hchouTW/hep-research/plugins/hep-research/profiles/reference/detector-atlas/README.md

# detector-atlas

A reference profile (kind `reference`): the sourced detector atlas of hep-research (work order item D13). It holds an
evidence ledger of detector facts for twelve experiments; the tool that validates, renders and queries it is
`skills/hep-detector/scripts/detector_atlas.py`. Start at [index.md](index.md).
