hchouTW/hep-research/plugins/hep-research/skills/research-communication/examples/README.md

# Worked Examples

Illustrative, not verified against any named experiment, codebase, or venue template. Each
file shows: request, diagram type, assumptions, source (Mermaid/DOT/TikZ/ASCII), validation
checks, caption. Mermaid sources were rendered with `mmdc`, DOT compiled with `dot`, and the SVG
example rasterized and inspected, and the TikZ sources (`hep/07` manual-placement Feynman, `hep/08`, `statistics/02`) compiled with Tectonic and inspected (`hep/07` also with LuaLaTeX and pdfLaTeX); the PlantUML sources (`computer-science/09-10`) were rendered with PlantUML and inspected. Render and inspect before publishing.

| Dir | Files |
|---|---|
| `general/` | research workflow, methodology pipeline (from a Methods excerpt), conceptual framework, experimental workflow, repository architecture (read a real repo first), Methods text -> workflow with the Known/Inferred/Assumed table, SVG-spec figure |
| `hep/` | collider pipeline, MC chain, detector schematic, likelihood architecture, decay tree, SR/CR workflow, Feynman-style, LHC pipeline in DOT + Mermaid + TikZ with a two-lane variant |
| `statistics/` | Bayesian workflow, hierarchical model (plates), causal DAG, MCMC, hypothesis test, bootstrap, HMM |
| `computer-science/` | microservices, Transformer, RAG, agentic AI, distributed pipeline, API sequence, database platform, ML training pipeline, PlantUML component diagram, PlantUML sequence diagram |

Repository architecture extraction is shown in `general/05` (a real repository, evidence table first).
