hchouTW/hep-research/plugins/hep-research/examples/ams-flux-ratio/output/ratio_per_period.png

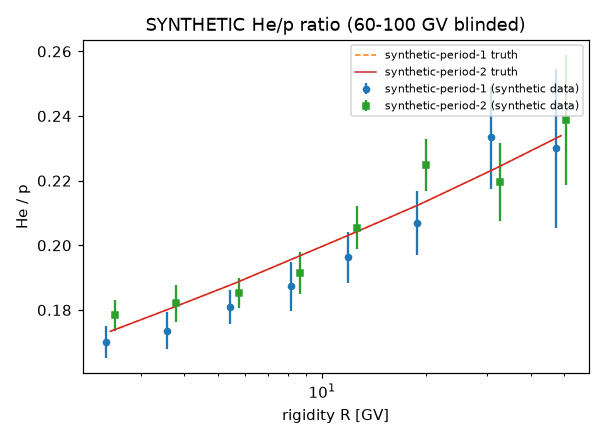
plugins/hep-research/examples/ams-flux-ratio/output/ratio_per_period.png
