hchouTW/hep-research/plugins/hep-research/examples/collider-angular/output/dsigma_dcos.png

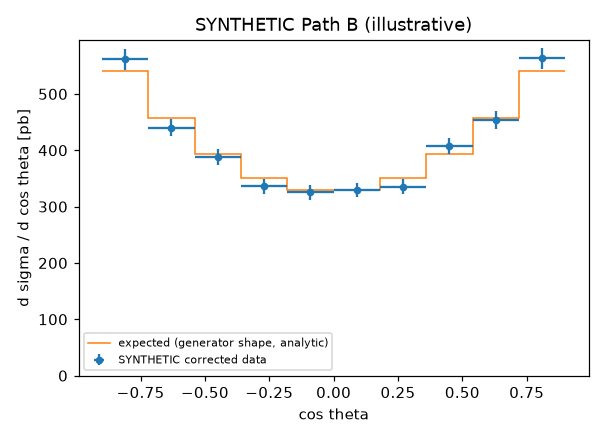
plugins/hep-research/examples/collider-angular/output/dsigma_dcos.png
