hchouTW/hep-research/plugins/hep-research/examples/detector-resolution/output/resolution_efficiency.png

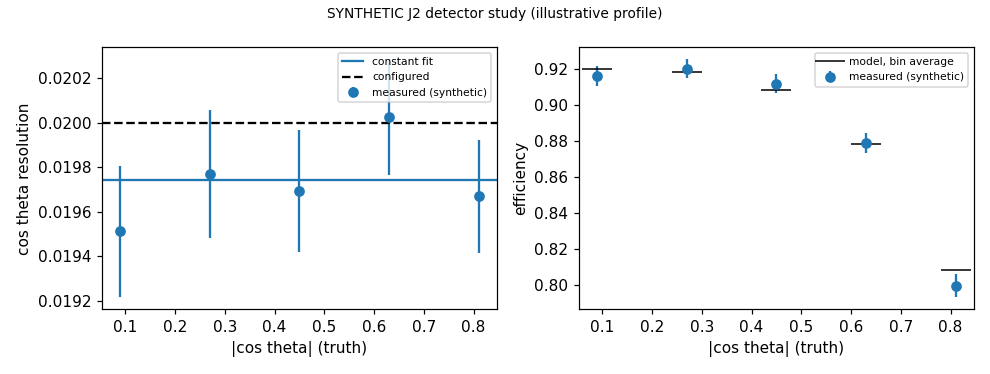
plugins/hep-research/examples/detector-resolution/output/resolution_efficiency.png
