hchouTW/hep-research/plugins/hep-research/examples/qed-prediction/output/dsigma_dcos_prediction.png

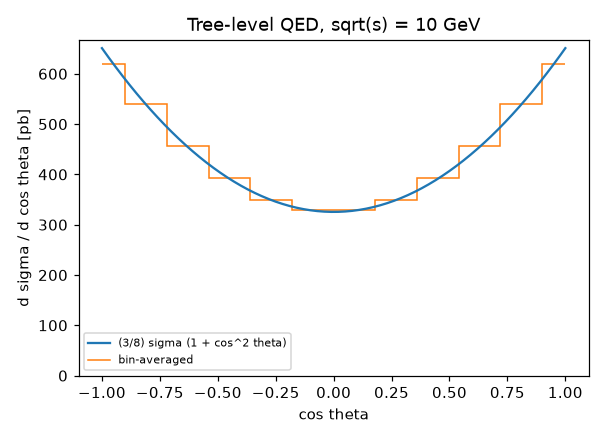
plugins/hep-research/examples/qed-prediction/output/dsigma_dcos_prediction.png
