hchouTW/hep-research/plugins/hep-research/examples/theory-comparison/output/folded_comparison.png

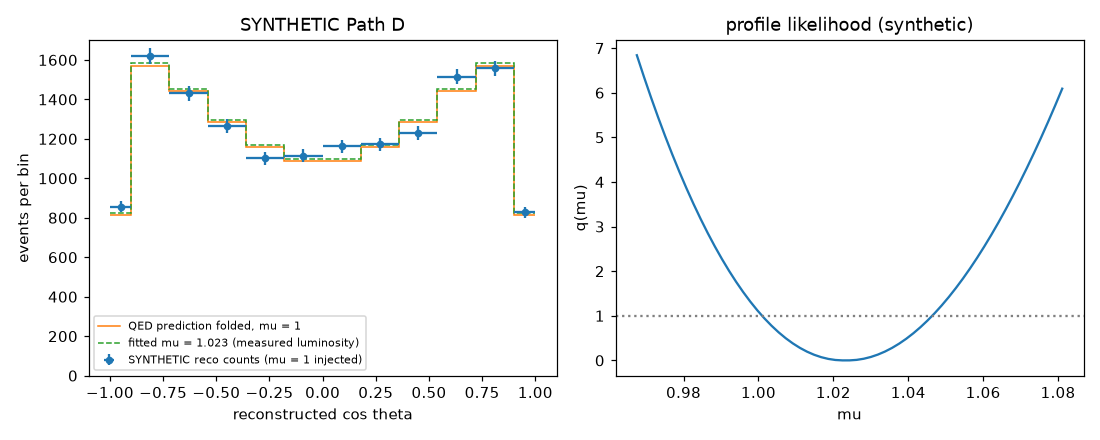
plugins/hep-research/examples/theory-comparison/output/folded_comparison.png
