hchouTW/hep-research/plugins/hep-research/skills/hep-measurement/assets/systematics.csv

name | source | effect | applied_via | affected_processes | correlation_key | payload | validation
example_energy_scale | detector energy calibration (synthetic placeholder) | migration | rerun selection with shifted object energies | signal;background | example_energy_scale | replace_with_official_payload | migration_and_closure
example_background_norm | control-region statistics (synthetic placeholder) | normalization | control-region constraint on the background yield | background | example_background_norm | replace_with_control_model | no_double_counting
