hchouTW/hep-research/plugins/hep-research/profiles/experiments/eic/datasets/README.md

# Datasets

None. The EIC has not taken data, so there is no published EIC dataset to record. A future dataset record follows the `dataset-record` artifact type with `eic:` evidence ids and transcribes no values the ledger has not read.
