hchouTW/hep-research/plugins/hep-research/skills/hep-detector/references/calibration-and-alignment.md

# Calibration and Alignment

Covers the constants that connect a simulated or idealized detector to the real one:
energy and timing calibration, alignment of sensor positions, their time dependence,
and how a change in any of them propagates through everything downstream. This is the
feedback loop that closes the chain from
[detector simulation](detector-simulation.md) back to
[event reconstruction](event-reconstruction.md).

## Calibration is a chain, and its order is part of the definition

A reconstructed energy or position is the product of a sequence of corrections -
pedestal subtraction, gain, channel-to-channel intercalibration, an absolute scale, and
finally residual corrections for known dependences. The sequence is not commutative in
practice, because later steps are derived assuming earlier ones were applied. Applying
a correction twice, or out of order, or mixing constants derived under different
upstream assumptions, are all common and all produce a scale error that is difficult to
diagnose from the final numbers alone.

Record the full chain, in order, with the payload version of each step. "Which
calibration was applied" is not a single answer.

## Test-beam versus in-situ calibration

**Test-beam** calibration measures the response of detector modules to particles of
known type and energy before installation. It gives an absolute, well-controlled
reference, but it applies to a small sample of modules, under conditions - no magnetic
field, no surrounding material, no pileup, pre-irradiation - that differ from the final
environment. Test-beam constants are a starting point, not a final answer.

**In-situ** calibration derives constants from the data itself, using physics that is
known independently: a resonance of known mass, momentum-energy consistency (`E/p`),
back-to-back balance in transverse momentum, or the uniformity of an isotropic flux.
It captures the real environment and its time evolution (LED, laser and
single-photoelectron monitoring also track gain drift without physics events, but not the
absolute scale), and it is what sets the achievable constant term of a calorimeter (see
[calorimetry](calorimetry-ecal-hcal.md)).

The limitation of in-situ calibration is circularity: the reference physics is measured
with the same detector being calibrated. A resonance mass calibration constrains the
energy scale at the resonance's energy and must be extrapolated elsewhere, and the
extrapolation - not the calibration point - is usually the dominant uncertainty. State
where the calibration is anchored and how far it is extrapolated.

## Alignment and weak modes

Alignment determines the actual positions and orientations of sensors, typically by
minimizing track residuals over a large sample. The residual-minimization approach has
a structural blind spot that deserves explicit attention.

**Weak modes** are coherent detector deformations that leave track residuals almost
unchanged while systematically biasing the fitted track parameters. Because the
alignment procedure minimizes exactly the quantity that weak modes do not affect, they
are invisible to it by construction, and internal fit quality gives no warning.

The dangerous ones bias curvature. A deformation that adds a curvature offset shifts
positive and negative particles in *opposite* directions - a charge-antisymmetric
rigidity bias - which directly fakes any charge-ratio or antiparticle-fraction
measurement, and which no amount of chi-square improvement will reveal. Because the offset is
additive in curvature, the relative bias `delta R/R ≈ -q R delta` grows linearly with rigidity,
mimicking or masking a spectral feature; charge-symmetric modes (a radial expansion, a field-scale
error) give a relative scale error constant in rigidity.

<!-- example: experiment-specific illustration -->
Three weak modes named in the CMS tracker alignment (JINST 9 (2014) P06009,
arXiv:1403.2286, sec. 4.4 and the summary) `[General method]`:

| Mode | Deformation | What the paper reports |
|---|---|---|
| twist | `Delta phi = tau z` | biases the track curvature `q/p_T`; controlled mainly by Z-boson decays (resonance mass with a common vertex) |
| sagitta (off-centring of layers and rings) | `(Delta x, Delta y) = sigma r (sin phi_sigma, cos phi_sigma)` | among the distortions most difficult to control; only partly recovered |
| skew | `Delta z = omega sin(phi + phi_omega)` | among the distortions most difficult to control |

Cosmic-ray tracks (which break the cylindrical symmetry), straight tracks taken with the
field off, vertex knowledge and resonance masses are the inputs the paper uses against
weak modes; the cosmic tracks have limited power against a twist.
<!-- /example -->

Weak modes must be constrained with information beyond the track residuals the
alignment fit minimizes (some of it, such as cosmic tracks or a resonance mass, can
enter the alignment fit itself, as in the example above):

- **A resonance of known mass**, whose reconstructed mass must not depend on the
  charge, the direction, or the momentum of its decay products.
- **`E/p` symmetry** between electrons and positrons - their calorimeter response is
  nearly charge-blind, so a charge-dependent electron `E/p` is a tracker alignment
  signature, not a calorimeter one. Hadron response depends on the charge (charge
  exchange of negative pions, antiproton annihilation, different proton and kaon
  content), so a charge-dependent hadron `E/p` is not by itself an alignment signature.
- **Cosmic-ray or halo tracks** traversing the detector, which are fitted as two
  independent halves and compared; a coherent deformation appears as a mismatch.
- **Comparison of independent subdetectors** measuring the same track.
- **Field-reversal or detector-inversion running**, where available, which changes the
  sign of the physics effect but not of the instrumental one, in detector coordinates; in charge-signed curvature the instrumental bias is the term that flips.

Every measurement sensitive to charge sign or to the high-rigidity spectrum should
state which of these constrains its charge-antisymmetric bias, and quote the resulting
limit as a systematic. See [tracking and vertexing](tracking-and-vertexing.md).

### Calibration standards and their pitfalls

- **`E/p` with electrons**: bremsstrahlung lowers the track momentum and the track momentum scale enters directly;
  use it with a bremsstrahlung-aware track fit, in bins where both are controlled.
- **A resonance mass**: fit the line shape (natural width convolved with the resolution, with a final-state-radiation
  tail), not the peak position; a peak position moves with the resolution and the radiation.
- **Low-momentum scale**: a low-mass resonance anchors the scale at low transverse momentum and the Z at higher;
  the extrapolation between the anchors in pT is part of the uncertainty.
  <!-- example: source citation -->
  In CMS muon performance (JINST 7 (2012) P10002, arXiv:1206.4071, section 6; read 2026-10-22) the J/psi and Z
  dimuon masses calibrate the scale below about 100 GeV/c and cosmic-ray muons above it, and the bias found with
  the Z is larger than with the J/psi (pT dependent).
  <!-- /example -->
- **MIP calibration**: use the most probable value of the Landau-like deposit, not the mean, which is pulled by the
  tail (PDG RPP 2024, Passage of particles through matter, secs. 34.2.3 and 34.2.9). The most probable loss is not
  proportional to path length (per unit length it grows as `a ln x + b`, PDG Eq. 34.12), so a pure `1/cos theta`
  correction leaves an angle-dependent bias (in 300 um silicon about 1% at 30 deg and 5% at 60 deg): compare MPVs
  at fixed path length (angle bins) or correct with the Landau-Vavilov-Bichsel thickness dependence.
- **Intercalibration**: pi0 and eta diphoton masses, or phi symmetry of the deposited energy, equalize channels; the
  absolute scale still needs a reference.
- **Hadronic calorimeters**: `E/p` of isolated single hadrons, with its own selection bias from the isolation cut.

## Adding a tracking layer to a running detector

A layer added to a spectrometer that is already taking data changes the tracking, the alignment and the acceptance at
once, so data before and after it are separate detector eras (see "Monitoring stability over time" below for the
boundary between them):

- **Outer lever arm and weak modes.** A layer far from the others lengthens the lever arm, so the curvature
  resolution improves (the intrinsic term scales as 1/(B L^2)), but the curvature of tracks that use it depends on
  the position of one plane far outside the rest: a shift of that plane is a curvature offset, the weak mode that
  fakes a charge-antisymmetric rigidity bias. Its alignment needs a constraint that residuals alone do not give
  (beam-test or survey positions, the momentum scale from a known mass or from cosmic-ray tracks of both charges
  with the same rigidity spectrum, the energy-momentum match of electrons in a calorimeter).
- **Stereo planes.** If the layer measures one coordinate, or both with a stereo angle, state which track parameters
  it improves; a layer without a measurement in the bending plane adds material and acceptance, not resolution.
- **Alignment with existing tracks.** Align the new layer with tracks reconstructed by the existing layers alone (an
  extrapolation that is independent of it), then refit with it; check the residual widths against the extrapolation
  error, and the residual means against the charge sign separately.
- **Time dependence.** A new structure settles mechanically and thermally after installation; monitor its alignment
  per period (stability_monitor.py) and expect a calibration era of its own at the start.
- **The rigidity scale with and without the new layer.** On the same events of the new era, refit without the new
  layer and compare the two rigidity scales per charge sign; on independent samples (before and after), compare the
  flux or ratio in the overlap with a split-consistency test (hep-statistics). A difference is a residual of the
  scale or of the curvature offset: hand the per-era residuals to `propagate_scale_distortion.py` to turn them into
  yield shifts and a correlated covariance block.
- **Acceptance and exposure change with the era.** The geometric acceptance, the selection efficiency and the
  response matrix are era-dependent: build them per era and combine eras with their exposure, never by averaging
  the detector configurations.

<!-- example: a planned outer silicon layer on a space-based spectrometer -->
The AMS-02 Layer-0 upgrade (public sources only) adds a new silicon microstrip tracker layer on top of the existing
detector. The beam-test paper arXiv:2603.25085 (abstract read 2026-10-17; full text not read) reports flight-model
ladders of 8 to 12 silicon microstrip sensors in series, tested in a 350 GeV mixed hadron beam at the CERN SPS, with
an intrinsic spatial resolution at normal incidence from 9.5 um to 11.4 um, and states that the layer increases the
cosmic-ray acceptance by a factor of 3; the profile claim ams02:C101 records the gain as "300%" as quoted by the AMS
website and a CERN news item (promotional wording, a factor of 4 if read literally, so not to be equated with the
factor of 3; not an analysis acceptance). For an analysis this means a new
detector era with its own acceptance, alignment and rigidity scale; the era boundary must come from the
experiment's own sources (the installation and commissioning dates), not from a change point found in the data.
<!-- /example -->

## Time dependence and conditions data

Detectors change: gains drift with temperature, sensors accumulate radiation damage,
gas composition and pressure vary, channels die, and alignment moves with thermal
cycles and magnet ramps. Calibration constants are therefore time-dependent payloads
indexed by run or by a finer interval-of-validity, and this creates its own set of
requirements:

- **Simulation must follow the conditions run by run or period by period**: assign
  simulated events to runs or periods in proportion to the luminosity or exposure
  actually collected, each with that period's conditions (or simulate each period
  separately and combine them with exposure weights). Do not average the conditions
  themselves: in general `sum_t w_t R(theta_t) != R(sum_t w_t theta_t)`, especially for
  thresholds, dead channels and non-linear gain, and an averaged dead-channel mask
  describes no real detector state. A simulation using a single snapshot of the
  dead-channel map or the gain set is likewise wrong for the dataset as a whole.
- **Analyses combining periods must confirm the constants were applied consistently**
  in each, and must check stability by repeating the measurement per period. A
  result that varies across periods beyond its statistical uncertainty has an
  unaccounted conditions problem, and finding it after unblinding is much worse than
  finding it before.
- **Reprocessing changes results.** A sample reconstructed with a newer payload is a
  different sample; mixing processings within one measurement requires explicit
  justification and a comparison.
- **Interval-of-validity boundaries are a real failure mode.** Data near a boundary
  can pick up the wrong payload if the intervals are misaligned with the run
  structure, producing a small population of badly-calibrated events that shows up as
  a non-Gaussian tail rather than a shift.

## Monitoring stability over time

A per-period value with its uncertainty (a gain, a scale, a resolution, an efficiency) is tested for stability with
`<plugin root>/skills/hep-detector/scripts/stability_monitor.py` (statistics in `core/stats/change_point.py`):

- **Trends first.** Weighted constant and linear fits with chi2 and p-value. A poor constant fit without any step
  means a drift, or uncertainties that are too small; fix the uncertainties before trusting any threshold.
- **Change points with a declared false-alarm rate.** A step is tested with z = |m2 - m1| / sqrt(1/W1 + 1/W2) at the
  best split (binary segmentation for several steps), and a two-sided CUSUM catches slow onsets. Both thresholds
  are calibrated by seeded toys with the series' own uncertainties so that the chance of a false change anywhere in
  the series is the declared rate; quote the rate, the toy count and the seed with the result. A threshold "at
  3 sigma" on the largest of many splits is not a 3 sigma test.
- **Tolerance is separate from significance.** Periods out of a declared tolerance around a reference are listed
  apart from change points: a significant 0.1% step may be harmless, a 2% excursion of one period may matter.
- **Era boundaries are proposals.** Each change point is proposed as a boundary of kind `calibration`, with the step
  and the times around it. The tool never writes it into a measurement spec: the analyst checks it against the
  run log (a magnet ramp, a reprocessing, a hardware change) and enters an accepted boundary with its source. A
  hardware change such as an added layer is an era of its own even when no step is visible.

## Propagating a calibration change

Because a calibration constant sits at the base of the chain, changing it changes
efficiencies, resolutions, scale factors, background estimates derived from control
regions, and the trained response of any classifier that used the affected variables.
A calibration update is therefore not a local change:

- Re-derive, do not reuse, any scale factor or data-driven background estimate that
  was measured with the old constants.
- Re-validate classifiers whose input distributions have moved, following
  [multivariate-analysis-bdt-nn.md](../../hep-ml/references/multivariate-analysis-bdt-nn.md).
- Compare the affected distributions before and after with an explicit method - event
  counts per cut, histogram integrals, maximum absolute and relative bin difference -
  as required for any change that risks altering physics output.
- Keep the calibration uncertainty correlated across regions and samples where it
  shares a source; treating the same energy-scale uncertainty as independent between a
  signal and a control region is a standard way to understate a systematic. See
  [systematics.md](../../hep-measurement/references/systematics.md).

## Propagating a calibration residual

A calibration change is re-derived; a calibration *residual* (the uncertainty left after the best calibration, or a
weak-mode bound) is propagated as a systematic. Declare its form, then compute what it does to every bin:

| Form | Model | Effect on a power law `dN/dx ~ x^-gamma` |
|---|---|---|
| Scale | `x_m = (1+s) x` (energy or momentum scale) | every bin `(1+s)^(gamma-1) - 1 ~ (gamma-1) s`, the same in all bins |
| Inverse offset | `1/x_m = 1/x + q delta` (curvature offset, e.g. a weak mode) | density factor `(1 - q x_m delta)^(gamma-2)`, first order `(2-gamma) q x_m delta`: grows with x_m, opposite for the two charge signs |
| Resolution | core and tail widths scaled by `1 +/- r` | factor `E[(1+eps)^(gamma-1)]`, about `1 + (gamma-1)(gamma-2) sigma^2/2` for a Gaussian |

- **Opposite-sign ratios.** One curvature offset moves both operands, in opposite directions: the signed shifts
  subtract and their magnitudes add. A ratio does not cancel this residual; it doubles it. Same-sign operands with
  different spectral indices cancel only partly.
- **Validity.** In the inverse-offset row, x_m is the measured value (the bin value), x the true one. The tool warns
  when `|q x_m delta|` exceeds 0.3, a conventional threshold, not a derived bound: the error of the first-order form
  depends on gamma (at 0.3 about 1.4% of the factor at gamma 2.7, 3.8% at gamma 1.5, none at gamma 2 or 3), so use
  the exact factor where `|q x_m delta|` is not small. At `q x_m delta >= 1` the mapping is no longer one-to-one and
  events change charge sign (see [charge-confusion.md](charge-confusion.md)).
- **No default size.** `s` or `delta` comes from the calibration itself (a reference line, E/p, a known-mass peak,
  the external constraint on a weak mode), never from a typical value.
- **Deliverables.** Per-variation yields and per-bin shifts, `{nominal, up, down}` for
  `check_systematic_variations.py` (with the variance of the *difference*, because the variations reuse the same
  events), a fully correlated covariance block, and the ratio shift. A validation record that states the
  correlation between operands is written only on request.

Tool: `propagate_scale_distortion.py` (`response`: analytic yields for power-law components; `events`: the same
distortions applied to an event table; modes `scale`, `inverse-offset`, `resolution`, `plugin`). A seeded test
sample comes from `toy_spectrometer.py`.

## Iterative loops as contract steps

A loop feeding constants derived from reconstruction back into it is recorded so that the passing round cannot be
picked after seeing the results (iterative unfolding is regularization, hep-statistics).

- **Rounds are steps.** Each round is one or more steps of the task contract (a round may be partitioned: per-chunk
  refits with the previous constants and a global solve), labelled with the loop (family) and round; its identity
  includes the inputs it consumed, and its output is a new conditions payload with a producer edge.
- **Fixed before starting.** The first contract fixes the final round and, by check digest, the **convergence check**
  and the **unconstrained-mode check**; rounds are exactly 1…final round and chained (every step of a later round
  consumes the previous round, directly or through steps of its own round). Only the final round's single checked
  step — the final step — is checked, and both checks are required on it, never not-applicable. The final round is the
  cap; there is no “maximum number of rounds”.
- **Changing the number of rounds needs a human.** Not converged at the final round → held (the convergence check
  fails); to run more, attach the convergence record and ask for a contract that adds rounds, which demotes the old
  final step and moves the two checks to the new one; the old non-convergence stays in the history. Converged early →
  run on to the final round, or ask a human to approve shortening. Loosening the convergence criteria also needs a
  human, and “not converged” under the original criteria is never rewritten as converged.
- **Members other than the final step** are exempt from checks (`iteration_internal`, then `superseded_by_iteration`);
  steps outside the loop consume only the final step. After constants change, artifacts that consumed the old ones
  are invalidated unless the contract deliberately pins the old constants.
- **Convergence is numerical stability, not validation.** Every loop — and every single-pass alignment or
  intercalibration solve, which has the same modes — lists its unconstrained global modes and the external
  information that constrains them (cosmics, overlaps, vertex or mass constraints, an external scale), and validates
  with observables sensitive to them (a resonance mass versus η, φ and charge; E/p). φ-symmetry fixes only constants
  within an η ring (ring-to-ring and global scales need external input; real φ dependence absorbed is a systematic).
  Splitting same-kind tracks is an optional closure that cannot see weak modes. A quantity used in the derivation (a known mass) no
  longer validates it independently.
- Downstream artifacts record which round's constants they used.

**Check:** Final round, convergence and mode checks fixed first; modes and their constraints listed.

## Common misconceptions and failure modes

- **Tuning on the measured observable**, then reading agreement as validation (circularity).
- **Calibration order treated as irrelevant.** The order of the chain is part of the definition of each constant.
- **Test-beam constants applied unchanged in situ**, or a calibration applied to data but not simulation.
- **A good alignment `chi^2` taken as proof of correct alignment.** Weak modes leave it nearly unchanged.
- **Constants assumed static.** Intervals of validity, temperature, high voltage, and dose all move them.

## Deliverables

- The calibration chain in the order applied, with the payload version of each step.
- Which constants come from test beam and which from in-situ measurement, with the
  in-situ anchor point and the range over which it is extrapolated.
- The alignment procedure, the weak modes considered, and the external constraint
  bounding a charge-antisymmetric rigidity bias, with its quoted limit.
- Time dependence of the constants, and confirmation that simulation assigns events
  to runs or periods with their own conditions in proportion to the exposure (or
  combines per-period simulation with exposure weights), rather than using a snapshot
  or averaged conditions.
- A per-period stability check for any measurement combining data-taking periods.
- For any calibration update: what was re-derived, what was re-validated, and a
  before/after comparison of the affected distributions.
- Correlation treatment of calibration uncertainties across regions and samples.

### Naming: calibrations, conditions tags and efficiency maps (N11)
- **Extractor:** `extract_names.py --surface N11` (hep-detector; inputs: response artifacts and their matrix references, conditions fields and era versions, configuration keys and Python assignments of global and conditions tags)
- **Entity kinds and level floors:** generated from `contracts/naming/surfaces.json`, not restated by hand:

<!-- naming-kinds:N11: generated from contracts/naming/surfaces.json by contracts/naming_registry.py sections; do not edit -->

| Kind | Level floor | Format | Rename policy |
|---|---|---|---|
| `project_output` | C2 | — | matrix |
| `conditions_tag` | C2 | — | matrix |

<!-- /naming-kinds:N11 -->

- **The name must say:** the detector quantity, the method and the period a calibration or map covers (`muon_id_eff_tnp_2018`); a conditions tag is quoted exactly as the conditions database gives it
- **Rename policy:** matrix; conditions tags are C4 (`source: external`): never renamed, only mapped
- **Rules:** see the registry for surface N11 (`naming.common.*`, `naming.n11.*`, `naming.cross.*`)
- **Good / bad:** `ecal_energy_scale_2017`, `muon_id_eff_tnp_2018` / `calib_new`, `eff_map2`

Procedure, levels and report: [semantic naming charter](../../hep-computing/references/semantic-naming.md).
