hchouTW/hep-research/plugins/hep-research/docs/dev/simulator-calibration/simcal-tasks/phase-1.md

# Simulator calibration phase 1: Evaluation and design stage

## Background

Phase 1 of the simulator parameter calibration workflow (Part B, `simulator-calibration-v7.37.4-clean-en.md`, §17, line 3579). This is a **draft** written with the task package of 2026-11-10: phase 0 refreshes it from Part B and `simcal-decision-index.md`, lints it and registers it before any run a threshold judges (`simcal-task.md`, Sections E4 and E9). The §17 text and the §8.7 rows below are copied verbatim from Part B; the lists marked **Inferred** are the drafter's reading of which scripts and test sections the content touches.

This card uses the headings `lint_task.py` requires, and carries the eight sections of `simcal-task.md` Section E5, in E5's order, as level-4 headings under them.

## Objective

#### Goal

Deliver the content of phase 1 of §17 so that its gate holds: The negative tests of A0, P0, P2, P5 pass; reweighting and rerun agree

## Scope

### In Scope
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
