hchouTW/hep-research/plugins/hep-research/examples/ml-classifier-to-inference/output/scores_and_calibration.png

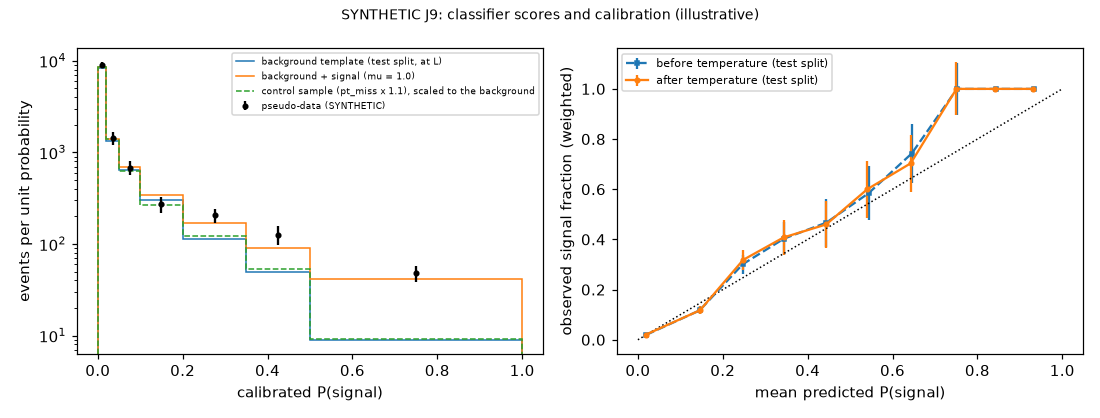
plugins/hep-research/examples/ml-classifier-to-inference/output/scores_and_calibration.png
