hchouTW/hep-research/plugins/hep-research/skills/hep-computing/assets/risk-register.md

# Risk Register

| Risk | Impact | Likelihood | Mitigation | Validation | Owner/Status |
| --- | --- | --- | --- | --- | --- |
| `<risk>` | `<user/operator/dev impact>` | `<low/medium/high>` | `<design/test/rollout action>` | `<command or manual check>` | `<owner/status>` |

## Notes

- Keep risks concrete and tied to the current increment.
- Remove risks that are no longer relevant after validation.
- Convert unresolved risks into follow-up work only when they are outside current scope.
