hchouTW/hep-research/(commit log)

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2026-10-07 Pin ams02-research to 615b48e in the Codex marketplace (#1)
    Codex url sources honour "sha": an unknown sha fails with "unable to
    read tree", and 615b48e installs the same files as the Claude Code
    entry, which is already pinned to this commit.
2026-10-07 sci-fix: Feldman-Cousins upper ends follow the published construction (T01)
    fc_interval returned the plain belt at a single background, whose upper end
    is not monotone in b: 1.08 at n0 = 0, b = 2, 90% CL, where Feldman and
    Cousins (1998) Table IV gives 1.26. The unit test pinned the plain value, so
    it hid the difference. The paper (Sec. IV.B) forces the upper end to be
    non-increasing in b by lengthening intervals; that construction is now the
    default: the supremum of the plain upper end over b' in [b, b + 6], from a
    coarse scan, a finer rescan of cells that could beat the maximum, a bisection
    to each jump and a finer grid just before it (a new top segment starts
    narrower than the signal grid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
2026-10-07 sci-fix: covariance matrices are no longer repaired silently (T03)
    statistical_toys._cholesky added an absolute jitter of 1e-10, growing to 1.0,
    until the factorization succeeded, and never said so: the constant-ratio
    fit of ratio-measured gave chi2 = 9.0e13 and no error for a correlation of 2,
    ratio-measured sampled from such a matrix, and response-measured added 1e-14
    to every variance before checking it. The comment that ratio_measured raises
    on a non-PSD input was not true.
    A new private core/stats/_linalg.py owns one strict Cholesky, used by
    statistical_toys (ratio-cov kernels, ratio-measured sampling, the constant
    fit), unfolding_diagnostics (response-measured) and likelihood_limits
    (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
2026-10-07 sci-fix: Poisson limits are no longer clipped at a mean of 500 (T04)
    upper-limit and interval bisected on [0, 500] without checking that the
    range bracketed the root, so a root beyond it came back as the range end:
    central_interval(490) gave an upper end of 500.0 (Garwood: 513.15) and
    upper_limit(495, 0) gave 500 (533.19). The search range now follows the
    count, every bisection checks its bracket, and an unbracketed root raises
    SolveFailed: the CLI reports status "failed" with exit 1, never a number.
    The three MAX_MEAN constants (500, 500, 1e5) are one, 1e5, owned by a new
    private core/stats/_poisson.py. Its distribution, tail and quantile are summed
    in log space outward from the term neare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
2026-10-07 sci-fix: malformed contracts and ledger input give findings, not tracebacks (T05)
    Reproduced crashes: the gate sorted structured cuts with null (open) bounds
    by comparing None with numbers, and read "phase_space": null and
    "normalization": null as objects (both schema-valid for cuts; the nulls reach
    the gate through combination and model sets); validate_artifact hashed a list
    or object artifact_type; the ledger raised on a non-object record, a string
    year or data_taking_period, list-valued ids and a dated source without an id.
    A seeded mutation fuzz found 44 crash signatures in 3,000 iterations.
    - gate: cuts sort with a total order that admits null bounds; explicit nulls
    read as absent bl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
2026-10-07 test: published-table regression tests (T07)
    New tests/core/test_published_tables.py gathers every published reference,
    each transcribed by script into tests/core/fixtures/ with its source:
    - Feldman and Cousins (1998) Tables IV and VI, n0 = 0..10, b = 0..5, within
    0.01 (moved here from test_stats_poisson; slow tier).
    - PDG 2024 Statistics review, Table 40.3: one-sided Poisson limits with no
    background at 90% and 95% CL, checked against upper_limit and against
    the Garwood central-interval ends at 80% and 90% CL, to the printed
    precision (fast tier).
    - PDG 2024 Table 40.4 (unified intervals, no background): checked against
    fc_interval (slow tier) and against the FC fixture's b = 0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
2026-10-07 test: schema mutation fuzzing and a schema-keyword meta-test (T09)
    - tests/contracts/mutations.py: seeded mutations (null, type swap, list wrap,
    deletion; random replacements) shared by the robustness tests.
    - test_robustness.MutationFuzzTests: in the fast tier, every node of every
    valid artifact fixture (over 1,000 single mutations, 2.5 s), every node of
    a full gate plan and of a ledger source and claim; in the slow tier,
    10,000 random multi-mutations through validate_artifact, the gate check()
    and check_ledger over the shipped ledgers (17 s). Nothing raises. It
    replaces the 300-mutation test added for T05.
    - contracts/schema.py names the keywords it implements
    (SUPPORTED_KEYW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
2026-10-07 test: cover public functions and scripts no test reached (T11)
    - Blinding: scan_file (text, .npy, binary) and load_project_blinding.
    - Covariance: clip_demo leaves its input unchanged and reports the clipped
    eigenvalue of an indefinite matrix; weights are used.
    - Partition: campaign.chunk_status for planned, running, repeated-failure,
    reset and done chunks.
    - Evidence: load_ledger and render_tables.
    - Contracts: new tests/contracts/test_contract_helpers.py for
    check_conventions, check_finite, check_binned (one and two axes, a traced
    unit conversion), check_observable, load_schema, side_from_artifact,
    find_cycles, check_profile_dir, declared_namespaces and namespace_of.
    - Kinematics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
2026-10-07 test: every script is a well-behaved command-line tool (T12)
    tests/skills/test_cli_robustness.py runs each of the 64 scripts under
    skills/*/scripts/ and adapters/*/assets/ with python3 -I from a temporary
    working directory:
    - --help exits 0 with output and no traceback;
    - pointed at a missing input file, the script exits non-zero with at most a
    few lines (or a JSON error report) and no traceback.
    A table gives each script's missing-file arguments, or the reason it reads
    no file; an inventory test fails for a script that is not in the table.
    The test passes both with the optional stack (ROOT, torch, uproot, pyhf)
    and in a venv with none of it.
    Fixed:
    - tracebacks on a missing input in eft_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
2026-10-07 sci-fix: campaign submissions are recorded first and locked (T15)
    core/partition/campaign.py:
    - submit() wrote the submission and its attempts to state.json only after
    executor.submit() returned: a kill in between left jobs at the scheduler
    that the campaign did not record, and the next submit sent the same
    chunks again. Submission IDs came from len(submissions) with no lock.
    - Now every call that changes a campaign (submit, resubmit, reset, cancel,
    collect, poll, watch, and the new confirm/abandon) holds an exclusive
    fcntl lock on <campaign>/.lock; nested calls in the same thread reuse it,
    and another thread or process gets CampaignError("campaign.locked") at
    once. submit() sa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
2026-10-07 refactor: one owner for each numerical helper in core/stats (T16)
    core/stats/_linalg.py now owns jacobi_eigh (both former eigensolvers, with
    each caller's stopping rule and sign convention kept as a parameter so
    results are bit-identical), solve (Gauss-Jordan, from unfolding), chol_solve,
    matmul, transpose, bisect, golden_min and scan_then_golden, next to the
    Cholesky from T03. A new core/stats/_validate.py owns the number, seed and
    toy-count checks (each raises the caller's error class); _poisson.py gains
    the chunked sampler of statistical_toys. The modules keep their private
    names as aliases or one-line wrappers; core/OWNERS.json lists _validate.
    likelihood_limits and template_fit no longe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
2026-10-07 ci: run the test suite on every push (T13)
    .github/workflows/tests.yml:
    - checks: unit tests (fast tier), profile suites and the static checks
    (run_all_checks.py --no-cli --jobs 4) on Python 3.11, 3.12 and 3.13 with
    requirements-ci.lock; the check-run JSON is kept as an artifact.
    - lint: ruff and mypy on core/ and contracts/.
    - optional jobs, continue-on-error for now so they do not block a merge
    but show their result: the unit tests with pyhf, with uproot + awkward +
    PyYAML, with PyTorch and torchvision (CPU wheels), and in the
    rootproject/root:6.38.00-ubuntu25.10 container with PyROOT.
    - latest: weekly (Mondays 05:17 UTC) and on demand, the latest releases
    without the lock plus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
2026-10-07 docs: fix documentation drift (T27)
    - capability-matrix header: v0.2.0 -> v0.3.0.
    - VALIDATION.md AC26-AC28 cited DECISIONS.md as present; it was removed
    with the pre-release records in 0.3.0, and the row now says so.
    - docs/maintenance.md listed the traceability check removed in 0.3.0 and
    used its test module as the example; both replaced.
    - docs/architecture.md section 7 and docs/architecture-review.md risk 9:
    remeasured with measure_entrypoints.py (0.3.0, CLI 2.1.292): SKILL.md
    5,602-8,185 B, descriptions 765-990 characters, registry 1,240 B, about
    2,205 always-on tokens; the M1 numbers are kept and dated.
    - Routing counts: the 48- and 62-case results are dated as the case sets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
2026-10-07 feat: saturated-model goodness of fit for shape-limit models (T22)
    likelihood_limits.py shape-gof: Poisson bins and constraint terms
    against the saturated model, mu fitted or fixed, toy-calibrated from the
    fitted model. Null distribution against chi2, uniform toy p-values at
    low counts, and an independent deviance check.
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2026-10-07 eval: full live routing run, 143/150 on claude-sonnet-5-5; baseline (T19)
    150 cases, $11.67. Misses: 2 quick questions and 1 proposal request
    without a skill, 2 handoff second turns without a skill, 2
    underspecified cases. Harness: input files in subfolders, a failing
    case is recorded instead of aborting, --reuse-raw resumes a run.
2026-10-08 chore: pin ams02-research 1.0.1 in both marketplaces
    ams02-research 1.0.0 (615b48e) requires hep-research ^0.3 and fails to load
    next to hep-research 0.4.0. Pin 1.0.1 (1c3f590), which requires ^0.4.0, in the
    Claude Code and Codex marketplace manifests.
2026-10-08 fix: explain a missing SymPy in derive.py and the qed-prediction example (SYMPY S03)
    Both theory-profile derive.py scripts and examples/qed-prediction/run.py now
    print a JSON failed status naming the missing package, with a hint, and exit 2
    instead of a ModuleNotFoundError traceback. --help works without the packages.
    Importing derive as a module still raises, so callers see the error.
2026-10-08 feat: find_python.py finds an interpreter with the packages a task needs (SYMPY S01, S02)
    Stdlib-only. Candidates in a fixed order: --python, HEP_RESEARCH_PYTHON, the
    calling interpreter, python3 on PATH; nothing is scanned. Each is probed in a
    subprocess from an empty directory, must be Python >= 3.11 and import every
    --require package (default sympy). JSON status with the chosen path, Python and
    package versions, and every candidate's reason. Exit 0 found, 1 failed, 2 usage.
2026-10-08 fix: blinding tools give agents a fixed status only and fail closed on bad inputs (AGENTIC-R5 T0.6, U11, N09-N16)
    - N09: audit scan prints pass/fail/incomplete only; per-hit details go to
    --report (refused inside the outputs). The tolerance comes from the sealed file
    (seal --rtol, at most 1e-6); scan has no --rtol. An empty or malformed sealed
    file is an error. check_figure findings no longer carry sealed values.
    - N10: seal prints no count.
    - N11: seal adds the difference of sums, square roots, fractions of the total,
    reference/data and (N-B)/sqrt(B); NOT_SEALED documents the rest.
    - N12: dropped or flipped signs, Unicode minus and percentages are detected;
    OUT_OF_SCOPE_RENDERINGS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
2026-10-08 fix: release-tree checks: identity verified before file-read tracing, manifests are not citations
    With release-manifests/0.5.0.json present, plugin_release() verifies the tree and
    so reads every plugin file. The qed-prediction and published-comparison examples
    trace their file reads (zero experiment resources), so they now compute the
    identity once before the audit hook starts; their outputs are regenerated (the
    file-read lists lose the identity reads). reference_inventory no longer counts
    the release manifests, which list every file, as citations.
    The recorded manifest is regenerated: release-manifests/0.5.0.json digest
    6b793584a1b300da6618665ff07cc4b1216d0249827c20eff30e81f3379a1db1 (1033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
2026-10-08 feat: companion profiles go through their own preflight; validator CLI fixes
    - context stanza: a companion's profile (including a local path known to be the
    companion's) is used only via its <plugin>:profile skill after its preflight;
    nothing scans for companions; a failed preflight leaves other work going.
    Byte-neutral (SKILL.md budget).
    - docs: drop the advice to declare a host dependency on hep-research; package
    compatibility and profile validation are separate; migration note.
    - registry.py/project.py: a dangling --local/--registry is exit 2 with JSON,
    not a traceback with exit 1; one folder given twice is one profile.
    - tests: CLI cases a companion checker relies on, stanza te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
2026-10-08 fix: stanza keeps ordinary local profiles generic; READMEs state the current AMS pin
    Review fixes: the companion route applies to a bound profile in neither place or at
    a local path known to be a companion's (an unregistered user local profile is not a
    companion's); the skill that names it is loaded; the model says it is unavailable.
    READMEs say the catalogs still pin ams02-research 1.0.1 (^0.4.0), so uninstalling
    it is the only release for now.
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2026-10-08 fix: second review follow-ups for T4.4/T3.4
    Legacy looked_at is read as unexposed only in a closed vocabulary (one kind of
    control, sideband, simulation, calibration or validation data per entry); any other
    wording is unknown. Unknown and abandoned attempts count as running until a poll
    ends them or clear_orphan_risk (CLI clear-orphans) records that every job under the
    submission tag has ended; submit time plus walltime no longer bounds them.
2026-10-08 fix: closed command grammar for bundles; strict release-checker inputs
    The command is an absolute interpreter, an absolute bundled worker script, then
    flags, single placeholders, numbers, plain ASCII words or absolute bundled worker
    paths (not links), each re-resolved by verify. The worker root may not contain the
    campaign. The release checker refuses malformed approver lists, ledger and
    revocation entries instead of skipping them.
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2026-10-08 feat: tool contracts and operator semantics for bounded recipes (T4.7, T4.6)
    T4.7 (F14, F16): contracts/schemas/tool_contract.json and contracts/tool_contract.py;
    per operation the options, inputs/outputs with kinds and units, failure exits,
    capabilities, purposes, operators and side effects, compared with the tool's
    --help in both directions; --scope coverage. First contract: cosmic_ray_flux.
    cosmic_ray_flux.py now refuses levels outside (0, 1) and under/overflow (exit 2).
    T4.6 (F04, P05): operator_semantics.json, recipe.json, the differential-flux
    table and the flux-from-counts recipe bound by digest; contracts/recipe_semantics.py
    checks kind chaining, ordering, repeated corrections acros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
2026-10-09 Lessons from the B/C synthetic twin: profile-vocabulary hint and guidance
    - contracts/schema.py: an unknown vocabulary term with a profile prefix now
    says to validate with --profiles-from <project config>; the plugin's own AMS
    example artifacts failed without a hint. New test: the hint, no hint for
    unprefixed terms, and every shipped AMS example artifact validates with the
    profile bound (skipped when the optional AMS profile is absent).
    - hep-statistics inference-recipes: measured Wilks under/over-coverage at low
    counts and the toy-calibrated Neyman fix; yield-scaled backgrounds belong in
    the likelihood.
    - hep-analysis systematics: testing a variation's shift (Barlow subset
    app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
2026-10-09 research-communication: look up identifiers a ledger row lacks
    An arXiv number, DOI or INSPIRE record missing from a ledger row is looked up
    at a reachable primary source (INSPIRE-HEP, arXiv, doi.org) and reported as
    looked up (source, date), not as a ledger claim; never from memory. SKILL.md
    invariant (6593 bytes, budget 8192) and an AMS source-policy rule. Checked
    live in a sandboxed configuration with this branch's plugin. Quick checks:
    entrypoint budgets, instruction text, routing, ownership, reference
    inventory, AMS profile tests.
2026-10-09 chore: release 0.6.2
    Version 0.6.2 (plugin.json for Claude and Codex, pyproject.toml, README,
    CHANGELOG) with PR #22 (research-communication looks up identifiers a ledger
    row lacks). Examples regenerated with the E2 venv (version strings only;
    unfolding-coverage left as committed). README size statement 6.9 -> 7.7 MB
    (the release manifests grew the package; packaging_scan reported the drift).
    Code release manifest release-manifests/0.6.2.json: 1057 files, digest
    5324adc86e335f345004816381d6f3cee4b94203d484841a9e426ac46f56b5c0.
    run_all_checks: 20/20, 1824 unit tests.
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2026-10-10 hep-computing: CERN EOS storage note (work order T06)
    New reference skills/hep-computing/references/storage-cern-eos.md: what EOS is,
    addressing an instance, copying with checksums, the mount versus root://,
    versions, recycle bin, quota, ACLs, tokens, and remote reading from ROOT and
    uproot. Each row cites the EOS project site or the EOS 5 documentation (read
    2026-10-10) or an observation on lxplus with synthetic files.
    Linked from SKILL.md (Resources trimmed to stay within 8,192 B), the HTCondor
    site note's EOS row and a new remote-files section in
    python-hep-coding-patterns.md. Reference inventory regenerated; CHANGELOG and
    VALIDATION updated. Gate: 20 pass / 0 fail / 0 skip.
    Co-Authored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
2026-10-10 hep-computing: observe the EOS rows of the CERN HTCondor site note (T06 E2f)
    One espresso job (HTCondor 24.12.16, getenv = false) read a synthetic file from EOS with xrdcp and returned two files
    through output_destination with MY.XRDCP_CREATE_DIR. Observed: Kerberos and AFS credentials and the EOS mount are
    present in the job, checksums match, and output/error are sent to the destination too (only the user log stays on
    AFS). Site note rows, CHANGELOG (Unreleased) and VALIDATION updated; documentation only.
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2026-10-10 hep-computing: NSTCCore Slurm site note and the batch adapter's first real Slurm campaign
    - New reference skills/hep-computing/references/batch-site-nstccore-slurm.md: what Slurm 24.05.1 did on the
    NSTCCore (TWGrid) cluster on 2026-10-10, each fact with its site-guide or SchedMD 24.05.1 page or the
    observation (partition tiers, memory requests that add billed CPUs, over-memory jobs that swap instead of
    failing, --export=NONE rebuilding the login environment, DerivedExitCode, sampled MaxRSS, Fair Tree priority),
    and how to configure the adapter there; linked from batch-scheduling.md; reference inventory regenerated.
    - batch-scheduling.md: the Slurm tool-facts rows confirmed by the fir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
2026-10-10 hep-computing: checking what a Slurm cluster can give you; NSTCCore B6000, access and QoS rows
    - batch-scheduling.md: a read-only procedure to show the user the cluster before choosing a partition (capacity per
    node set, pending reasons, GPUs usable only with free cores, access and QoS limits, the limits of --test-only,
    fair-share standing, one tiny confirming job), recording commands rather than numbers; sizing note on sampled
    MaxRSS for short pilots.
    - batch-site-nstccore-slurm.md: QoS row corrected (the job's own QoS stays normal; the partition QoS imposes its
    limits); RTX PRO 6000 Blackwell node checked with a CUDA kernel; partition access and QoS limits. Snapshot values
    (queue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
2026-10-11 physics-ml: first GPU runs; opt-in GPU tests; gloo DDP test hides GPUs
    - tests/skills/physics_ml/test_gpu_real.py (new, HEP_TORCH_GPU_TEST=1 and CUDA): CPU vs CUDA training with and without
    AMP within 5 % on validation loss, inference on a CUDA checkpoint, transformer forward/backward with fp16 autocast,
    NCCL DDP on two GPUs. Skips without the variable, CUDA or torch. Passed on RTX PRO 6000 Blackwell (1 GPU) and V100
    (2 GPUs) through Slurm on NSTCCore, torch 2.14.1.
    - test_assets_smoke.py: the gloo DDP test hides the GPUs from its child processes; with one visible GPU it failed
    (rank 1: "invalid device ordinal"), with two it silently ran NCCL.
    - deep-learning-guide.md: "GPU Builds, C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
2026-10-11 batch-schedulers: max_core_hours counts allocated CPUs (Slurm AllocCPUS)
    - Slurm poll reads AllocCPUS; each attempt records alloc_cpus (0 while pending -> None).
    - limits: core-hours use allocated CPUs when known, requested otherwise (HTCondor, older state);
    new submissions are projected at the largest allocated/requested factor seen in the campaign
    (alloc_cpu_factor in the usage). Fixes the 2x under-count on hyper-threaded GPU nodes from
    GPU-CAMPAIGN-RUN once a pilot has been polled; the first submission is still projected at
    requested CPUs, and GPU-hours are still not tracked (known limitation).
    - Tests: allocated CPUs in finished and unfinished attempts, the requested-CPU fallback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
2026-10-12 hep-statistics: SR/CR model card and core-pyhf backend equivalence (audit T15, T16)
    T15: contracts/schemas/statistical_model.json, nested as likelihood.model_card (no new artifact
    type): channels with roles, samples with poi/free/constrained modifiers, constraints with the
    auxiliary measurement each encodes, the toy ensemble. Rules (contracts.validate.check_model_card):
    an auxiliary measurement used twice, a prior in a frequentist model, an undefined channel or
    parameter, and a contamination claim without a CR signal are errors; not-modeled contamination
    is unresolved. adapters/pyhf-combine/assets/model_card.py builds the pyhf workspace (a shared
    luminosity is one parameter) and runs Asimov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
2026-10-12 sci-fix: Bayesian diagnostics match Vehtari et al./ArviZ; signed weights refused by effective-count BB (audit T20, T24)
    bayes_diagnostics.py: chains with ties crashed the quantile MCSE (a constant indicator gave NaN);
    constant chains reported R-hat = 1.0, which reads as healthy; they are now undefined with a flag
    and not-converged (ArviZ 0.23.4 reports ESS = draws there: deliberately stricter). ESS now uses
    Geyer's initial positive sequence with the improved last term and pair-averaged monotone sequence,
    and the quantile MCSE the Beta-rank interval, as in Vehtari et al. 2021 and Stan: on six cases
    (iid, AR(1), ties, Cauchy, stuck modes, shifted chain) R-hat, bulk/tail ESS and quantile MCSE
    e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
2026-10-12 hep-statistics: experimental P2 constructions with oracles (audit T26, T28, T29, T30)
    All four are labelled EXPERIMENTAL; each test states its oracle and its negative baseline.
    T26 eft_scan.py: quadratic signal models on a complete grid. nu = 10 - 6c + c^2 at n = 10 gives
    two allowed intervals equal to the closed-form roots within a grid step, never the hull; a toy
    Neyman belt differs from Wilks between the minima and does not undercover (discrete overcover);
    2D: joint components counted, 2-dof joint region vs 1-dof profiled intervals reported apart;
    grid-limited sets are flagged.
    T28 global_significance.py: toys repeat the whole procedure (1D or 2D scan, background
    normalization fixed/fre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
2026-10-12 hep-statistics: CI backend gate, validation workflow, wording fixes, evidence ledgers
    - tests.yml: required job stats-backends runs the statistics tests with pyhf 0.7.6 and ArviZ
    0.23.4; tools/run_required_backends.py fails on any skip for a required backend (checked
    locally: 119 run, 0 failures, with both installed; fails naming ArviZ without it).
    - statistics-validation.yml (weekly, on demand, release tags): full-budget campaigns, the
    published-likelihood reproduction (not-run fails) and a Combine 11.1.0 release gate. Written
    and YAML-checked; not yet run on GitHub.
    - Wording (audit): CLs as a modified frequentist exclusion prescription; profile-vs-marginalized
    difference is not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
2026-10-12 hep-statistics: fixes from an independent review of the audit branch
    - contracts: typed 2.2 fields (coverage, likelihood provenance, model card, fit_diagnostics,
    p-value bounds) moved to ext_statistical_result_v2_2.json, applied only to 2.2+ artifacts or
    with --strict: a 2.1 artifact with, e.g., coverage.n_toys "1000" or likelihood.backend as an
    object kept failing schema validation before (T08 regression; the base schema is the 2.1 text).
    - publication gate: recorded toy coverage below the nominal by more than 0.01 fails; toy coverage
    without its value or nominal level, and analytic/exact coverage without a justification, are
    unresolved; a toy-calibrated global p needs global_n_to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
2026-10-12 VALIDATION: STATS-AUDIT section; T27 outcome in the changelog and capability ledger
    T01-T30 results with their evidence, including what did not pass: Combine not run (T16),
    the toy-based T17 construction does not reproduce the paper's observed and -1 sigma limits,
    T27 coverage not established at 300 toys, CI workflows not yet run on GitHub. Aggregate:
    18 checks pass, 2,007 unit tests with 0 failures (55 skipped); relocation check passes.
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2026-10-12 contracts: typed legacy communication claims and the capability-gated traceability format
    Legacy claims now have typed text, result_ref and status (scalar or array; numeric text, null ref and object status are
    schema errors). A new capability communication:traceability-v1 selects ext_communication_traceability.json: claims with
    evidence edges (artifact or source target, locator, role, usage), document occurrences, read events, declared ledgers
    and support assessments. contracts/communication.py holds the pure rules: claim-scoped sticky-status propagation over
    used-in-claim edges whatever their role, observed only with an observed or source edge, no observed+synthetic on one
    claim, context-on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
2026-10-12 contracts: project-level resolution of communication records
    contracts/communication_project.py resolves a record inside an explicit project root: schema (capability-selected),
    inputs through contracts/dependencies.py (which gains an additive vocab parameter for bound-profile terms), declared
    and bound-profile evidence ledgers with hash checks, source ids (unknown id and unavailable ledger are distinct
    findings), document digests; nothing outside the root is opened and no network is used. resolve_outcome and
    normalize_dependency_report give the plan's exit precedence (input-error 2 > fail 1 > incomplete 3 > pass 0) without
    reading Report.ok as completeness; output_aliases_input refuses a rep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
2026-10-12 research-communication: scope manuscript checks to the selected main document
    check_manuscript.py gains --main MAIN.tex (literal include discovery against --build-root, bounded by --project-root,
    declared bibliography only, a built .bbl only with --bbl), reports what it cannot follow as incomplete coverage
    (exit 3), ignores verbatim bodies, prints a JSON report with --format json, and fails an empty directory with exit 2.
    Directory mode keeps its merge semantics and is labeled a repository-wide source scan.
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2026-10-12 research-communication: link results to claims and audit reporting completeness
    New skill-local communication_lib (report, documents, audit, claims, reporting) and two CLIs. check_communication.py
    validates a record, resolves inputs/ledgers/sources/documents, and with --checks manuscript compares every declared
    occurrence with the current document text at its locator (Markdown and literal LaTeX), reporting coverage counts and
    never claiming whole-manuscript coverage. audit_claims.py checks recorded assessments, source read coverage, advisory
    wording, display values against exact source values under declared rounding, and reporting completeness against
    assets/reporting-policies.json; it emits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
2026-10-12 research-communication: track revision impact and stale assessments
    communication_lib/revisions.py and track_revision_impact.py compare a baseline and a revised record through pinned
    identities, classify each change (analysis-rerun, source-change, reference-move, reassessment, content-edit,
    status-change, added, removed), propagate it to every recorded occurrence, reopen assessments and verified revision
    items that depend on it, keep the baseline immutable, never re-resolve an old reference against today's file, and
    bound coverage to the recorded occurrences with a request for a targeted read.
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2026-10-12 evals: live run of the research-communication cases on claude-sonnet-5-5
    run_live_eval.py (headless claude -p with the routing harness's isolation and parsing); run live-20261013-sonnet at
    0.6.14: 6 pass, 4 fail (routing), 1 critical-fail (hedged completion assertion), no fabrication; scorer calibrated to
    1.1 on the run's outputs (grounded fixture content, file:line references, years, negation, phrase alternatives) with
    regression tests; semantic judgments recorded as the executor's, not an independent review. README, VALIDATION and
    CHANGELOG updated.
2026-10-12 WP1: response validation by intended use, counts closure, contracts 2.4.0 response semantics, artifact adapter
    - validate_response: counts closure divides by generated_per_truth_bin (was M*truth, 100x off in the review case);
    without it the closure is not_assessable. metadata.intended_use (forward_folding / unfolding / parametric_fit):
    underdetermined, rank_deficient and empty.truth_bin stay errors for unfolding and when undeclared (plus a warning to
    declare the use), warnings otherwise. Closure is skipped only by shape, entry, normalization or orientation errors.
    conditional_on_selected with acceptance inside and negative closure truth are errors. Shared probability_matrix/fold.
    - c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
2026-10-12 WP4: correct detector-response reference physics and unify metric definitions
    Items 1-16 of the 2026-10-12 review: tracking resolution minimum vs crossover (R_min = sqrt(c m/(z a))), 1/(B L^2)
    scaling with the Gluckstern terms, weak-mode q/p bias, muon charge confusion from the non-Gaussian curvature tail and
    TeV radiative losses, charge confusion below the MDR, per-run/period MC instead of time-averaged conditions,
    truth-matching efficiency (finite statistics, matching definition, generated-particle numerator, non-closure
    diagnosis), energy-scale flux shift (gamma - 1) * delta, sublinear-superposition muon excess, balloon direct
    measurements, elongation rate as a slope, positrons vs antipro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
2026-10-12 WP5: detector-response SKILL.md gates insufficient inputs, asks for intended use, routes by task type
    SKILL.md (7266 B): intended use in the response declaration, a stop rule when the inputs cannot determine the answer
    (mean and width do not determine a migration matrix), the Jacobian only for continuous densities, folded `prediction`
    as a typical artifact, handoff rows for a hep-theory prediction to fold and for tag-and-probe pass/fail fits and pileup
    systematics to hep-statistics. The task-routing table (what to confirm first per task type) lives in the principles
    summary. Reference inventory regenerated (detector-response cited nowhere: 0).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
2026-10-12 detector-response: front-end electronics and signal processing
    Add references/front-end-electronics-and-signal-processing.md, which models readout
    electronics as part of the detector response: signal induction (Shockley-Ramo,
    ballistic deficit), shaping, noise (series, parallel, 1/f, leakage scaling, correlated
    noise, common mode), thresholds (S-curves, Rice noise-hit rate), optimal filtering and
    sampling, ADC/TDC quantization and nonlinearity, time pickoff (jitter, walk, CFD modes),
    pileup (Campbell, bipolar baseline transients), dead time and live fraction, SiPM and
    PMT readout, LAr TPC signal processing, radiation effects, and electronics calibration
    and simulation, with an explicit out-o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
2026-10-12 physics-ml: HEP content patch, weighted metrics and losses, profile wiring
    Applies the external physics-ml review patch (Chapter 8) against 0.6.16:
    ml-analysis.md rewritten as the physics entry point; new references on
    particle and jet architectures, fast-simulation validation, space and
    astroparticle ML, and SBI training; XGBoost negative-weight statement
    corrected; generative-models.md points to fast-sim validation.
    New assets hep_metrics.py (NumPy, signed-weight ROC/AUC, efficiency with
    MC uncertainty, rejection at fixed eps_S, Asimov Z with sigma_b, dCor,
    sculpting JSD) and hep_losses.py (signed-weight BCE, DisCo, NaN-safe
    masking) with 33 analytic tests. hep_losses tests and the Deep S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
2026-10-13 contracts 2.5.0: ml-artifact content semantics, write_ml_artifact.py
    - ext_ml_artifact.json (additive): splits.overlap_check {tool, result pass|fail|not-run, report}, splits.manifest,
    splits.test_groups_disjoint; weights as a string or {source, negative_weight_treatment, class_balancing, used_in};
    domain_shift; environment {torch_version, framework, device, precision, seeds}; output_semantics. grouping_key
    minLength 1 (an empty key was already ml.no_grouping).
    - contracts/validate.py _ml_semantics, native from 2.5.0 (ML_SEMANTICS_FROM), older artifacts with --strict:
    errors ml.no_grouping (blank key), ml.model_hash_missing, ml.labels_missing, ml.features_missing,
    ml.training_domain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
2026-10-13 physics-ml: grouped split builder, calibrated surrogate domain check, review fixes
    - make_grouped_splits.py (new): train/val/test or k-fold assignments from a
    grouping key (random-groups, temporal), null-group policy, manifest in the
    check_split_integrity.py format plus a strict-JSON summary.
    - check_split_integrity.py: null/empty groups are reported and count as
    missing metadata (no silent pass); IDs and groups are compared stripped and
    case-folded by default (--case-sensitive opts out); normalization conflicts
    reported.
    - check_surrogate_domain.py rewritten: whitening (constant features and
    near-zero-variance directions handled and reported), Mahalanobis + k-NN
    (cKDTree) with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
2026-10-13 examples: J9 worked example, classifier to signal-strength fit (SYNTHETIC)
    examples/ml-classifier-to-inference/run.py: seeded synthetic samples in runs
    nested in periods with ~10% negative background weights, grouped split by
    run (make_grouped_splits.py, check_split_integrity.py --strict) and a caught
    row-level leak, NumPy weighted logistic regression (default; --trainer torch
    runs assets/train_classifier.py), hep_metrics, calibration.py (prior
    correction + temperature, val -> test), weighted-KS domain-shift check with
    a noise floor and check_surrogate_domain.py flags on pseudo-data,
    write_ml_artifact.py, then a Barlow-Beeston-lite template fit of mu
    (core.stats.likelihood_limits shape model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
2026-10-13 sci-fix: lock the local partition state folder (CMP-01)
    run(), reset() and merge() take an exclusive non-blocking flock on <state>/.lock
    through engine.dir_lock, which campaign_lock now reuses (shared per-thread
    registry, so engine.merge inside a campaign call nests). A second holder gets
    partition.locked; the CLI prints it as JSON, exit 2.
2026-10-13 STH-T1.0: adversarial gate tests and committed-artifact verdict snapshot
    - tests/contracts/test_gate_adversarial.py: one case per STH-T1.1-T1.7 bullet (17 statistical-result mutations,
    5 Bayesian, comparison gate relabel/edge overwrite/unit factors, duplicate combination id, unequal envelope rows,
    scaled covariance PSD, contour domain, result_artifact refusals). Red on c1d375c: 36 failing (sub)tests,
    only the unmutated-bases control passes.
    - tests/contracts/test_gate_verdict_snapshot.py + gate_verdicts.json: default ok, strict ok and publication-gate
    status of the 90 committed artifacts (examples/, contracts/fixtures/artifacts/) on c1d375c; any change must be
    listed in ALLOWED_CHA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
2026-10-13 sci-fix: validate the partition manifest in every subcommand (CMP-03)
    status, merge and reset call validate_manifest before reading state; reset
    refuses a state of another manifest and unknown chunks before writing, so a bad
    manifest no longer leaves a rewritten state.json behind a traceback.
2026-10-13 sci-fix(hep-theory): event_weights validates inputs and reports selected-event statistics (THY-WP1.3)
    Refuses non-finite weights, sigma_pb not finite and > 0, a negative or
    non-finite luminosity, and selected indices that are non-integer, negative
    (-1 was accepted by wrap-around), out of range (IndexError traceback) or
    repeated (fraction 1.5). For a selection it reports selected_sum_w,
    selected_sum_w2, selected_effective_sample_size and
    selected_relative_stat_uncertainty; a selected sum <= 0 is refused (stated
    in the output field selected_non_positive_sum). Every refusal is JSON
    status failed, exit 1.
    before: test_event_weights 4 run, 16 failures, 1 error
    after: 4 run, OK (6-event hand valu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
2026-10-13 sci-fix(hep-theory): dis_kinematics refuses points outside the lepton-mass bounds, allows a target at rest (THY-WP1.4)
    With m_l > 0 (equal in and out) the exact bounds y_max = 1 - m_l/E and
    Q^2_min(y) at theta = 0 (E = k.P/M, nucleon rest frame) are derived in
    references/dis-kinematics.md (analytic-derivation), enforced (exit 1, Q9)
    and reported in every ok output. E_hadron == M (fixed target) is accepted;
    E_hadron < M is still refused. Massless leptons keep y_max = 1, Q^2_min = 0.
    The test compares the closed forms with an angle scan of -(k-k')^2 in
    60-digit decimal arithmetic (double precision loses ~10 digits for a 5.9 TeV
    rest-frame muon), and checks from_four_vectors against it at 1e-3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
2026-10-13 sci-fix: unreadable numpy caches are unscanned, not errors (CMP-05)
    Object .npy, pickled or non-zip .npz and corrupt zip .npz files are listed as
    unscanned (status incomplete, exit 3) instead of aborting the scan with exit 2
    or a BadZipFile traceback with exit 1.
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2026-10-13 sci-fix: blinding masks fail closed on lengths, types and flow bins (CMP-ANA-P2-7)
    Core part of hep-analysis audit item P2-7: mask_ratio refuses mismatched
    lengths instead of truncating with zip; mask_binned/mask_ratio/seal refuse
    non-numbers; mask_binned masks an errors array with the same mask; flow=True
    handles underflow and overflow bins. Also opens .npy/.npz with an own handle
    so a corrupt archive does not leak numpy's file (CMP-05 loader).
2026-10-13 STH-T1.3: comparison gate requires an edge map and a declared Jacobian; finite positive unit factors
    - contracts/comparison/gate.py variable-change: 'edges' must be the image of every current edge (same length,
    strictly monotonic) and is recorded as edge_map (with the variable before/after); from == to is refused (use
    rebin); a Jacobian must be a finite non-zero number or {expression|relation|value, ref}, a bare word ('yes',
    'identity') leaves the comparison unresolved. unit-conversion: factor finite and > 0, recorded as recorded_factor.
    Module docstring table updated.
    - tests/contracts/test_comparison.py: declared change comparable and recorded; missing/short/non-monotonic edges,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
2026-10-13 hep-analysis: P2-0 common CLI contract for the twelve scripts
    Every script takes --status (core artifact_statuses; tables also accept the
    table-only value published, Q8) and reports it; make_yield_table requires it like
    systematics_table_tex. Exit codes follow the repository convention: 0 ok, 1 finding
    or failed computation, 2 usage or invalid input (NaN, inf, malformed file), 3
    incomplete. Errors are one line on stderr, no traceback. check_systematic_variations
    now defaults to JSON and exits 3 when PyROOT is missing. Done after P0-2 so the
    flux tool follows it (status option and output added to its tool contract).
    The end-to-end example passes --status synthetic to make_yield_table.
    Co-Aut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
2026-10-13 STH-T1.6: contour probes outside the likelihood domain are q = +inf, not failed fits
    - core/stats/likelihood_limits.py: _TwoPoiModel.cond/q take probe=True for contour rays and Hessian steps; a
    conditional fit with no valid likelihood (some bin mean <= 0; retried from nominal nuisances first) returns +inf,
    is counted in fit_diagnostics.events.out_of_domain_probes and is not recorded as an observed-data fit failure.
    Real failures stay counted. _root_increasing_in_domain bisects an infinite upper end back into the domain before
    the Illinois steps (before, inf produced NaN steps); a ray that meets the domain edge first is listed in
    rays_not_closed with its reason. A non-finite Hessian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
2026-10-13 hep-analysis: P0-4 one spec format: the JSON measurement-spec
    Delete assets/analysis-contract.yaml (collider-only, carried a statistics block) and
    systematics-config.example.yaml. Add measurement_spec.template.json (validates with
    --strict) and its field guide measurement_spec.template.md with collider, cosmic-ray
    and neutrino normalization kinds. systematics.csv takes the spec's systematics
    ledger columns (name, source, effect, applied_via, ...); systematics_table_tex.py
    renders them and refuses an effect outside the vocabulary. Inference settings now
    point to hep-statistics. The no-authorization test moved to the JSON template.
    Reference inventory regenerated.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
2026-10-13 feat(contracts): contracts 2.6.0 and the theory examples regenerated under it (THY-WP2.5)
    CONTRACTS_VERSION = "2.6.0" (contracts/__init__.py with a 2.6.0 comment,
    vocab/core.json contracts_version, the two version-pin tests: the statistics
    and analysis branches make the identical edit, Q5); validate.py --strict
    paragraph lists the theory rule family. Fixtures stamped CONTRACTS_VERSION
    regenerated by make_fixtures.py.
    Examples: qed-prediction and theory-comparison truncation objects gain
    method "not-estimated" (new truncation_methods term: named but not
    quantified, the prediction is conditional on the order; none of last-term,
    envelope-proxy or series-model describes what these examples do),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
2026-10-13 docs(hep-theory): reference on amplitudes, phase space, widths and resonance treatment (THY-WP3.1)
    New references/amplitudes-and-widths.md: Feynman-rule sign conventions
    (Romao-Silva eta signs), averaging and symmetry factors, the PDG 2026
    Kinematics decay-rate, phase-space, two- and three-body and 2->n formulas
    with equation numbers, the narrow-width approximation and its five
    conditions and failure modes (Berdine-Kauer-Rainwater), Breit-Wigner forms
    and pole parameters (PDG 2026 Resonances), the complex-mass scheme (Denner et
    al. hep-ph/0505042), checks, limits and deliverables. Every formula line
    cites a source opened on 2026-10-13 with its location, or says unverified.
    Documentation onl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
2026-10-13 hep-analysis: P1-1 measurement-spec semantic rules (contracts 2.6.0)
    CONTRACTS_VERSION 2.6.0 with MEASUREMENT_SEMANTICS_FROM and _measurement_semantics in
    contracts/validate.py: the SKILL.md invariants (estimand, observable, denominators,
    backgrounds, correction chain, unknown-is-never-zero, systematics, unresolved inputs,
    blinding mask, ratio, period order, field typos). Native from 2.6.0; older artifacts
    keep their outcome unless --strict. Q3: distinct efficiency factors are allowed; a
    repeated category or a bare efficiency next to a factor is an error. Two deviations
    from the task table, so that unknowns are never silent: a missing marker not named
    in unresolved_inputs is an error (listed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
2026-10-13 STH-T1.8: contracts 2.6.0 bookkeeping: version, migrator, fixtures, docs
    - CONTRACTS_VERSION 2.6.0 (contracts/__init__.py with the 2.6.0 comment, vocab/core.json, version-pin tests);
    validate.py --help lists the 2.6.0 rule family and the synthetic/asimov gate refusal.
    - migrate_statistical_result.py: a 2.2-2.5 artifact is moved to 2.6.0 (version only) and refused when it breaks a
    2.6.0 error rule; it never repairs numbers or invents seeds; 2.6.0+ is unchanged.
    - Fixtures (make_fixtures.py, regenerated): valid statres_v26 and statres_v26_bayesian; 8 invalid (one per new
    error code) and 9 unresolved (one per new unresolved code); fixtures that embed CONTRACTS_VERSION moved to 2.6.0.
    Ve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
2026-10-13 docs(hep-theory): force-field modulation formula with its source and limits; hand the code to hep-analysis (THY-WP4.2)
    references/cosmic-ray-propagation.md gains a "Force-field solar modulation"
    section: Gleeson and Axford, ApJ 154 (1968) 1011, Eqs. (13), (15)-(16)
    (opened from the ADS scan 2026-10-13), the per-nucleon form with
    Phi_n = (|Z|/A) phi (Ghelfi et al. 1511.08650 Eq. 1), the low-energy breakdown
    (GA p. 1016), and the missing rigidity, drift and charge-sign dependence
    (Cholis, Hooper, Linden 1511.01507). It points to
    skills/hep-analysis/scripts/solar_modulation_force_field.py, which this order
    does not touch: the extension (tabulated LIS, rigidity input via
    core/kinematics, phi uni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
2026-10-13 STH-T2.4: ten reference corrections, each with a cited, ledgered source
    - likelihood-fitting.md: SumW2Error(True) only for known constant weights; sWeights/estimated weights need the
    asymptotically correct covariance (Langenbruch 2022; RooFit AsymptoticError).
    - inference-recipes.md: the prior-width effect on Bayes factors is Bartlett's (Bartlett 1957; Cousins 2017), two
    places; s/sqrt(b) is the s << b limit (Cowan et al. eq. 97).
    - nuisance-modeling.md: code4p sign convention d+ = up - nom, d- = nom - down; pyhf 0.7.6 zero-nominal convention
    (relerr 0, gamma fixed); pyhf staterror Gaussian vs HistFactory StatError Poisson (5% threshold) defaults.
    - core-stats-guide.md: EDM 1e-5 is str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
2026-10-13 STH-T2.5: cross-skill pointers to the hep-analysis inference scripts; two counting references disambiguated
    - core-stats-guide.md Skill scripts: cr_spectrum_powerlaw_fit.py (diagonal per-point errors only) and
    particle_ratio_with_uncertainty.py (delta method, one optional correlation) as shipped in 0.6.17, pointing to
    covariance_fit.py, ratio-cov/ratio-measured and exact low-count constructions for the correlated case;
    counting_reference.py (flat-prior Bayesian, known b, hep-analysis) vs poisson_diagnostics.py / likelihood_limits.py
    (frequentist). Wording defers to the scripts' --help since the hep-analysis plan (P2-4, P2-9) may extend them;
    no hep-analysis code touched. Reference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
2026-10-13 hep-analysis: P1-4 correct physics statements with primary sources
    - Solar cycle 24 (Q6, SILSO opened 2026-10-13: cyclesmm table and news004): minimum
    Dec 2008; first peak northern hemisphere (hemispheric maximum Nov 2011); plateau
    early 2012 to mid 2013; higher second peak (southern hemisphere) with the 13-month
    smoothed maximum Apr 2014; solar maximum about 2011-2014. Guide and
    space-based-direct-detection.md now agree; the research-communication row already
    matched and is unchanged.
    - Cutoff selection: f x maximum cutoff over the acceptance cone, f from a profile, the
    same rule for the exposure (formula added); no 'typically 1.2'.
    - sigma(Xmax): about 60 g/cm2 (p) and 20 g/cm2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
2026-10-13 hep-analysis: P2-1 tilted-dipole mode for the orbit-averaged cutoff
    orbit_averaged_geomagnetic_cutoff.py: new tilted centred-dipole mode (--pole-lat,
    --pole-lon from the user's IGRF epoch, no default embedded) that follows the ground
    track of a circular orbit with Earth rotation for --days, and reports the geomagnetic
    latitude range, min/max/mean cutoff, time fraction below --thresholds and an
    exposure-versus-cutoff table. The untilted mode stays, labelled 'planning
    estimate'. Docstring fixed: equal-u samples are time-weighted, no Jacobian or
    trapezoid rule. Own run for 51.6 deg, 1.065 Re, pole (80.7 N, 72.7 W), 30 days:
    geomagnetic latitude +-60.9 deg, minimum 0.735 GV (vertical Stormer at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
2026-10-13 hep-analysis: P2-4 continuous broken power law with a free break
    cr_spectrum_powerlaw_fit.py: --model single|broken|smooth-broken. The broken models
    are continuous by construction (sharp, or smooth with --smoothness s), linear in
    (log A, g1, g2) at a fixed break, so the break is fixed (--break-energy) or free
    (--free-break: grid profile plus golden-section refinement) and each break is a
    generalized least-squares solve in log flux (core/stats _linalg.solve). Output:
    chi2, chi2/ndf and p-value (core chi2_sf) for weighted fits; full flux covariance
    (--covariance); asymmetric errors; bin edges with log-centre or iterated
    Lafferty-Wyatt energies; normalization at --pivot with its uncertainty fro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
2026-10-13 hep-analysis: P2-5 statistical test in check_systematic_variations
    With per-bin uncertainties (JSON nominal/up/down_sumw2, ROOT bin errors, or
    --stat-unc) a variation is classified by a normalization pull and a chi2 test of the
    unit-normalized shapes at --alpha (default 0.01); the old relative tolerance is kept
    only as the fallback without uncertainties (reported as tolerance_effect, and the
    output says no test was made). A +-1e-5 wiggle with 1% errors is now 'none' (was
    'mixed'); a 5% shape tilt is 'shape'. --include-flow is honoured for JSON
    (underflow/overflow objects). The output states that the direction of a variation
    cannot be inferred from integrals. NaN and malformed JSON exit 2 (P2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
2026-10-13 STH-T3.1: CLI input fuzz for the statistics tools; refusals instead of tracebacks
    - New tests/skills/hep_statistics/test_cli_input_fuzz.py (separate from test_cli_robustness.py): every subcommand
    of core/stats and skills/hep-statistics/scripts gets a JSON list, an empty object and NaN inside its --input, and
    CL 1.5/0/NaN, negative counts, b = NaN, zero bins, zero denominators, negative toys on its options; each must exit
    2 (validators 1 or 2) with JSON on stdout and no traceback. --help must work with NumPy and SciPy hidden for every
    script. Plus the four crashes the audit confirmed.
    - Fixes: unfolding_diagnostics._read and covariance_fit refuse a non-object JSON; pcl_efficiency_rati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
2026-10-13 hep-analysis: P2-10 table escaping, totals and labels
    make_yield_table.py escapes pipes and line breaks in region and sample names, keeps
    the status line (P2-0) and NaN refusal, and gains --totals (sum with uncertainties
    in quadrature, the independence assumption printed under the table).
    systematics_table_tex.py puts every cell and the caption on one line and reduces
    --label to a safe key ([A-Za-z0-9:._-], others become '-'), so
    'tab:x}\input{/etc/passwd' can no longer inject LaTeX.
2026-10-13 hep-analysis: P3-1 correction-chain reference
    New references/correction-chain.md: generic estimands per domain (flux, fiducial cross
    section, neutrino beam, target exposure) with their normalization kinds; the
    factorized efficiency with conditional denominators and the validator category
    names (Q3); factorization bias and how to test it; the data/simulation efficiency
    ratio and its systematics; a synthetic worked example checked by
    tests/skills/hep_analysis/test_method_references.py (including a
    cosmic_ray_flux.py run). Routed from the guide and the field guide; inventory
    regenerated.
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2026-10-13 hep-analysis: P3-4 time-dependent measurements
    correction-chain.md gains 'Time-dependent measurements': per-period exposure and live
    time (runs, days, Bartels rotations), exposure-weighted period averages, efficiency
    drift monitored with a stable control species or sample, period-correlated versus
    period-specific systematics as evidence for hep-statistics; synthetic worked example
    (the plain mean of period fluxes is 15% high) checked in test_method_references.
    Routed from the guide.
2026-10-13 hep-analysis: P3-5 steeply falling spectra and spillover
    measurements-and-unfolding.md gains 'Steeply falling spectra and spillover': the
    power-law smearing factor exp((gamma-1)^2 s^2 / 2), the forward-fold versus unfold
    decision (computation handed to hep-statistics: astroparticle statistics and
    unfolding references; the response to detector-response), bin widths of one to two
    resolution sigma with purity and stability above one half, resolution-tail
    systematics; synthetic worked example checked by numerical smearing in
    test_method_references. Routed from the guide.
2026-10-13 hep-analysis: P3-6 antiparticle backgrounds
    backgrounds.md gains 'Antiparticles and charge-sign confusion': confusion as a 2x2
    migration matrix measured per bin from tracker tails and inverted, species-specific
    effects that do not cancel in ratios (recorded as independent cancellations), and
    misidentified-proton templates from an inverted-identification data sample; synthetic
    worked example (a 10% ratio bias removed by the inversion) checked in
    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
2026-10-13 hep-analysis: P3-7 nuclei and isotopes
    correction-chain.md gains 'Nuclei and isotopes': survival probability exp(-x/lambda)
    and the top-of-instrument correction, fragmentation feed-down from heavier species,
    charge-ladder leakage with joint templates, isotope separation limited by the mass
    resolution; synthetic worked example with invented interaction lengths, checked in
    test_method_references. Experiment-specific values stay in the profile. Routed from
    the guide.
2026-10-13 hep-analysis: P3-8 trigger efficiency from data
    analysis-design.md gains 'Trigger efficiency from data': orthogonal reference triggers,
    bootstrap chains, prescaled unbiased samples (prescale cancels in the ratio, not in
    rates; the unbiased sample's own selection on both sides), trigger-bias checks with
    exact binomial intervals; synthetic worked example checked with core
    clopper_pearson. The generic trigger text in the AMS efficiency module is replaced
    by a link; its AMS-specific remark stays. Routed from the guide.
2026-10-13 STH-T3.11: shape-limit at n = 0, b = 0; toy CLs runtime estimate and budget
    - likelihood_limits.py _ShapeModel._glob_from: a global search that stalls against the domain edge at mu ~ 0 (mu < 0
    gives a negative mean when b = 0) is judged on the mu = 0 boundary by KKT instead of being recorded as a failed
    fit. One bin n = 0, b = 0, s = 1: status ok (was failed: line_search_stalled, invalid_domain_nearby, also in 8667
    of 16000 toys); toy CLs limit within its MC range of -ln(0.05) = 2.996 (1000-2000 toys give 3.1-3.15, range
    [2.94, 3.39]; the order's +-0.01 needs far more toys).
    - shape-limit --cls-toys times three profile evaluations, records toy_cls_runtime_estimate_s and refuses (exit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
2026-10-13 hep-analysis: P3-10 neutrino and fixed-target specifics
    correction-chain.md gains 'Neutrino and fixed-target specifics': POT on the same
    spills as the events, near/far extrapolation with the correlated and uncorrelated
    parts recorded for hep-statistics, the flux x cross-section correlation, target
    absorption via L_eff = lambda (1 - exp(-L/lambda)), empty-target subtraction scaled
    by POT; synthetic worked example checked in test_method_references. Routed from the
    guide.
2026-10-13 hep-analysis: P3-11 look-elsewhere at the design stage
    analysis-design.md gains 'Look-elsewhere at the design stage': scan grid and every
    scanned dimension fixed in the plan before unblinding, the global p-value method
    decided in advance and computed by hep-statistics (linked, not restated); synthetic
    worked example checked in test_method_references. Routed from the guide.
2026-10-13 hep-analysis: P3-12 worked end-to-end review in the shipped examples
    New scripts/review_measurement_spec.py drafts the verdict-first review of a
    measurement-spec from the validator findings (strict): ranked defects with blocking
    codes first, unresolved inputs, the three-value verdict, --markdown in the template's
    order; exit 0 acceptable-with-open-inputs, 1 blocked or needs-work, 2 bad input. It
    reproduces the worked review's ranking. examples/collider-angular and
    examples/ams-flux-ratio now run it on their spec (estimand -> ledgers -> spec ->
    validation -> review) and write review.md; results.json gains the review and a
    review_verdict criterion (outputs regenerated with the E2 venv; only th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
2026-10-13 STH-T3.2: unbinned_fit numerics: natural-scale Hessian steps, exponential relative to lo, boundary policy
    - adapters/unbinned-fit/assets/unbinned_fit.py: Hessian steps 1e-3 x the parameter's natural scale (sqrt N, sigma,
    1/width) instead of max(1e-4 |v|, 1e-5 width) (which swamped the slope on wide ranges); the exponential is
    exp(slope (x - lo)) normalized with expm1 and generated with log1p (no overflow far from 0); one bracket policy
    for the profile root (step err, doubling after three steps, at most 12), a non-monotonic profile is a counted
    failure (FitError) instead of a ValueError; unknown profile_parameter exits 2 (rejected); n_sig on its lower
    bound is a boundary estimate wh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
2026-10-13 hep-analysis: P4-5 routing cases for the hep-analysis boundaries
    Fourteen cases (one en and one zh-Hant per boundary) in tests/routing/make_cases.py,
    cases.json regenerated: efficiency in the correction chain vs measuring it
    (detector-response); blinding policy design vs advisory blinding checks of outputs
    (hep-computing); background closure vs template-fit goodness of fit
    (hep-statistics); systematics evaluation plan vs covariance assembly
    (hep-statistics); cutflow design vs RDataFrame cutflow code (hep-computing); result
    level vs unfolding with regularization (hep-statistics); a review of a supplied
    analysis note (hep-analysis). Static check: 179 cases, 0 failed. Live routing
    evidence pend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
2026-10-13 STH-T3.5: pcl_efficiency_ratio: exact classical limit and fast power threshold
    - classical_upper is the exact Gamma(n + 1) quantile at cl minus b (no brentq bracket [b, 1e4], which failed for
    large n or b); the power-threshold count comes from the Poisson quantile (no loop from 0).
    - n, b = 1e4 and 1e5: limits with P(N <= n | s + b) = 0.05 to 1e-6, each under 1 s; small-count values unchanged
    (n = 0: -ln 0.05 - b). Tests in test_pcl_efficiency_ratio.py.
2026-10-13 STH-T3.7: look_elsewhere toy chunks sized from a memory budget
    - skills/hep-statistics/scripts/look_elsewhere.py: q0_scan processes toys in chunks of chunk_size(K, B, budget)
    (6 float64 [chunk, K, B] working arrays within MEMORY_BUDGET_MB = 256 by default; --memory-mb overrides) instead
    of a fixed 2000 (about 640 MB per working array at 200 points x 200 bins).
    - 200 points x 200 bins x 2500 toys: tracemalloc peak under 500 MB; results identical for a 16 MB budget.
    Test in test_look_elsewhere.py.
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2026-10-13 STH-T3.13: covariance_fit: broken power laws, plug-in models, toy-calibrated break position
    - skills/hep-statistics/scripts/covariance_fit.py: models broken-power-law (sharp) and smoothly-broken-power-law
    (model_options.smoothness), theta = [ln A, gamma1, gamma2, ln x_b], ln F = ln A - gamma1 (u - h) - gamma2 h,
    u = ln(x / x_b), h = max(u, 0) or s ln((1 + e^(u/s)) / 2) (one parametrization, proposed to hep-analysis for
    cr_spectrum_powerlaw_fit.py, Q8); a documented plug-in model {path, function(theta, x), n_params}.
    - New subcommand break-scan: profile chi2 over a grid of ln x_b (Gauss-Newton in the other three parameters, which
    ln F is linear in), an interval for the break calibrate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
2026-10-13 STH-T4.7: statistics evidence ledger and reference inventory brought up to date
    - docs/evidence/statistics/capabilities.json: eight capabilities added (gate hardening 2.6.0, covariance scale
    invariance, broken-power-law fits, ratio-cov-analytic, dagostini-unfold, shape-limit at ordinary sizes,
    shape-significance, CLI input fuzz), each with status, gate and tests; sources S15-S41 and claims C12-C17 were
    added with T2.4 and T4.1-T4.5.
    - docs/reference-inventory regenerated (182 references); run_all_checks --part checks passes.
    - Committed before STH-T4.6 so the routing rule change stays the last commit (reorderable at integration).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
2026-10-13 test: restore the pyhf skip on SrCrModelCard
    STH-T3.12 inserted FidelitySTH312 between the existing skipUnless(pyhf) decorator
    and SrCrModelCard, so SrCrModelCard ran without pyhf and errored (3 errors in
    every CI job without pyhf). Verified with pyhf hidden: 6 skipped, OK; with pyhf: OK.
2026-10-13 test: relative tolerance for the broken-power-law covariance comparison
    The linearized covariance has a central finite-difference column in log E_b
    (h = 1e-6), so the per-point-error and covariance paths agree to about eps/h
    relative: 1.0e-8 on Python 3.12/3.13, 9.0e-8 on 3.11 (float sum() changed in
    3.12). places=9 failed on CI Python 3.11; delta = 1e-6 relative passes on all three.
2026-10-13 hep-analysis: same-event systematic variations are not tested as independent
    check_systematic_variations.py combined per-sample variances (ROOT bin errors,
    JSON *_sumw2) as nominal + varied, which assumes the variation is independent
    of the nominal. A JES or resolution variation is made from the same events, so
    that overstates the variance of the difference: the PyROOT fixture (nominal
    events scaled by 1.03/0.97) came out 'none' with 'neither variation changes
    this histogram'. Found by the optional ROOT CI job on PR #64.
    Now the test uses up_diff_sumw2/down_diff_sumw2 (new), --stat-unc, or the
    per-sample variances only with --independent (new); otherwise no test is made,
    the report says why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
2026-10-13 ci: keep the check-run record of the optional jobs
    The optional jobs printed only counts, so a failure there could not be named
    (PR #64: one ROOT-container failure not reproducible on macOS). They now write
    --out ../../check-runs and upload it like the required checks jobs.
2026-10-13 synthetic-collider: optional background sample with a visible-energy fraction (P4-2)
    generate_events.py gains generate_background() (an invented tau-pair-like process
    through the same detector, x_vis ~ Beta(2, 2) independent of cos theta),
    signal_xvis() (x_vis = 1 + N(0, 0.01) from its own stream) and xvis_fraction()
    (analytic fractions for a sideband transfer factor), plus --background on the CLI.
    The benchmark gains a 'background' block. generate() and its outputs are unchanged;
    three new tests check additivity, the analytic fractions and the signal region.
2026-10-13 core/stats: one broken-power-law parametrization for hep-analysis and hep-statistics (STH Q8)
    New helper core/stats/broken_power_law.py: [ln A, gamma1, gamma2, ln x_b],
    ln F = ln A - gamma1 (u - h) - gamma2 h, u = ln(x/x_b), h = max(u, 0) (sharp)
    or s ln((1 + e^(u/s))/2) (smooth), so A = F(x_b) in both forms.
    cr_spectrum_powerlaw_fit.py and covariance_fit.py both evaluate it. The
    hep-analysis smooth form lacked the 1/2, so its normalization_at_break was
    F(x_b) 2^((g2-g1) s); it is now the flux at the break.
    tests/core/test_stats_broken_power_law.py: identical model values, both
    tools recover the truth on Asimov points, fitted parameters agree within
    0.3 sigma on seeded toys with a full cova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
2026-10-13 routing: give j05-turn-fit the inputs of j05
    Its second turn fits 'the folded prediction', which exists only if the first
    turn has a prediction and a response to fold. Without inputs the live run
    (20261013T084927Z, 51/52) measured a missing-input dialogue instead: turn 1
    asked for files, turn 2 named hep-statistics but deferred loading it. The
    sibling j05 already carries prediction.csv, response.json and observed.csv;
    the case now shares them (tests/routing/inputs.py). Routing tests and the
    static check pass.
2026-10-13 evals: live routing run for hep-analysis P4-6 and the new cases
    52 cases (28 owned by hep-analysis, 32 added since 0.6.17), claude-sonnet-5-5,
    setting-sources isolation: 51/52 strict and lenient, $3.75. The one failure,
    j05-turn-fit turn 2, came from a case without inputs (fixed in the previous
    commit). Scored summary only; raw transcripts stay untracked.
2026-10-13 collider-angular: sideband background with closure and a blinded signal-region bin (P4-2)
    Path B now simulates the synthetic-collider background sample next to the
    unchanged signal sample and histograms both in three x_vis bands. The background
    in the signal region (x_vis >= 0.9) is TF x control-sideband counts (0.5-0.8),
    TF from the simulated x_vis shape with a 10% fully correlated uncertainty, and is
    subtracted before the unfolding. Closure: Asimov (exact) and the validation band
    0.8-0.9 predicted from the sideband (observed 1171, predicted 1173.0, pull -0.05,
    chi2 13.7/12). Toys run the same blinded procedure.
    Blinding (synthetic policy): the forward signal-region bin cos theta >= 0.9, o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
2026-10-13 evals: j05-turn-fit recheck with inputs, 3/3
    Three single-case runs (claude-sonnet-5-5) after giving j05-turn-fit the inputs
    of j05: each turn loads its owner (detector-response, then hep-statistics);
    $0.60 in total. The earlier failure came from the missing inputs, so no
    hand-off wording change is needed.
2026-10-13 ams-flux-ratio: charge-sideband background with closure and a blinded helium bin (P4-2)
    Path A now simulates a synthetic Z=1 charge tail (5% of selected Z=1 events above
    Q = 1.3, exponential slope 0.2) leaking into the helium window 1.7 <= Q < 2.5. Per
    reco rigidity bin and period it is TF x the helium-free sideband 1.3-1.6 (TF =
    0.1710 from the synthetic tail shape, 10% fully correlated), subtracted before the
    helium unfolding; the ratio covariance carries the new block. Closure: Asimov
    (exact) and the validation band 1.6-1.7 per period (pulls -2.68 and 1.25, chi2
    10.5/8 and 8.2/9). The tail is drawn after the signal, so the signal counts of the
    seed are unchanged; toys vary the transfer fa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
2026-10-13 feat(contracts): R4 correction key for bounded recipes (F04/T04)
    recipe.json 1.1.0 accepts optional effect_keys (target_scope, calibration_digest,
    variation_id, stage) on the input and on steps; recipe_semantics.py also reads
    them from upstream extension.corrections[] entries. Same scope and variation
    again is a repeated correction whatever the calibration or stage; another scope
    or variation passes with a review warning; a repeat with a missing or
    incomplete key is undetermined. Unkeyed recipes keep the effect-name rule. The
    approved differential-flux table is unchanged.
2026-10-13 fix(contracts): correction-key review findings
    A keyed upstream record subsumes an unkeyed record of the same effect (the
    cumulative-record rule of the parent); an input-claimed effect is matched to
    one upstream record and further upstream records are checked against it;
    upstream keys that do not match the recipe.json patterns count as incomplete.
    Tests for each case, plus a 1.0.0 recipe with keyed upstream records.
2026-10-13 feat(contracts): hash-chained revocation log, head, reverse index (P2)
    P2.1 contracts/revocation.py with revocation_event.json and
    revocation_head.json: genesis plus events chained by canonical SHA-256,
    and a custodian-written head (count, last digest, as_of, source). verify()
    refuses an empty, cut, edited, reordered or truncated log, a head for
    another log, from another source, stale or dated in the future; a refused
    log answers no lookup (RevocationUnverified), never "nothing revoked".
    contracts/trusted_input.py implements the DP-4 source check used in
    protected mode: regular file, one link, not owned, not writable and not
    replaceable by the running account along its whole path.
    P2.2 buil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
2026-10-13 fix(protected): review findings on release A (P1/P2/P3)
    - trusted_input: a directory the account owns is replaceable even when
    read-only; the running account's write access to each directory is
    also checked.
    - guard: links into a protected project are followed when the mode is
    decided; a config that cannot be read, or a malformed one naming
    agent_policy, fails closed (protected.config_unreadable); inputs are
    revoked by byte digest, canonical digest or project path, digests are
    compared in lower case, unreadable inputs are refused; qualifications
    are revoked by id or digest; malformed protected inputs are refusals.
    - revocation_log.verify and build_index never raise on malformed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
2026-10-14 chore(contracts): bump to 2.7.0
    The release adds the capability IDs core:revocation-log,
    core:exposure-record and core:decision-lineage and the warning
    exposure.capability_not_declared: contracts 2.7.0 (user decision,
    2026-10-14). CONTRACTS_VERSION and vocab/core.json; the current fixtures
    and the measurement-spec template restamped; make_fixtures.py rerun
    (version lines only); examples rerun with the E2 venv (version stamps and
    one recorded digest only; unfolding-coverage kept at 2.6.0, its rerun
    drifts at 1e-14). Version pins in the two statistical-result tests and
    the migrator expectation follow; docs state the current version.
2026-10-14 chore: release 0.8.0
    Release A of the agentic-completion plan: release-manifest custodian
    options and the architecture and deployment documents (PR #70), the
    hash-chained revocation log and reverse index (PR #71), exposure and
    decision lineage (PR #72), protected-use mode at the formal-use entry
    points and contracts 2.7.0 (PR #73). Project config schema 1.2.0.
    Examples regenerated with the E2 venv (version strings; ML artifact
    hash); sbottom benchmark artifacts rewritten by hand; README size
    statement 15.1 MB. Release manifest 0.8.0 (1391 files, digest
    fa27784a...a473). ams02-research 1.4.10 checker: compatible.
2026-10-14 feat(contracts): analysis bundles, formal-use permits, recipe-use review (P5.2, P5.1, P5.3)
    P5.2 contracts/analysis_bundle.py and analysis_bundle.json: freeze the
    measurement spec, recipes, semantics tables, calibrations, tool
    contracts, environment lock, reviews and the plugin release into one
    digest (canonical JSON for .json items, bytes otherwise); verify reports
    each change. Attestations accept an analysis bundle as their subject.
    P5.1 contracts/permit.py and permit.json: a custodian-issued permit,
    read only as a protected input, binding the analysis bundle and the
    digests of the inputs a use may read, one purpose, an actor, a budget
    counted in the custodian's nonce ledger (protected_in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
2026-10-14 feat(contracts): --strict-versions for the version policy alone
    validate.py and dependencies.py gain --strict-versions (library:
    strict_versions=): a newer minor contract version is an error for the
    artifact and every source, as --protected meant before 0.8.0. It does not
    switch protected mode on, so it needs no protected inputs; --protected
    keeps its 0.8.0 meaning. Help texts, maintenance and architecture docs,
    changelog; tests/contracts/test_strict_versions.py.
2026-10-14 feat(partition): batch commands refused in protected mode (HC-10, HC-16)
    In a protected project (agent_policy, DP-2) core/partition/campaign.py refuses a real submit, resubmit or cancel and
    confirm, abandon, reset and clear-orphans in any form with protected.batch_needs_trusted_submitter, before any
    scheduler call. Before, a protected project with valid inputs could submit in-process as in S0. abandon, reset,
    cancel and clear-orphans now also run the protected-input guard. Dry runs, plan, freeze, status, watch, reconcile,
    merge and report are unchanged; outside protected mode nothing changes. The switch is protected mode, never the
    campaign config; agentic-architecture §10.2 records that fo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
2026-10-14 PML-X0 chore(contracts): bump to 2.8.0
    Contracts 2.8.0 is the shared minor for the physics-ml (ML semantics v2),
    detector-response (response hardening) and research-communication (result
    types) rule families of the three-audits plan; 2.7.0 was taken by the
    agentic-architecture capabilities. CONTRACTS_VERSION, vocab/core.json and
    the __init__ comment; the current fixtures and the measurement-spec
    template restamped; make_fixtures.py rerun; examples rerun with the E2
    venv (version stamps and one recorded digest only; unfolding-coverage
    kept at 2.6.0). The two version pins follow; test_strict_versions now
    derives the newer minor from CONTRACTS_VERSION instead of hardcoding
    2.8.0. docs/agentic-a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
2026-10-14 sci-fix: DR-WP1-01 Cherenkov photon yield carries z^2
    cherenkov_angle.py: photon_yield and describe_species take the charge number and
    multiply the Frank-Tamm yield by z^2; species accept names (He3/He4 z=2), masses or
    mass:charge via pid_separation_power.resolve_species; --momentum/--rigidity (p = zR);
    each record reports charge, momentum and threshold rigidity; equal-mass species of
    different charge are allowed. He4 at 40 GeV/c, n = 1.05: 17.02 -> 68.08 photons,
    sigma_theta 1.212 -> 0.606 mrad.
    References: 370 z^2 sin^2 theta_C (and 490 z^2, N_pe = N0 L z^2 sin^2) in
    core-detector-equations, principles summary, signal formation, Cherenkov imaging.
    Source: PDG RPP 2024, Passage of particle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
2026-10-14 sci-fix: DR-WP1-02 Gaisser-Hillas profile is stable and terminates
    gaisser_hillas evaluates N_max exp(e (log1p(u) - u)) with u = (X - X_max)/(X_max - X0):
    the same function, but the exponent is never positive and the cancellation between
    e ln(base) and (X_max - X)/lambda (3.5e53 N_max at X_max = 1e20) is gone.
    half_max_depths brackets the falling edge with a doubling step from the profile width,
    stops when the step no longer moves the bound, ends both bisections at float
    resolution, and drops the fixed x_max + 1e6 cap. A profile narrower than the search
    resolution and an overflow are reported in JSON as lambda too small relative to
    (x_max - x0).
    X_max = 1e20: timeout -> FWHM 1.824036e11 in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
2026-10-14 detector-response: DR-WP2-04 response adapter reads matrix_ref objects safely (part 1)
    contracts/response_adapter.py: a matrix_ref may name 'file.json#key'; an object's
    'underflow', 'overflow' and 'generated_per_truth_bin' are used when neither the
    caller nor the extension gives them; an object without 'matrix' is named instead of
    a misleading shape error; a ref outside the artifact folder is refused; an unreadable
    or malformed ref is a JSON error with exit 2 (was a traceback, exit 1); 'exposure' in
    applied_separately counts as acceptance applied separately. The 2.8.0 rule (a missing
    underflow_overflow is an error) follows with the contracts bump.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
2026-10-14 sci-fix: DR-WP1-05 trigger, tag-and-probe and pileup references agree with their scripts
    triggers-luminosity-pileup.md:
    - pileup is reweighted on the Poisson mean mu per bunch crossing, which is what the
    luminosity measurement gives in data, not on the per-event interaction count (a Poisson
    draw around mu, wider); as in the pileup_reweight.py docstring;
    - the mean after reweighting equals the data mean by construction; the closure is on a
    variable that was not reweighted (reconstructed vertices in a control region);
    - background-subtracted pass/fail yields are not binomial counts: a simultaneous pass/fail
    mass fit, handed to hep-statistics; Clopper-Pearson only for unweighted, backgr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
2026-10-14 sci-fix: DR-WP1-06 space-based instruments are not all spectrometers; cutoff is east-west asymmetric
    space-based-direct-detection.md: magnetic spectrometers measure rigidity, charge sign and
    (with velocity) isotopes, bounded by the MDR with charge confusion near it; calorimetric
    instruments measure deposited energy and charge magnitude, need an energy response and
    unfolding, and have no MDR, no charge sign and no isotope separation. The Störmer
    cutoff is east-west asymmetric: for positive particles lower from the west (10.2 GV
    horizontal at the equator, vs 14.9 GV vertical) and higher from the east (59.6 GV);
    low-rigidity bins are filled from the low-cutoff parts of the orbit. The azimuth
    c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
2026-10-14 sci-fix: PML-WP0.1 a calibration evaluated on its fit sample never validates
    ML-C01, ML-K03, ML-C13. assets/calibration.py records both sha256 values in
    sample_check and puts sample_check inside the "calibration" block the
    ml-artifact copies; --id-col is required unless --no-id-check (recorded),
    because a hash misses a copy with one byte changed. write_ml_artifact.py
    keeps sample_check (an older output's top-level block is copied in).
    contracts/validate.py gains ML_SEMANTICS_V2_FROM = "2.8.0" and
    _ml_semantics_v2: disjoint false, equal hashes, or fit and evaluation
    names equal after normalization (whitespace, "./", case) are
    ml.calibration_on_fit_sample (native from 2.8.0, older artifacts un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
2026-10-14 detector-response: DR-WP2-05 scripts echo a status label and print JSON errors
    All eight detector-response scripts:
    - STATUSES (the eight core artifact_statuses, one tuple per script; a test compares each
    with contracts/vocab/core.json) and --status, echoed as the top-level 'status'
    (default unvalidated). calorimeter_resolution --fit, multiple_scattering and
    pileup_reweight default to the input file's 'status'; the three assets now say
    "synthetic".
    - JsonArgumentParser: an argparse error prints {status: failed, ok: false, error_kind:
    invalid-input, error} on stdout and exits 2 (usage on stderr); subparsers inherit it.
    _fail adds status failed and error_kind. Exit codes in each do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
2026-10-14 physics-ml: PML-WP0.4 the ml-artifact writer does not trust self-reported results
    ML-C06, ML-K11, ML-C07. write_ml_artifact.py recomputes the split verdict
    from the report body (overlaps, duplicates, group leakage, temporal
    violations, group and timestamp coverage) and refuses (exit 2) a "passed"
    status the body contradicts; the recorded result is the worse of the two.
    The test split is the manifest's roles.test (default "test"), compared
    case-insensitively, so "TEST" or "holdout" no longer escape
    test_groups_disjoint. A run summary's split_check is read through the
    report file it names; with no report behind it the overlap check is
    recorded as not-run, never pass. Status labels are the run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
2026-10-14 sci-fix: PML-WP0.6 the domain-shift record says what was done about the shift
    ML-K05. ext_ml_artifact.json gains domain_shift.outcome (no-shift,
    corrected, bounded-by-nuisance, uncorrected) and domain_shift.nuisance;
    status stays "whether the check ran". From contracts 2.8.0 (older
    artifacts under --strict): a missing status, a checked record without an
    outcome, outcome bounded-by-nuisance or uncorrected without a nuisance,
    and a control sample that is the training sample are unresolved.
    J9 (decision Q3): the measured pt_miss scale enters the template fit as the
    Gaussian-constrained background-shape nuisance theta_pt_miss_scale
    (template at the control-sample scale as +1 sigma, mirrored for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
2026-10-14 fix: RC-A4 parse citations and .bib entries as TeX and BibTeX read them
    check_manuscript missed \Citet/\Cite/\Citeauthor, read only the first group
    of \cites/\textcites, could not see a key after a nested optional argument or
    after % inside \url, registered entries written inside a .bib field or
    @comment (so a \cite of a fake key passed), scanned \iffalse, the comment
    environment and \verb, and reported a crossref parent as unused under
    --strict. One test per case.
2026-10-14 fix: RC-A10 Traditional Chinese parity for status wording and notation
    Status-promotion, discovery, universal, negation and attribution scans gain
    zh-Hant patterns (測量到, 觀測到, 發現, 證實, 普遍, 並未, 根據, ...) and split
    sentences at 。！？；; corner-bracket quotes are skipped. check_terminology reads
    'R 表示 …' / 定義為 / 記為 / 代表 as a symbol definition and a CJK expansion
    before a full-width parenthesis (信賴水準（CL）) as an abbreviation definition.
    Each Chinese case gives the same finding as its English twin.
2026-10-14 fix: RC-A13 status labels matched as words in adaptation drafts
    check_adaptation counted 'synthetic' inside 'non-synthetic' as the label and
    treated every sentence containing 未 as negated. Labels are now whole words,
    not after not/non, and a CJK label negated by 非/不/無 does not count;
    NEGATED_RE matches 尚未/還沒/並未/未曾/未完成 instead of any 未.
2026-10-14 fix: RC-A17 terminology: declared terms mask their parts; same-line early use
    A disallowed CJK term inside a term the glossary itself declares (效率 in
    重建效率) is no longer flagged as a concept substitution, and an abbreviation
    used earlier on the line that defines it is reported as used before definition.
2026-10-14 feat: RC-A11 compile TikZ blocks; a file with no block is an input error
    check_diagram_sources skipped every TikZ/LaTeX block and passed a file with no
    block (exit 0 even with --require-render). It now compiles TikZ with LuaLaTeX
    (else pdfLaTeX) in a standalone harness loading tikz and tikz-feynman, with
    setup fences of the same file (packages, \tikzset styles) in the preamble; a
    TeX error is a source error, a missing package an environment error, and
    --no-tikz switches the compile off. A named file with no block exits 2. A
    fragment that cannot compile alone carries '% diagram-check: skip <reason>'
    (the Beamer overlay snippet in legends-panels-and-export.md). The shipped-
    bundle test compile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
2026-10-14 docs: RC-B9 one dated compile record per example; what the LuaTeX warning means
    examples/README.md said hep/08's TikZ was compiled with Tectonic, hep/08 said
    it was not, and tikz-patterns.md said its snippets were compiled and then
    unverified. All shipped TikZ now compiles under check_diagram_sources.py
    (LuaHBTeX 1.24, TeX Live 2026, 2026-10-14) and each file says so, compiled
    not inspected. pdfLaTeX prints tikz-feynman's 'LuaTeX is required' warning
    for correct manual layouts too (checked), so only the render tells; the
    standalone class needs luatex85 under LuaLaTeX. The source's
    legends-panels-and-export.md standalone+lualatex line does not exist; the note
    went to tikz-patterns.md (Q8).
    C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
2026-10-14 docs: RC-D1 quick-question block in SKILL.md
    Quick literature questions skipped the skill or got no instruction on how to
    answer 'from the ledger or a stated lookup'. SKILL.md now has a five-row Quick
    questions table (paper exists, what an experiment published / latest result,
    what a paper states, does a source support a claim, cite this) mapping each
    to ledger -> lookup recipe -> answer with source, query, date and read level.
    Bytes freed by moving the per-script descriptions to the README pointer.
    SKILL.md 8098/8192 B, description unchanged (950); routing static check ok.
    The description change itself awaits the owner (draft in the task folder).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
2026-10-14 sci-fix: DR-WP3 reference corrections (appendix A), one home per duplicated block
    Step 1 (AB-A39): core-detector-equations.md is the single home of the seventeen relations and
    detector-measurement-framework.md of the chain and the fourteen questions; the summary points to
    them (its equation table, chain diagram and question list are gone). New
    tests/skills/detector_response/test_reference_links.py checks every relative link and anchor and
    the pointers.
    Step 2, applied (source opened 2026-10-14 in brackets; arithmetic or logic otherwise):
    - equations/summary/metrics: E2 0.2998; K = 0.307075 [PDG passage]; Landau-Vavilov regime and
    Bichsel [PDG]; Highland plane rms and one total x/X0 for a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
2026-10-14 sci-fix: PML-WP0.7 one training-domain method for training, inference and surrogates
    ML-C08, ML-C09, ML-C19, ML-C18. check_surrogate_domain.py's method becomes
    the importable class DomainModel (fit, classify, to_dict, from_dict); the
    script's output and random streams are unchanged for the ungrouped case
    (J9's pseudo-data flags are identical, only the method string changed).
    - Grouped calibration: with "groups" the held-out part and the two
    cross-fit halves are split by group (design point, run), so replicas do
    not sit on both sides. With 300 design points x 10 replicas the reported
    false-positive rate is 3-10% against a measured 5-11% (nominal 5%);
    ungrouped it reports 4% while 100%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
2026-10-14 docs: RC-C2 cosmic-ray, astroparticle and neutrino figures and diagrams
    All eight HEP diagram examples were collider-only and cosmic-ray figure
    guidance was one table row. physics-plots.md (C1) now holds flux x R^2.7 and
    x E_K^2.7 conventions with the A/Z assumption handed to hep-theory (seen in
    AMS PRL 126, 041104, full text opened 2026-10-14), Lafferty-Wyatt bin
    positions (INSPIRE Lafferty:1994cj), ratios, Bartels-rotation time series,
    systematic breakdowns and neutrino contour and L/E figures. diagrams-hep.md
    gains a non-collider section and three new examples render: hep/09 stacked
    space spectrometer (generic, no parameters), hep/10 flux analysis chain,
    hep/11 near/far oscillation chain.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
2026-10-14 docs: RC-C11 concrete poster and talk formats
    poster-and-talk-design.md now gives beamerposter and tikzposter starting
    points for A0 (841 x 1189 mm; both compiled to A0 pages here 2026-10-14), the
    US 48 x 36 in case from the venue's instructions, text sizes as a labelled
    heuristic, Beamer aspectratio=169 (160 x 90 mm pages, compiled), a
    slides-per-minute heuristic, collaboration speaker approval, and a Done-when
    line checked with pdfinfo. Replaces 'ten feet' (D5).
2026-10-14 docs: RC-B7 one sourced ledger claim for the absent AMS preprint (profile)
    The skill text removed the unsourced 'deliberate collaboration policy'
    reading of AMS letters without arXiv preprints (RC-B7, 429afb2 before
    rebase). The fact that can be sourced goes to the public AMS-02 profile
    ledger instead: ams02:C185, an absence claim (support_kind absence_search,
    metadata-only, 2026-10-14) that INSPIRE record 1844651 of PRL 126, 041104
    carries no arxiv_eprints field, with its search limits stated. Index
    regenerated with core/evidence/render_index.py; ledger check passes. Made
    after DR-WP4's profile commit (4a74e06) exists on fix/detector-response-audit;
    that commit does not touch evidence/.
    Co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
2026-10-14 test: PML probe and provenance-gate tests skip without example outputs
    tools/check_ams_optional.py runs the contract tests on a copy without
    example outputs; the J9-based rows and tests now skip there instead of
    failing at import.
2026-10-14 physics-ml: PML-WP1.1 downstream validation is structured, not a phrase
    ML-K02. New vocabulary ml_downstream_metrics (expected-limit,
    expected-uncertainty, working-point-efficiency, data-sim-agreement,
    closure, coverage, pull, bias, resolution, background-rejection,
    significance; calibration-ece, roc-auc, accuracy and loss marked as ML
    metrics). From contracts 2.8.0 a downstream item is {metric, quantity_affected,
    value, uncertainty?, criterion, passed, ref}: free text is
    ml.downstream_unstructured (error; warning for older artifacts under
    --strict), a structured item without its keys ml.downstream_incomplete.
    Every item an ML metric or a bare pass is ml.downstream_ml_only (error,
    also under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
2026-10-14 physics-ml: PML-WP1.2 output semantics required; misspelled ml-artifact keys are errors
    ML-K04 (decision Q2). From contracts 2.8.0 a classification, inference or
    regression model without output_semantics is ml.output_semantics_missing
    (unresolved; a warning for older artifacts under --strict): the
    calibration rule depended on a field the artifact could leave out.
    _key_checks takes a kind argument (codes <kind>.misspelled_key and
    <kind>.unknown_key; the measurement-spec wording is unchanged) and checks
    the ml-artifact extension and its splits, calibration, domain_shift,
    weights and environment blocks: output_semantic, calibraton and
    domain_shfit are errors (probes M55-M57), unknown keys warni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
2026-10-14 fix: RC-C1 RC-C4 RC-C7 RC-B7 gate findings: no experiment names outside examples; ledger counts
    check_layering refused ATLAS, CMS and AMS in three new references outside an
    example block: the AMS flux-convention citation is now an example block and
    the others are generic. The AMS-02 profile's ledger tests pinned 184 claims;
    they now expect 185 and check that C185 is a search-limited absence claim.
2026-10-14 physics-ml: PML-WP1.4 weights and calibration outcomes are checked, not recorded only
    ML-K09, ML-K14, ML-C27 (decision Q5). From contracts 2.8.0:
    - weights: free text is ml.weights_unstructured (error; warning for older
    artifacts under --strict); an empty used_in, training weights without
    "loss" in used_in, "calibration" in used_in without a calibration, and
    a duplicated entry are errors; negative_weight_treatment none-present
    while the training block treats or counts negative weights is
    ml.weights_contradiction; |w| training warns; structured weights
    without separate training and evaluation blocks warn
    (ml.weights_not_split). The schema adds weights.training,
    weights.evaluat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
2026-10-14 physics-ml: PML-WP1.5 physics-ml scripts follow the 0/1/2/3 CLI contract
    ML-C17. Invalid input is exit 2 with a one-line message and no traceback:
    estimate_training_memory.py refuses non-finite or non-positive sizes
    (--params inf exited 0 before, -5 exited 1), estimate_compute_budget.py,
    serving_capacity.py and compare_model_runs.py exit 2 instead of 1,
    inspect_checkpoint.py exits 2 on a refused unpickle, and counts
    (--batch-size, --num-workers, --batches, --max-batches, --steps, ...) are
    validated by argparse (a negative batch size crashed
    check_dataset_contract.py with a traceback). A missing PyTorch is exit 3
    everywhere. check_split_integrity.py, check_surrogate_domain.py,
    make_grouped_sp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
2026-10-14 fix: PML-WP1.3 type the label list for mypy 2.4.0
    mypy 2.4.0 (CI pin) rejected len() and iteration over the label value
    in _ml_task_blocks_v2; behaviour unchanged.
2026-10-14 test: physics-ml checks that only run without PyTorch match the CLI contract
    CI (no PyTorch) failed two tests that the E2 environment skips:
    - without PyTorch the scripts exit 3 (missing dependency) since ML-C17;
    the degradation test still expected 1;
    - the J9 tolerance test (ML-K13) compared environment.framework, the
    installed NumPy version, exactly; it is skipped like the digests.
    Verified with requirements-ci.lock (no torch): run_all_checks exit 0,
    3162 tests, 0 failures; and with E2 (torch).
2026-10-14 test: check runs keep failure messages; J9 tolerance test lists every difference
    run_all_checks.py records the last 800 characters of each failing test's
    traceback under "messages", so a CI check-run artifact says why a test
    failed, not only which. The J9 committed-artifact test collects every
    mismatch instead of stopping at the first. Needed to diagnose a J9
    difference seen only on the Linux CI runners.
2026-10-14 test: J9 artifact comparison tolerates cross-platform float differences
    CI on Linux showed five differences against the macOS-committed J9
    artifacts: model_hash and calibration fit_sha256 (hashes over float bytes)
    and the calibration temperature, ECE after and floor (2-6e-9 relative,
    an iterative fit amplifying last-bit BLAS differences). Digest fields
    are skipped and the relative tolerance is 1e-7; results.json still
    matches byte for byte.
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2026-10-14 contracts: committed fixtures for the 2.8.0 ml-artifact rules (PML follow-up G-6)
    tests/contracts/make_fixtures.py generates one fixture per ml-artifact rule of contracts 2.8.0
    (ml_v28_*: 4 valid, 33 invalid, 11 unresolved, 4 warning; statres_v28_* for observable_source):
    structured downstream validation, output semantics and near-miss keys, task blocks (surrogate,
    generation, inference, unsupervised anomaly_validation, reweighting_validation), model-hash
    format, weights split, calibration outcome, domain-shift outcome, observable_source. Before,
    these rules were exercised only in memory by the mutation probe. MlV28FixtureTests checks that
    every 2.8.0 code has a committed fixture, that each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
2026-10-14 tests: regression tests for anomaly_validation, reweighting_validation and the temperature bound warning (PML follow-up D-1)
    TaskValidationRegressionTests: an unsupervised model with empty labels and no anomaly_validation
    is an error (ml.task_validation_missing), with the block it is clean, and empty labels stay an
    error when supervised; a reweighting model without reweighting_validation is an error and a block
    missing closure, prior_dependence or unmatched_events is ml.task_validation_incomplete.
    CalibrationWarningTests: perfectly separated synthetic scores put the temperature at its lower
    search bound (0.05) and the warning is in calibration.warnings (the block write_ml_artifact.py
    copies)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
2026-10-14 docs(detector-response): tracking - Gluckstern validity, N = 3 coefficient, beta power, silicon damage
    AB-F18 (N >= 10, N = 3 coefficient 9.8, projected L, X0 as a length), NV-1 (beta to the first power,
    PDG RPP 2025 eq. 35.70), AB-F3 (silicon response and radiation damage, PDG RPP 2025 sec. 35.8).
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2026-10-15 feat(hep-statistics): binned time-series inference reference and covariance test (WP2)
    New references/time-series-inference.md: time-bin covariance (time-independent
    fully correlated plus time-dependent parts, PSD and limit checks), periodicity
    against an AR(1) red-noise null, trials over periods and energy bins, joint
    multi-period fits. Linked from SKILL.md Resources, the core-stats-guide index
    and astroparticle-statistics.md. Synthetic test of the covariance recipe.
2026-10-15 feat(adapters): CRDB adapter with recorded-export tests (WP9)
    adapters/crdb 0.1.0 (owner hep-theory): one CRDB REST query, no default
    experiment filter (exit 2), every row secondary, provenance sidecar.
    Fixtures recorded live 2026-10-15 on E2 (CRDB V4.2).
2026-10-15 ci: actionable failures, per-check timings, split AMS-optional job, reconciliation gate
    Batch 1 of the CI improvement proposal; test obligations unchanged.
    - run_all_checks.py: seconds for every check, failed test ids with traceback
    tails on stderr and in a Markdown job summary (--summary), --part static /
    ams-optional, units plan (module list digest, shard modules, timings digest).
    - reconcile_check_runs.py + checks-complete job: every expected run present
    once, same commit, passing, permitted skips only, every planned check run,
    shards partition this tree's module list.
    - module_timings.json refreshed from CI run 38680162693.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
2026-10-15 Python 3.13 floor: review fixes (installed-tree test, old caller/PATH probes, PyROOT floor)
    - test_pyproject: the CI half needs a repository checkout and is skipped in an
    installed plugin tree; the README half always runs.
    - test_find_python: the all-old case uses four distinct old interpreters, so
    the caller and PATH candidates are probed and rejected, not deduplicated.
    - PyROOT tests (test_root_integration, test_root_cpp_assets) never use an
    interpreter older than 3.13 (tests/skills/hep_computing/pyroot_floor.py,
    test_pyroot_floor.py); capability matrix notes that E1/E3 and the E3 PyROOT
    3.9.25 runs predate the floor; the nstccore worker interpreter is the batch
    runner's runtim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
2026-10-15 cr-secondary-antiprotons: external benchmark against di Mauro et al. 2014 Table VI (B2)
    Implements the paper's closed-form pp parametrizations (Eqs. 11-13, B1-B2;
    Tables III-V, VII) for the benchmark only, with the proton flux of
    arXiv:1402.0321v2 Sec. 2.3. 12 of 15 Table VI entries reproduced within the
    paper's own 1-sigma errors; the rest documented with reasons. Ledger: S02 read
    in full, S01/S03 opened for tables and ancillary files, new S05, claims C07-C11.
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2026-10-15 registry.py: reject unknown arguments with exit 2
    An unknown flag (for example validate.py's --profiles-from) or a stray positional
    was ignored and the run reported ok, so a misspelt companion check looked clean.
    Now a JSON error names the argument and the exit is 2; --help prints the usage.
2026-10-15 test: tikz source-error case skips when the TeX preflight is incomplete
    A TeX engine on PATH whose install fails the renderer preflight (for example a
    missing luatex85.sty) gives exit 3, not a source error; the case now skips with
    the preflight reason, as its no-TeX neighbour does. With a complete install the
    exit-1 and source-error assertions are unchanged. A stand-in engine covers the skip.
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2026-10-15 covariance_fit tabulated-grid: keep the Fisher-matrix steps inside the grid
    A best fit inside an edge cell had less than one cell on one side; the one-sided
    second-order difference then stepped two cells inward and left the grid
    (CovFitError 'outside the grid'). Steps are now cut at the grid edges: a
    three-point central difference with unequal steps inside the grid, and a
    one-sided step no longer than half the room on an edge. Steps are unchanged
    where a full cell fits on both sides.
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2026-10-16 v6.3 D04: effect catalog and operator coverage contract (V35, V43, V58 definition parts)
    contracts/vocab/effects.json classifies effects and states the exposure
    composition with its conditions; the coverage contract for differential-flux
    (bound by the table digest) lists stage, covered effects, class members and
    factor powers per operator, leaving undefined member sets unverified (O09).
    contracts/effect_catalog.py checks both and offers coverage_state and
    resolve_members. The legacy table, its digest and IMPLIED_CORRECTIONS are
    unchanged; no old entry point reads the new files.
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2026-10-16 v6.3 M2a review fixes: no pass or traceback on missing or malformed inputs; declaration flags for every state
    Findings 1-10 and the two low ones of the code review, each with a regression test
    in tests/contracts/test_v63_review_fixes.py.
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2026-10-16 v6.3 D12b: stage-1 custody inventory contracts/custody.py (V30); missing custody metadata is never public, refusals unchanged
2026-10-16 v6.3 D05d: design, result-binding schema, run fixtures (RUN-CHAIN, RUN-CAMPAIGN with LocalExecutor and a test-side freeze), red tests (V20, V32, V33, V38, V53-V56, V61-V63, V70, V60 post-execution), 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
2026-10-16 v6.3 D05d: run-lineage/v1 (result binding, R-CLOSE, status, campaign-recorded level, blinding allowed_outputs rule), post-execution permit check; all 80 V parts pass
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2026-10-16 sci-fix: F-02 result_artifact.py writes the paradigm it is given (--paradigm, Bayesian fields)
    Old behaviour: every statistical-result was written with paradigm frequentist,
    including results from MCMC posteriors.
    New behaviour: --paradigm frequentist (default, unchanged output) | bayesian |
    likelihood-only. Bayesian reads bayes_diagnostics.py diagnose output and writes
    priors, sampler, convergence and posterior quantiles; frequentist fields refused.
    The MCMC row of the hep-statistics Step 0 table names it.
2026-10-16 sci-fix: F-03 li_ma_significance.py prints status, method_kind asymptotic and a low-count warning
    Old behaviour: no status key, no asymptotic label, no low-count warning, although
    the capability matrix said the statistic is labeled asymptotic.
    New behaviour: status ok, method_kind asymptotic, warnings list (N_on or N_off
    below 10, a [Proposal] threshold, without --toys/--exact-conditional). Numbers
    unchanged. The result_artifact missing-status probe now strips the key itself.
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2026-10-16 F-09: covariance_fit.py runs a plugin model only with --allow-plugin
    The plugin file is resolved relative to the input file's folder, and an exception
    at import or inside the model function is reported as status failed (exit 1) with
    no traceback. fit() takes allow_plugin and base_dir.
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2026-10-16 F-14: core levels top-of-instrument and top-of-atmosphere (minor, additive; gate G4 approved)
    contracts/vocab/core.json gains two level terms; nothing is removed or tightened, and
    the profile term crflux:top-of-instrument is unchanged. The synthetic cosmic-ray
    worked spec uses top-of-instrument instead of detector. No contracts version bump
    (left to the maintainer at gate G1).
2026-10-16 B-05: reference soft budget warnings in tools/reference_inventory.py
    Both modes print warnings (never a failure) for the routing part of an entry
    reference above 4 KB and any reference above 24 KB. Today: 2 routing parts
    (hep-detector, hep-measurement entry references) and 7 references.
2026-10-16 B-02: a routing table (request -> one file or script) under each SKILL.md Resources heading (gate G2: live routing not run)
    Seven tables of 1.68-1.95 KB in the '| Request | Read or run |' format; in hep-theory
    the table replaces the Resources link chain, in hep-ml the former Task/Read table.
    SKILL.md files 7,895-9,322 bytes (limit after B-02: 11,264). Prose kept where the
    table does not carry it (submission rule, templates, interpreter lookup order).
    tests/skills/test_routing_tables.py checks presence, size and that every named
    file exists. The hep-statistics Step 0 table gains no rows: S1 and S2 do not exist.
2026-10-16 B-03: lighter entry references (SKILL.md plus entry reference <= 25 KB)
    - hep-measurement-guide.md: routing first (handoffs in their own section); the
    cosmic-ray invariants move verbatim to cosmic-ray-measurements.md; example requests
    move to the README. 20,571 -> 16,403 B.
    - detector-principles-summary.md: passages duplicated in detector-comparison-tables.md
    and detector-case-studies-and-checklists.md replaced by links; five diagnostic rows
    the tables lacked were moved into Table 7. 19,836 -> 15,090 B.
    - ml-analysis.md: 7,000 B core (task routes, splits, metrics) plus four subfiles
    (weights; decorrelation and systematics; training and data; validation and
    deployment), text moved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
2026-10-17 Th7: four-vector kinematics in core/kinematics/fourvector.py and kinematics.py
    Two-body decays (Kallen function), Lorentz boosts, invariant masses, Mandelstam variables, fixed-target
    thresholds, Dalitz boundaries, rapidity and pseudorapidity, and width/lifetime/c tau with the exact hbar and c
    of core/constants. The CLI takes masses as numbers or bundled PDG 2026 particle names and records their source.
    Oracles: conservation after decay and boost, boost-invariant mass, s + t + u = sum of m^2, Dalitz points from
    sequential decays inside the boundary, the 7 m_p antiproton threshold.
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2026-10-17 D1: propagate_scale_distortion.py (response, events) and "Propagating a calibration residual"
    Modes scale (x_m = (1+s)x), inverse-offset (1/x_m = 1/x + q delta), resolution (core and tail widths) and a user
    plugin behind --allow-plugin (path relative to the input, errors give status failed). Outputs per-variation yields,
    per-bin shifts, {nominal, up, down} for check_systematic_variations.py (events: with the variance of the
    difference), a rank-1 correlated covariance block and the opposite-sign ratio shift; an optional
    --validation-record (needs --effect and a ratio) that validates against validation_record.json. No default s or
    delta; a missing charge sign is refused; |q x delta| > 0.3 warn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
2026-10-17 Th3: charge-sign-dependent modulation in the force-field section (drift limits, polarity eras, one phi per period; cycle-25 reversal from arXiv:2606.15259, abstract read)
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2026-10-17 D5: mix_period_responses.py (mix per truth bin with w = A x T, stack for a joint fit) and "Time-dependent responses"
    mix: R_eff[:, j] = sum_t w_tj R_t[:, j] / sum_t w_tj; folding it with the summed weights equals the sum of
    the per-era folds; conventions checked across eras; zero total weight, negative or missing weights refused;
    weight-source and response checksums recorded; effective MC counts when every era carries generated
    counts; the mixed artifact is validated like D9's. stack: [R_1 diag(w_1); R_2 diag(w_2); ...] for S6.
    Synthetic inline response asset for the CLI contract tests; detector script count claim now twelve.
2026-10-17 D10: multisample_pid.py (charge from many dE/dx samples with the leakage matrix; LLR from per-layer PDFs) and "Combining many samples"
    charge: path-length correction (or an explicit waiver), inversion of a user response curve (saturation allowed),
    truncated mean, weighted mean (optional common layer correlation, GLS weights) or a Moyal likelihood; per true charge
    the peak, sigma68 and tail fraction; the leakage matrix between neighbouring charges with Clopper-Pearson intervals
    (core/stats/tail_estimation.py); toy prediction of the core width. likelihood: LLR from binned per-layer PDFs and the
    efficiency - mis-identification curve. "independence assumed" without declared correlations.
    Oracles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
2026-10-17 D11: stability_monitor.py with core/stats/change_point.py (trends, change points, CUSUM, tolerance, proposed era boundaries) and "Monitoring stability over time"
    core/stats/change_point.py (steward hep-statistics, so S9's period searches reuse it): the step statistic
    z_k = |m2 - m1| / sqrt(1/W1 + 1/W2), binary segmentation, two-sided CUSUM, thresholds calibrated by seeded toys to a
    declared false-alarm rate, weighted constant/linear/piecewise fits. stability_monitor.py: --false-alarm required,
    periods out of a declared tolerance, proposed boundaries of kind calibration (never written into a spec).
    Oracles: the null false-alarm rate equals the declared one; an injected step is found at its pl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
2026-10-17 M7: spectrum_transform.py, a bin-averaged flux in another spectral variable with an isotope composition
    The target bin receives the integral of f_i(x) Phi(x) over each isotope's mapped interval, divided by its width:
    a Jacobian and bin average, never a relabeling. One isotope on mapped edges is exact; otherwise a declared
    within-bin shape (constant or local power law) is required. Composition: fixed, table or an opt-in plugin;
    its covariance (one nuisance per fraction, the others rescaled) is kept apart from the statistical one
    (numerical Jacobian). Masses from core/constants or a stated mass with its source; no default Z, A, mass,
    composition or shape; no extrapolation. A transformation rec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
2026-10-17 M3: multi-era design: optional spec field eras[] and four era review rules (gate G4 approved)
    - contracts/schemas/ext_measurement_spec.json: optional `eras: [{id, start, end, kind, source}]` (kind
    configuration, calibration, software, operating; optional corrections, shared_corrections, versions) and
    `systematics[].era_correlation` (correlated, uncorrelated, partial). contracts/validate.py knows the keys,
    so no unknown-key warning (it also lists M5's `scaling`, which still gave one).
    - review_measurement_spec.py: era.bin_straddles_boundary (error), era.correction_missing,
    era.correlation_undeclared, era.version_mismatch (warnings); they run only when the spec declares eras, so
    ever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
2026-10-17 S1: split_consistency.py, consistency of split samples with the shared covariance subtracted
    d = x1 - x2, Cov(d) = C1 + C2 - C12 - C21, chi2 = d^T Cov(d)^-1 d (n dof); a generalized chi2 against a common value
    for K splits ((K - 1) n dof, equal to the pairwise chi2 for K = 2); every pair tested, the smallest p-value
    corrected by Sidak and, with --toys, by Gaussian toys. Without declared cross blocks the output says "shared
    systematic uncertainties not subtracted". --alpha gives a verdict (inconsistent exits 1); without it p-values
    only. Oracles: chi2 by hand, GLS for three splits, power against the noncentral chi2, uniform null p-values by
    KS (slow tier). Step 0 row in hep-statistics SKILL.m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
2026-10-17 ML1: detector configuration changes (eras) in ML studies (robustness and astroparticle references)
    Per-era training, era conditioning, common features only or missing-feature indicators; per-era calibration and
    working points; efficiencies measured in data per era; link to the BDT path. Routing cases b-ml-era-1/-2.
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2026-10-17 Th1: nuclear cross-section conventions (hep-theory reference)
    Inelastic, charge-changing and isotopic production cross sections; ISM (H, He) versus detector-material targets
    with lambda = A / (N_A sigma) and the mixture rule; the straight-ahead approximation and its limits; cumulative
    cross sections with short-lived intermediates; validity of parametrization families; uncertainty as model
    alternatives plus a normalization nuisance, with correlations between corrections and interpretation declared
    together. Sources read in full text 2026-10-17: arXiv:1803.04686, arXiv:1711.09616; PDG 2024 table 6.1.
    No cross-section values are built in.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
2026-10-17 D4: survival_feeddown.py and nuclear interactions in detector material; catalog effects survival and fragmentation_feeddown (gate G4)
    Survival through layers P = exp(-sum x/lambda) with 1/lambda = sum_i w_i N_A sigma_i / A_i (N_A from core/constants),
    the correction 1/P, the cross-section scale derivative dP/ds = P ln P and a +-S variation; first-order feed-down
    N_heavy (1 - P_heavy) f with its derivative. No built-in cross sections: a table without a source is labelled
    unvalidated. The corrections are written as recipe steps with measurement:correction-keys-v1 keys. Catalog (owner
    core, version 1.0.0): effects survival (covered by divide_effective_exposure) and fragmentation_feeddown (cover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
2026-10-17 D3: charge_confusion_rate.py (template, control, gaussian-core) and the tool section of charge-confusion.md
    template: right/wrong(/background) templates fitted per bin with the full Barlow-Beeston treatment
    (core/stats/template_fit.py); the rate's 68% interval is the profile-likelihood interval in the rate (calibrated
    near zero: 200 toys at 1e-3, 1e-2 and 1e-1 cover within 0.05 of 68% with the MC templates redrawn, slow tier).
    control: known-sign sample, Clopper-Pearson per bin, data/MC scale factor; integer frequency weights only.
    gaussian-core: a lower-bound reference labelled not an estimate, with no estimate. template and control write
    sign_rates for species_response.py. Detector script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
2026-10-17 D2: species_response.py (assemble, fold, check, from-rates) and "Species migration" in response-and-forward-folding.md
    Per-species response blocks (build_response.py artifacts, conditional_on_generated, or inline) tied by a block
    manifest (manifest_version 0.1.0; no contract change): assemble checks the shared axes and that each true species'
    column sums over the reco species are <= 1, and recommends parametrized forward folding above 60 flattened bins;
    fold is a sparse forward fold; check exits 1 when an effect a block models is also in the correction chain
    (measurement-spec corrections, recipe steps, survival_feeddown.py recipe_steps); from-rates turns
    charge_confusion_rate.py sign rates i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
2026-10-17 M4: coupled species: optional spec field coupled_backgrounds and review rule coupled.fixed_subtraction (gate G4)
    A background that is another species measured at the same time (feed-down, confused-sign partner, charge-ladder
    neighbour) is declared as coupled_backgrounds [{background, species, treatment (joint-fit, iterative,
    fixed-subtraction), source}]; review_measurement_spec.py warns coupled.fixed_subtraction on a fixed subtraction;
    every existing measurement-spec gets the same review (tested). contracts/validate.py knows the keys. "Coupled
    species" in backgrounds.md, a pointer in correction-chain.md, a row in the spec field guide.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
2026-10-17 E-1: examples/bc-fragmentation, synthetic B/C with carbon fragmenting into boron above the top layer
    M4 (the feed-down declared a coupled background, joint-fit; a fixed-subtraction copy is flagged
    coupled.fixed_subtraction) -> D4 (survival through 20 g/cm2 of carbon-like material and the C->B fraction from the
    example cross sections) -> D2 (blocks B->B, C->C, C->B assembled and folded; a planted double count with the D4
    recipe steps is caught) -> a forward-folded Poisson joint fit of boron and carbon. 400 toys: B/C pull means within
    0.07 and widths 0.95-1.02 (criteria < 0.2 and 0.85-1.15); a fixed subtraction from a carbon model 15% low biases
    B/C by about 2% in every bin (19 sigma combined)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
2026-10-17 M4: the unchanged-review test skips specs written to declare coupled backgrounds (example E-1's specs)
2026-10-17 M8: isotope_fraction.py, isotope fractions per rigidity bin from mass (or 1/beta) templates
    Templates from a declared resolution model (seeded MC: power-law R within the bin, beta from the nuclear mass of
    core/constants or a stated mass, Gaussian R resolution, beta core plus tail, the velocity detector's beta range),
    fitted with the full Barlow-Beeston treatment of the template statistics (core/stats/template_fit.py); fractions of
    the arriving isotopes (the beta-range acceptance corrected through the generated MC count) with delta-method errors,
    the Bhattacharyya overlap of the templates, and the fraction shifts for +-1 sigma of each declared resolution
    nuisance. MC-only templates without da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
2026-10-17 Th4: neutrino_oscillation.py and neutrino-oscillations.md (vacuum and constant-density matter, PMNS in the PDG convention); neutrino oscillations enter v1 (X1)
    PMNS of the PDG Review 2026 (Eq. 14.34; Sections 14.3-14.5 read in full, 2026-10-17); the flavour Hamiltonian with
    V_e = sqrt(2) G_F n_e diagonalized exactly; no built-in parameter values; a conventions block (units, L/E, neutrino or
    antineutrino, density). Oracles: two-flavour limit, unitarity, zero density = vacuum formula, CPT in vacuum,
    two-flavour MSW, the matter potential. The capability map moves neutrino-oscillations into v1 (state tool); the scope
    declaration is regenerated; th-scope-2 becomes a direct hep-theory case, as the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
2026-10-17 ML3 extensions: train_bdt.py regression objective and mass-sculpting report; export_bdt.py (JSON/UBJSON, ONNX and TMVA RBDT when installed); external TMVA/LightGBM scores through the inference checks
    - train_bdt.py: task regression (objective rmse): RMSE, bias and the ml-artifact regression checks (response and
    resolution vs truth and vs prediction, outlier fraction; closure on another spectrum recorded as not run);
    mass_column: Jensen-Shannon distance between background mass shapes passing and failing each cut.
    - export_bdt.py: save_model JSON <-> UBJSON; ONNX (onnxmltools) and ROOT TMVA SaveXGBoost only when installed,
    else exit 3 with the install command (gate G5: no new dependency)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
2026-10-17 C7: ROOT usage patterns (histogram errors, TEfficiency objects, RooWorkspace imports, installation routes) and check_histogram_errors.py (PyROOT or uproot)
    Sources read 2026-10-17 with a generic User-Agent: the TH1, TEfficiency and RooWorkspace class references (root.cern
    master), the ROOT 6.38 release notes, the install page and the PyPI record of `root` (0.1a8-0.1a12 alpha, Python
    3.10-3.14, Linux x86_64 wheels only). Boundary rule in docs/routing-contract.md (object use -> hep-computing, interval
    choice -> hep-statistics, efficiency measurement -> hep-detector; gate G3 approved). Tested in the CI lock venv, with
    uproot 5.7.6 (E2) and with Homebrew ROOT 6.38.04 under Python 3.14 (PyROOT an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
2026-10-17 D13: detector_atlas.py (validate, render, query, audit) and the atlas in the hep-detector routing
    - scripts/detector_atlas.py, generic (no experiment names): validate (ledger, then the atlas block of every claim;
    --release also fails on ledger warnings and stale-date notes), render (Markdown per experiment; every number with
    its claim id), query (bound experiment profiles, then user atlases labelled user-supplied, then the plugin atlas;
    whole-word filters; pages of at most 20 rows and 16 KiB; `unknown` when nothing matches, with the profile to read
    from the atlas's links.json, e.g. AMS-02 -> its experiment profile), audit (numbers with a unit and no claim id).
    - Gate G3 (approved): `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
2026-10-17 S5: periodicity_scan.py, weighted generalized Lomb-Scargle with a surrogate-calibrated band-maximum global significance
    White, AR(1) (sample index) or Ornstein-Uhlenbeck (time) surrogates with the series' own parameters; global p from
    the largest power in the declared band; caps on points (1e5), frequencies (1e4) and surrogates (1e4), overridable
    with --allow-outside-validated-range. Slow tier: global p uniform under white noise; the AR(1) null rejects AR(1)
    data at alpha +- 0.02.
2026-10-17 S9: time_structure.py, change points with a toy-calibrated false-alarm rate and lags with surrogates
    changepoint: binary segmentation (core/stats/change_point.py) or PELT solved exactly by dynamic programming; the
    threshold or penalty is the (1 - alpha) quantile over null toys drawn from a declared covariance, or independent
    with "independence assumed" in the output. lag: Pearson cross-correlation over -L..L, phase-randomized surrogates
    of b, global p over all lags, local p, and hysteresis between the rising and falling branches. Slow tier: the
    false-alarm rate equals the declared one; with AR(1) noise the declared covariance restores it.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
2026-10-17 Th11: secondary_gamma.py (pi0 -> gamma gamma, averaged flavour ratios, photon-target thresholds) and astroparticle-essentials.md
    pi0: dN/dE_gamma = 2 integral (dN/dE_pi)/p_pi dE_pi from E_gamma + m_pi^2/(4 E_gamma), integrated in E_pi = m_pi cosh u
    (no end-point singularity), m_pi0 from core/constants; flavour: P = sum_i |U_ai|^2 |U_bi|^2 with the PDG PMNS;
    threshold: E = (K^2 + m^2)/(2K), checked with core/kinematics/fourvector.py at moderate boosts and through
    s = m^2 + 2 eps (E + p) where the four-vector sum loses precision. The entry page (4.6 KB) routes to the propagation,
    oscillation, coalescence and dark-matter references and states DSA, Hillas, flavour ratios, thresholds and
    radioact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
2026-10-17 M2: acceptance_from_generation.py, the acceptance A(x) from declared generation records
    G_gen (cosine law on a plane, within theta_max, or a sphere) times the selected fraction of the events generated in
    each bin, with a Clopper-Pearson interval; target-spectrum reweighting (Kish effective count, labelled approximate)
    warns of circularity when the target is the measurement's own result; a missing generated count exits 3. Oracles: a
    flat detector gives G = pi S; two coaxial discs match a straight-line Monte Carlo and the closed form's limits (the
    form is computed without cancellation; the Sullivan 1971 attribution is to-verify). Section "Acceptance from
    generation records" in correction-chain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
2026-10-17 M9: anisotropy.py, right-ascension exposure from periods, first harmonic, dipole projection, amplitude upper limit and spurious-modulation checks
    exposure: relative exposure per right-ascension bin from data-taking periods (collection_time.py conventions) for a
    top-hat field of view around the zenith right ascension, advancing one turn per sidereal day from the user's local
    sidereal time at t = 0. harmonic: the weighted first harmonic (Linsley; Rayleigh probability with the effective
    count), d_perp with declinations, a Neyman upper limit from the Rice distribution (non-central chi-square as a
    Poisson mixture; Gaussian far from the noise) power-constrained at the expected limit, and solar, si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
2026-10-17 evals: 180-case regression check of the description fix (165/180) and repeats: no regression
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2026-10-17 evals: count shell reads through variables and cd; a turn limit is not a host error
    The 2026-10-18 cost probe failed 5 runs on "never read profiles/experiments/<x>/index.md"
    although the transcripts show the read, written as `P=...; cat $P/index.md` or
    `cd .../eic && cat index.md`. Shell-command path matching now substitutes the variables a
    command assigns and joins relative words to the directory of a preceding `cd`.
    Runs that stop at --max-turns (result subtype error_max_turns) were marked host errors
    and failed regardless of the graders. They are now recorded as turn_limit and graded.
2026-10-17 evals: WP2 cost-probe summaries, claude-sonnet-5-5, 16 runs
    Plugin commit bd189ac7, setting-sources isolation, $0.50 per run, 0 contaminated,
    $1.80 total. Graded with the fixed graders (regrade of the recorded runs).
2026-10-18 contracts: project.py --preflight prints the bound profiles' index.md; context resolution runs it first
    In the 2026-10-18 behavioral baseline the bound profile's index.md went unread in 40 of
    Sonnet 5.5's 47 and 63 of Haiku 5.5's 68 runs with a blocking failure, usually after the
    skill had loaded (CTX-READ-BOUND-PROFILE).
    - contracts/project.py --preflight lists, for each bound profile shipped in the plugin, its
    index.md path, sha256 and text. A local or companion profile is listed as not-in-plugin.
    An invalid config lists nothing. Without the flag the output is unchanged.
    - Context-resolution step 1 runs it when a project config is present. Step 3 points to it.
    The stanza grew 10 byt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
2026-10-18 evals: WP4 re-measurement after the profile preflight (both models, paired with the baseline)
    The boundary preset was rerun on main b7441006 (PR #145): 165 runs per model, paired with
    boundary-2026-10-18-*, plus 18 runs per model on the three new L2 cases. Isolation was
    setting-sources, 0 contaminated. Cost: $21.52 + $1.40 Sonnet, $1.86 + $0.10 Haiku.
    Sonnet:
    - L1 natural pass: 54.5% -> 90.9% (McNemar p = 8.4e-06);
    - runs with a blocking failure: 47 -> 15;
    - bound-profile read, natural arm: 53.8% -> 92.3%.
    Haiku:
    - L1 natural pass: 56.1% -> 74.2% (p = 0.0075);
    - runs with a blocking failure: 68 -> 37.
    Both models still fail gate.json. L3 is still 0/6. The baseline was regraded with the
    cu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
2026-10-18 evals: paired L3 measurement before and after the gate and handoff-validation steps
    All eight L3 cases, natural and forced arms, 3 repeats, 48 runs per model per version.
    "Before" ran on main b7441006 and "after" on this branch; the two behavior hashes differ.
    0 contaminated, 0 host errors. Total cost $14.68.
    - Sonnet: L3 pass 16.7% -> 45.8% (McNemar p = 0.031 natural, 0.0078 forced). Gate run
    0/6 -> 6/6; handoff validated 0/18 -> 10/18.
    - Haiku: L3 pass 25.0% -> 56.2% (p = 0.016 natural, 0.0078 forced). Gate 0/6 -> 6/6;
    handoff validated 4/18 -> 17/18.
    The two chain cases are still 0/6 on both models (artifact validity, synthetic label).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
2026-10-18 contracts/validate.py checks a whole artifacts_dir; producing skills run it last
    Given a directory, validate.py validates every JSON file under it. A JSON file
    without artifact_type (a raw tool output) is an error, artifacts_dir.not_artifact;
    other files are warnings, hidden files are skipped; --gate still takes one artifact.
    Context-resolution step 5 and the final validate step of hep-detector,
    hep-measurement, hep-ml and hep-statistics now name <artifacts_dir>; the stanza,
    hep-measurement and hep-statistics edits are byte-neutral or shorter. On the v2
    chain transcripts the check flags exactly the scratch files the grader failed on.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
2026-10-18 evals: chain v3 (artifacts_dir check): chains 0->4/12 sonnet, 1->9/12 haiku; haiku fault-case regression
    l3-response-unfold-report's min_fraction 0.67 made ceil() require all three
    hops; 0.66 requires two, as the grader docstring intends. All L3 runs are
    regraded with it (no earlier pass or fail changed) and their summaries and
    comparisons regenerated. v3 cost $9.48. Haiku stops validating the handed-over
    response in the fault cases (validator run 22 -> 13/30, McNemar p = 0.012).
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2026-10-19 skills: validate handed-over artifacts on the quick path; unfolding loads hep-statistics
    Haiku (L3 fault cases) took hep-statistics' Step 0 quick path, which said the
    workflow is for new models, and so skipped step 1's validation; Step 0 now
    validates a handed-over artifact first. Sonnet (L3 unfold chain) followed
    hep-detector's direct link to hep-statistics' unfolding reference and never
    loaded the skill; the reference and unfolding.md now say to load it. The
    Resources note repeating Step 0's script paths is removed for size.
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2026-10-19 L3 chains: unfolding result writer, referenced sidecars, hep-ml handoff, outside-write detection
    - result_artifact.py copies numeric vectors and matrices into results (an
    unfolded spectrum keeps estimate, sigma and covariances) and creates the
    --out folder; unfolding.md and the Step 0 row give the unfolding command.
    - validate.py on a directory accepts files an artifact there refers to by
    path (listed as sidecars); the artifact_valid grader runs that check.
    - hep-ml references: a limit, fit or significance loads hep-statistics.
    - build_response.py skips '#' comment lines in a CSV.
    - runner: new top-level entries in ~, ~/hep-work, ~/.venvs and the repository
    that a run names are recor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
2026-10-19 evals: remaining-chains measurement: sonnet 43 -> 46/48 (chains 7 -> 10/12), haiku flat
    Paired against #149 (regraded with the directory-check grader). Sonnet passes
    all unfold runs and 4/6 ML runs; Haiku 39 -> 38/48, chains 6 -> 7/12. No run
    wrote outside its workspace. Clean run $6.65; the collided first attempt
    ($15.03) is set aside.
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2026-10-19 evals: hep-ml hand-off measurement: haiku forced arm loads hep-statistics 1/12 -> 5/6
    ML case only, 6 repeats per arm, repeats 0-2 paired against #150. Haiku forced
    pass 0/3 -> 5/6 (+3 / -0). Sonnet hops 6/6; its failures are all the folder
    check (train_bdt.py outputs left in artifacts_dir), a path this PR does not
    change. Cost $3.60.
2026-10-19 hep-ml: a BDT's ml-artifact names its fold models; run folders stay out of artifacts_dir
    write_ml_artifact.py read only a summary's "checkpoint", so train_bdt.py's
    per-fold "models" were missing from outputs and the artifacts_dir check
    flagged them. They are now outputs (checkpoint:fold<k>); a train_bdt.py run
    folder with its ml-artifact passes the folder check (end-to-end test).
    Workflow step 3 says configs, run folders and raw tool outputs go in a work
    folder. Every Sonnet failure in the #151 ML-chain measurement was these files.
2026-10-19 evals: ML run-outputs measurement: sonnet folder-check failures 6/12 -> 0/12
    ML case only, 6 repeats per arm, paired against #151. Sonnet forced pass
    2/6 -> 6/6. Haiku forced 5/6 -> 2/6 (p = 0.25): the three misses kept their
    files in ml-work/ and failed in the pre-#151 ways (inline CLs, asking for
    inputs, train_bdt NaN on 16 events). Also corrects #151's count (6 of 12, not
    5). Cost $2.89.
2026-10-19 hep-ml: train_bdt.py refuses a validation part it cannot score
    A fold's validation part with no events or one class made every grid point's
    objective NaN; the script trained and saved fold models anyway, then crashed
    writing run_summary.json (exit 1, traceback, no JSON status). It now stops
    before training with exit 2, "rejected" and the counts, naming what to
    change. A last guard refuses an all-NaN objective. Regression test on a
    16-event sample keyed by run, for both backends.
2026-10-19 hep-ml: train_bdt.py refuses only when no validation part is usable (fixes #153)
    #153 refused a run when any fold's validation part was empty or had one
    class. The old code let the other folds choose the hyperparameters and only
    failed when none could; the full L3 run on main showed Sonnet stopping on that
    refusal in 2 of 6 ML runs, and on their data all 9 fold/validation_fraction
    settings trained before #153 and were refused after it. Now the run is refused
    (before training) only when no fold has a usable validation part; a fold with
    none is skipped in scoring, which also stops the scikit-learn backend from
    crashing on an empty array. Adds the full-L3 results on main (sonnet 46 -> 43,
    haiku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
2026-10-19 evals(routing): stop when hep-research is not loaded; resolve --plugin-dir
    A relative --plugin-dir pointed into each case's temporary folder, so no
    plugin loaded and every case scored no-skill without any warning. The path is
    now resolved first, and a Claude session that does not report hep-research
    stops the run like contamination.
2026-10-19 feat(contracts)!: 3.0.0 retires the deprecated skill names
    Migration option A, second step (restructuring plan section 9). The schema enum
    lists only the eight current skills; a retired name (0.11.0 rename aliases and
    the 0.16.0 split alias) in an artifact or a profile is an error,
    skill.unknown_name, pointing to migration with hep-research 0.16.x; any other
    unknown handoff.to_skill is the same error. migrate_skill_names.py, its fixture
    and test, and the README 'Formerly' lines are removed. New
    tools/check_retired_names.py (retired names kept only as SHA-256 hashes) runs
    as a static check. Profile ranges <4.0; fixtures, templates, theory-profile
    artifacts and examples at 3.0.0. No plugin ver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
2026-10-20 test: independent oracles and negative controls for existing scientific corrections
    Evidence added for fixes already merged (no product code changes):
    - POISSON-SF: negative control, the pre-fix complement 1 - P(N <= n - 1) fails the high-precision reference.
    - FC-MONOTONE: second independent oracle, a brute-force maximum of the independently written plain upper end over
    b' in [b, b + 2] on a 0.01 grid, against the FC 1998 Table IV fixture; the plain construction is the negative
    control.
    - COV-NOREPAIR: numpy.linalg.eigvalsh oracle on 400 random covariance matrices with variances 1e-12..1e12; the
    pre-fix jitter repair is the negative control (it accepts every indefinite case the fix re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
2026-10-20 docs: sci-fix scope, two-axis evidence rules and an evidence ledger of past corrections
    docs/maintenance.md: sci-fix is for changes to numbers, verdicts or method guidance (S1-S3); crash, hang and
    concurrency fixes use robust-fix (S4). Evidence is graded on a correctness axis (C1-C4) and a discrimination axis
    (D0-D3), reported separately, with minimums per severity, oracle rules and a per-test VALIDATION row template.
    docs/evidence/sci-fixes.json records the 26 code corrections in CHANGELOG with their grades from an audit on
    2026-10-18 (to be reviewed by a maintainer); tests/tools/test_scifix_ledger.py checks the vocabulary, the evidence
    paths, grade consistency and that every entry below it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
2026-10-20 docs: per-test parent records for 13 fix commits (plan PR-4)
    VALIDATION SCIFIX-PARENT-RECORDS: for each fix commit behind a ledger entry graded D0 or D1, the fix's test changes
    ran on its parent and on the fix, one row per test that fails on the parent and passes on the fix, with the failure
    kind (assertion, named exception, or import error of the module, which is not counted as discrimination). Two runs
    are adapted and say how (F01-F03: the parent tree takes the two modules new in the fix; ML-SPLITS: a new import is
    guarded). E2 venv, slow tier on.
    Discrimination in docs/evidence/sci-fixes.json: 12 entries reach D2 (FC-MONOTONE, POISSON-SF, COV-NOREPAIR,
    POISSON-500, ROBUST-MALFORMED, BLIN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
2026-10-20 test: release-manifest test repo turns off git auto-maintenance (flaky tearDown)
    PublishedImmutabilityC10 failed once on CI (#165, first attempt) in tearDown:
    OSError: [Errno 39] Directory not empty: '.../repo/.git/objects'. Each commit
    spawns a detached `git maintenance run --auto` (trace2 shows it), which writes
    .git/objects/maintenance.lock while TemporaryDirectory.cleanup() removes the
    tree. maintenance.auto=false and gc.auto=0 in the test repo's config stop it,
    also for the git calls of tools/release_manifest.py under test.
2026-10-20 test: second oracles, invariants and negative controls for four S1 corrections (plan PR-6, batch 2)
    ML-DOMAIN: each statistic's flag rate equals the split-conformal value
    a = 1 - min(r, n)/(n+1) and the union lies in [a, 2a] (two-sided), with a small
    setting that resolves a one-rank shift; the reported interval equals
    Clopper-Pearson from scipy.stats.beta. Negative control: the pre-fix min/max box
    (10.5% at d = 32 against 2a = 1.7% / 5.0%).
    ML-NEGWEIGHTS: Asimov Z against q0 on the Asimov dataset (mpmath, 50 digits;
    tolerance 1e-14 below the series switch at s/b = 1e-6, 1e-14 + 2 eps/x above),
    Cowan Eq. 20 against the profiled on/off likelihood (mpmath, 60 digits; a float
    SciPy profile lose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
2026-10-20 test: an independent oracle for each of the ten S2 corrections at C1 (plan PR-6, batch S2)
    F03: newton_fit against a closed-form two-parameter Poisson/Gaussian model
    (minimum, value, EDM and verdict at every stop of truncated fits).
    ML-K05: J9's shape_model and fit_mu with the shift nuisance against an
    independent SciPy profile likelihood; without the nuisance the shifted Asimov
    interval misses mu = 1.
    BLINDING-SCANNER: every claimed rendering in all seven claimed encodings,
    generated independently; the printed-precision rule against exact Decimal.
    ROBUST-CAMPAIGN: merged campaigns equal closed forms that bypass engine
    merging; a file-forced two-process lock test (20/20 runs per venv).
    RC-A2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
2026-10-20 sci-fix: blinding scanner reads an integer's trailing zeros as rounding (22000 for a sealed 22014)
    _printed_match read every trailing zero of an integer as a printed digit (step
    1), so 22000, 22,000 and 22010 passed the scan for a sealed 22014 while 2.20e4
    was a hit (S2: a wrong verdict). An integer token without a point or exponent
    now has its trailing zeros read as rounding, down to 3 significant digits:
    22000 is matched like 2.20e4, 22010 at the tens. 2.2e4 (two digits) stays out
    of scope; zeros before a point (22000.0) are still printed digits.
    Evidence (BLINDING-ROUNDING-ZEROS, C4, D3; VALIDATION SCIFIX-ROUNDING-ZEROS):
    - exhaustive against Decimal rounding: every sealed n and n + 0.5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
2026-10-20 sci-fix: validator sample names drop '.' segments anywhere in the path ('work/./x.csv')
    _sample_name in contracts/validate.py removed only a leading './', so
    ml.calibration_on_fit_sample passed a calibration validated on its fit sample
    written as 'work/./val_scores.csv' (S2: a validator verdict). The sample name
    now drops '.' segments anywhere and repeated or trailing separators; '..' is
    kept (resolving it needs the file system). Contracts patch change: 3.0.1 to be
    set at the release (CHANGELOG Unreleased).
    Evidence (SAMPLE-NAME-DOT-SEGMENTS, C2, D3; VALIDATION SCIFIX-SAMPLE-NAME):
    the rule against pathlib.PurePosixPath for 120 spellings with '.' segments in
    the middle or at the end, each p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
2026-10-20 ci: required pdg cross-check job; ArviZ parent record and torch-cpu record close ledger gaps
    TH9-MASSES: new required CI job pdg-cross-check installs the CI lock with
    pdg 2026.0 (SQLAlchemy 2.1.5, typing_extensions 4.16.0) and runs
    tests.core.test_constants through run_required_backends.py --require
    pdg==2026.0, so the bundled-masses test fails the job if it skips for pdg
    (missing package or another edition). Locally: 16 run, 0 skipped, exit 0;
    without pdg exit 1.
    BAYES-T24: with ArviZ 0.23.4 (the stats-backends versions) the fix's ArviZ
    oracle fails by assertion on parent bb0774f0 in five cases (MCSE ratios
    0.954, 1.036, 0.956; bulk ESS 0.993, 0.994, the same as the SciPy oracle)
    and crash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
2026-10-20 feat: sci-fix advisories and a read-only project impact scan, shadow mode (plan PR-7)
    docs/evidence/advisories/SFA-YYYY-NNN.json (format
    hep-research-scifix-advisory/1, provisional) records a corrected defect for
    people holding results made before the fix: the ledger entries as evidence
    (not repeated), the affected files and an OSV SEMVER range (introduced, then
    fixed or last_affected; open while the fix is unreleased, with
    database_specific.fixed_commit), the scientific impact apart (observables,
    bias, trigger), applies_to (artifact types and the extension keys that show
    the affected code ran) and a remedy. SFA-2026-001..003 cover the three fixes
    of #174 and #175.
    tools/scifix_advisories.p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
2026-10-20 ci: required torch-backend job runs the PyTorch tests with torch pinned (closes the ML-DOMAIN gap)
    The 60 tests that need PyTorch (9 hep-ml modules, ML-DOMAIN's among them) ran
    only in the optional, continue-on-error torch-cpu job. New required job
    torch-backend: the CI lock plus torch 2.14.1 and torchvision 0.29.1 (CPU
    wheels; what the unpinned job resolved and E2 runs), the 9 modules through
    run_required_backends.py --require torch==2.14.1,torchvision==0.29.1, so a
    test skipped for PyTorch fails the job. The unpinned torch-cpu job stays as an
    early warning for new PyTorch releases (bump the pins when it passes).
    run_required_backends.py --allow-skip-reason TEXT: a skip meant for the
    backe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
2026-10-20 fix: run_required_backends matches a version without a local label as PEP 440 does (torch 2.14.1+cpu)
    The torch-backend job's first CI run passed every test (211 run, 0 failures,
    the 2 allowed skips) but failed the version check: the CPU wheels report
    2.14.1+cpu and 0.29.1+cpu, and the tool compared versions as exact strings.
    A requirement without a local label now ignores the installed version's label
    ('2.14.1' matches '2.14.1+cpu'), as PEP 440 version matching does; one with a
    label must match exactly. E2's torch reports a plain 2.14.1, so the local run
    did not show it. Tested in tests/tools/test_run_required_backends.py.
2026-10-20 docs: sci-fix advisories for the 26 older ledger entries whose defect shipped (SFA-2026-004..035)
    Backfill of plan PR-7's advisories. For each older ledger entry: the fix
    commit and its first release (the first tag holding it; 0.4.0, untagged and
    without a manifest, recorded with a fixed_basis), the first release that held
    the defect (the introducing commit where found, else the file's first
    release, with an introduced_basis), the affected files, the scientific impact
    from the commit messages, CHANGELOG and VALIDATION, applies_to and a remedy.
    Skipped with reasons: ROBUST-MALFORMED (S4: crashes became findings, no
    number was wrong), CLS-LOGINTERP (the defect was in an example benchmark
    scri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
2026-10-20 chore: release 0.18.0 (versions, contracts 3.0.1, changelog, regenerated examples and profile artifacts)
    Contracts 3.0.1 (patch): the validator's sample-name comparison drops '.'
    segments anywhere (sci-fix SAMPLE-NAME-DOT-SEGMENTS). CONTRACTS_VERSION and
    its history line, vocab/core.json, the two pinned tests, the 131 fixtures
    (make_fixtures.py regenerates them identically), the three assets and the
    theory-profile scripts. CHANGELOG Unreleased -> 0.18.0 with an intro;
    SFA-2026-001..003 gain their fixed: 0.18.0 event. Examples regenerated with
    E2 (bc-propagation-fit with the CI lock): only version strings and the hashes
    covering them change; unfolding-coverage drifted at 1e-14 and was left as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
2026-10-20 docs: sci-fix ledger reviewed under the maintainer's oracle-independence rule
    Maintainer decisions (2026-10-20/21, docs/maintenance.md): an AI-written
    oracle counts as an independent kind only with a basis, a located source
    (equation, table or page, read and recorded), a third-party implementation's
    own algorithm, an exhaustive domain, or a person's check; kind definitions;
    adapted parent runs count when they only add imported modules or guard an
    import. Every counted kind is now an independence record in
    docs/evidence/sci-fixes.json (27 third-party, 14 locator, 8 exhaustive),
    enforced by tests/tools/test_scifix_ledger.py.
    Locators read 2026-10-21, never from memory: PDG RPP 2024 Passage of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
2026-10-20 chore: release 0.18.1 (versions, changelog, regenerated examples and profile artifacts)
    Patch release: the sci-fix ledger review (#181) and the corrected
    Feldman-Cousins citation. Contracts unchanged (3.0.1). Version 0.18.1 in both
    manifests, pyproject.toml, the README, two assets and the theory-profile
    scripts; CHANGELOG Unreleased -> 0.18.1. Examples regenerated with E2
    (bc-propagation-fit with the CI lock): only version strings and their hashes
    change; unfolding-coverage drifted at 1e-14 and was left as committed; the
    sbottom benchmark's plugin string edited by hand. VALIDATION "0.18.1 release
    check".
2026-10-21 feat(geant4): Geant4 execution adapter, study protocol and benchmarks, journey J14
    Epic TASK-geant4-00 to 03, phase 1 (contracts unchanged, no SKILL.md or
    description change).
    - adapters/geant4 (owner hep-detector): pinned source build with dataset
    MD5 and content hashes; official examples B1/B4a/TestEm3/TestEm5 compared
    with their reference outputs by the meaning of each printed quantity;
    layered_sim C++ program with per-event CSV; run records with a simulation
    block and resolved data paths; scan, partition chunks, reduce, oracle;
    overlap, material-budget, energy-balance and mirror checks.
    - hep-detector: geant4-study-protocol.md, sourced physics rule table,
    check_geant4_study.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
2026-10-21 feat(contracts 3.1.0): Geant4 phase 2, study records re-issued as validated-in-scope
    - contracts 3.1.0: extension.evidence_records (run records by path and
    sha256, labels not inherited) with capability core:evidence-records,
    resolved by dependencies.py (evidence.*); rule family geant4.upgrade_*
    for computational-runs with Geant4 study material that carry
    validated-in-scope (other computational-runs unaffected).
    - Shared stanza point 5: the one exception for such a study record; all
    SKILL.md regenerated; two entry references trimmed for the budget.
    - check_geant4_study.py label --upgrade; build_response.py --input-record
    and --also-status.
    - J14: both studies re-issued for their b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
2026-10-21 fix(geant4,routing): pin geant4.def base image; derive journey coverage from the journey table
    - adapters/geant4/assets/geant4.def: replace the digest placeholder with the ubuntu:24.04
    multi-arch index digest (sha256:68ee2200..., read from registry-1.docker.io 2026-10-21).
    The definition is still not built or tested (no container runtime on E2).
    - tools/check_routing_static.py: the journey coverage check was hard-coded to J1-J12, so a
    missing J13/J14 case went unnoticed; it now reads the journey IDs from the table in
    docs/researcher-journeys.md (J1-J14 today).
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2026-10-21 chore: release 0.21.0 (contracts 3.2.0; versions, changelog, regenerated examples and profile artifacts)
    Minor release: #188-#192 (simulated dataset status, contracts 3.2.0; Gluckstern few-layer
    warning; FoCal-E longitudinal-profile reference benchmark and mixture materials; CI speedup).
    Version 0.21.0 in both manifests, pyproject.toml, the README, two assets and the
    theory-profile scripts; CHANGELOG Unreleased -> 0.21.0 (with the #188 entry). Examples
    regenerated with E2 (bc-propagation-fit with the CI lock): only version strings and their
    hashes change; unfolding-coverage drift left as committed; the sbottom benchmark's plugin
    string edited by hand. VALIDATION "0.21.0 release check".
    Co-A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
2026-10-21 feat(review): independent review contract, schemas and process driver (P1 core)
    contracts/review.py holds the seven review schemas' Python rules, the shared state
    table, decide and check; skills/hep-authoring/scripts/review.py drives a review
    (start, next, dispatch, returned, receive, withdraw, dispose, arbitrate, rereview,
    escalate, report, close, resolve, repair) with units, canaries, packets, the
    instruction generator, observe, receipt and the report in review_lib/.
2026-10-21 fix(review): code-review follow-ups and gate fixes
    - CRLF documents: text and hashes come from the same bytes (no newline translation).
    - A second escalation of the same item is pending again (human resolutions are bound to the escalation).
    - A removed-pending finding disposed as changed no longer triggers change_without_edit.
    - The event log refuses a malformed event or a time earlier than its last event.
    - check accepts a relative review path; carry-forward finds each finding's lens in its own round;
    a shadow takes the canaries of the attempt its lens will run.
    - Reference: Done-when line, no backticked non-reference .md names; reference inventory regenerated;
    subprocess timeouts in te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
2026-10-21 fix(review): bind the master seed to the review id
    One --seed reused for several reviews (found in the P3 pilot setup) gave them identical nonces, slot
    labels and samples. The master seed is now derived from the given seed and the review id; a
    regression test dispatches two documents with one seed.
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2026-10-21 fix(review): the three must-fix items from the P3 stage-1 pilot
    - Copies of the document: receipt rejects a record citing a file that holds at least half of the
    document's longer units (read_outside_packet, with the reason); start warns about such files in
    the plugin and the project; the instructions forbid reading any copy or version, git history and
    plugin caches included.
    - Design canaries: two new types under the design witness rule, a repeated value made inconsistent
    and a repeated back-quoted name misspelt once; they fire on all five pilot documents.
    - No empty slots: a lens with no unit in scope gets no slot, a shadow only when its lens has canaries
    or decoy candidates (star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
2026-10-21 sci-fix: inference.py states what scored ids missing from the split manifest mean (S3)
    leakage_check counted scored ids the manifest does not list (ids_not_in_manifest); the only report was
    "their train/test role is unknown", and a refusal for scored training ids carried no warning at all. They are still
    not refused (scoring real data or other samples is legitimate), but the warning now says N scored events are not in
    the split manifest, so the check cannot exclude that the model was trained on them, and that the manifest is
    incomplete if they are simulated events from the training sample; the refusal output carries it too. The
    leakage_check docstring, the module docstring and multivariate-a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
2026-10-21 sci-fix: anisotropy.py weighted harmonic uses the exact null covariance of (a, b) (S1)
    With an exposure map the weighted first harmonic used exp(-N_eff r^2 / 4) and a Rice
    width 2/N_eff per component. A non-uniform exposure makes Var(a) and Var(b) unequal and
    correlated, so a dipole along the less exposed axis had its significance overstated and
    its Neyman upper limit too tight (1 + 0.9 cos alpha: N Var(a) = 6.39 against 4.59).
    - harmonic_covariance(edges, rel, n): the null covariance from the binned map, closed-form
    integrals per bin; exactly (2/n) I for a uniform map; a map with an empty bin is rejected.
    - first_harmonic: rayleigh_probability = exp(-chi^2 / 2), chi^2 = v^T V^-1 v; repor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
2026-10-21 robust-fix: anisotropy.py rejects --cl below 0.5 with its reason instead of a TypeError (ANISO-CL-RANGE)
    harmonic --cl 0.3 (with or without --exposure-map) ended in a TypeError reported
    as rejected: below CL 0.5 the expected limit (the Neyman limit at the median
    isotropic amplitude) is empty and max(None, ...) / None > float failed in
    amplitude_upper_limit. Maintainer decision: an upper limit below CL 0.5 is not
    supported (the power constraint is undefined).
    - CLI: --cl outside [0.5, 1) is rejected with that reason (status rejected,
    exit 2); --spurious-alpha keeps its own (0, 1) check.
    - amplitude_upper_limit raises ValueError with the same reason for cl outside
    [0.5, 1) (NaN included;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
2026-10-21 ci: required bdt-backend job runs the xgboost and scikit-learn tests with the bdt extra pinned
    The train_bdt.py, export_bdt.py and analysis-to-paper BDT tests skipped in every
    required job (none installs the bdt extra). New required job bdt-backend,
    modelled on torch-backend: the CI lock plus xgboost 3.4.1, scikit-learn 1.9.1
    and scikit-learn's joblib 1.6.0, narwhals 2.27.1, threadpoolctl 3.7.0 (the CI
    lock venv's versions), and run_required_backends.py --require
    xgboost==3.4.1,sklearn==1.9.1 over tests.examples.test_analysis_to_paper,
    tests.skills.hep_ml.test_train_bdt and test_train_bdt_extensions, so a test
    skipped for either backend fails the job.
    The gate matches skip reasons by import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
2026-10-21 fix: packaging scan reads every text file, detected by content (T27)
    check_packaging.py applied its content rules (private paths, credentials, restricted-site facts,
    legacy traces, e-mail) only to files whose suffix was in TEXT, so shipped .hh headers, .def, .out,
    .patch, the Snakefile, suffix-less batch shims, LICENSE and .gitignore were not scanned. A file is
    now scanned when its suffix is a known text format or its first 8 KiB hold no NUL byte. The 119
    newly scanned files of the current tree raise no finding.
2026-10-21 fix: batch-config site-fact check walks the JSON and ignores key case (T29)
    batch_site_facts() looked only at the top level and a direct slurm/htcondor block, with case-sensitive
    keys, so {"backend": "slurm", "Partition": "gpu-real"}, {"sites": [{"backend": "slurm", "account": ...}]}
    and keys nested inside a slurm block passed. It now walks the JSON recursively: an object with a
    slurm or htcondor backend or section opens a batch scope over everything below it, and keys and the
    backend value are compared case-insensitively. The documented "synthetic" prefix stays accepted.
2026-10-21 fix: packaging scan exempts placeholder e-mail addresses only at reserved domains (T30)
    The exemption for placeholder local parts (author, user, you, ...) applied at any domain, so a
    real-looking address such as author@cern.ch was not reported. An address is now exempt only at a
    reserved domain (RFC 2606 / RFC 6761: example.com/.org/.net and subdomains, *.example, *.invalid,
    *.test, *.localhost) or as the commit trailer address. The tightened rule found one shipped address,
    \emailAdd{author@inst.edu} in the hep-authoring LaTeX venue template; it is now author@example.org
    (reference inventory regenerated for the 3-byte change).
2026-10-21 sci-fix: adapters report a missing optional dependency as missing-dependency, exit 3; pyhf model checks report unreadable input as rejected (T19, T18)
    T19. The hep-computing script contract gives a missing dependency exit 3
    with a JSON status. Adapters instead exited 2 with status "refused" or
    "failed" (pyhf-combine: backend_comparison, model_card,
    reproduce_published_likelihood, pyhf_nuisance_diagnostics), 2 with text
    only (coffea_dijet_processor, root_to_parquet), 1 with text only
    (uproot_awkward_analysis, pyroot_rdf_cutflow_analysis,
    pyroot_roofit_signal_background), 1 with "failed" (hepdata_export without
    hepdata_lib, now checked before the input is read) or a traceback
    (hepdata_record o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
2026-10-21 sci-fix: estimate_training_memory.py exits 1 with status failed when the estimate does not fit, and states the micro-batch size and sequence length (T33, T34)
    T33. A configuration that does not fit printed "Does not fit" (fits false)
    and exited 0; the hep-computing script contract gives a negative verdict
    exit 1 and asks for a JSON status. It now exits 1 when the estimate does
    not fit and 0 when it fits, and --json carries "status" ok or failed (bad
    input with --json: status rejected, exit 2 as before). The text-report
    test that ran a 7e9-parameter model on 80 GB GPUs without ZeRO (104 GiB per
    GPU) pinned exit 0 and now expects 1.
    T34. The report and the JSON now give the micro-batch size a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
2026-10-21 robust-fix: run_all_checks.py writes its summary when git is missing or hangs (T21)
    The summary's git rev-parse call had a timeout but no handler: a missing
    git binary (FileNotFoundError) or a hang (TimeoutExpired) ended the run
    with a traceback after all checks had run, and no summary was written.
    git_commit() now returns "unknown" on OSError or SubprocessError, as it
    already did for an empty answer. Test: tests/tools/test_run_all_checks_git.py.
2026-10-21 robust-fix: core/status.exit_code on an unknown status names it and gives exit 3, not a KeyError traceback with exit 1 (T16)
    exit_code() raised KeyError on a status outside RUN_STATUSES; uncaught,
    Python exits 1, the code of a negative verdict, with a traceback and no
    JSON. An unknown status is a programming error in the calling script and
    the run's outcome cannot be classified, so it is now reported on stderr
    (the status and the known ones) and maps to exit 3, incomplete: never 1
    (a verdict), 0 (ok) or 2 (the user's input). artifact_labels() refuses an
    unknown status with ValueError, so no artifact is labelled from it. A scan
    of the status literals of the scripts that call exit_code() with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
2026-10-21 fix: validate artifacts_dir JSON files whatever the suffix case (triage T09)
    validate_directory compared f.suffix with '.json', so bad.JSON was only an artifacts_dir.non_json warning and an
    invalid artifact under that name passed the directory check. The suffix is now compared case-insensitively: such a
    file is validated as an artifact, or is artifacts_dir.not_artifact like any other JSON file. An error, as the
    docstring already promised for every JSON file; a valid artifact named *.JSON still passes.
2026-10-21 fix: warn on an unknown skill name in an extension handoff (triage T15)
    An unknown, not retired, skill name under an extension 'handoff' key passed in every artifact type except an
    ml-artifact under the 2.8.0 ml rules. skill_names.check_artifact now reports it as the warning skill.unknown_handoff;
    validate_artifact drops that warning where ml.handoff_unknown already reports the name. A retired name stays the
    error skill.unknown_name. A warning because artifacts that passed before must keep their outcome without a
    contracts major; the docstrings of skill_names.py and validate.py now say exactly what is an error.
2026-10-21 fix: warn when an unfolded observable does not name its target level (triage T36)
    The levels vocabulary says the target of 'unfolded' must be declared separately, but nothing checked it. Contracts
    3.3.0 has no field for it, so without a new field the target is named in phase_space.definition (any level term other
    than unfolded and detector, core or profile; case and separators ignored). An observable at level 'unfolded' that
    names none gets the warning observable.unfolded_target_undeclared. Vocabulary.terms() lists core and profile terms.
    A structured observable.target_level would be a contracts minor; not added here.
2026-10-21 fix: a failed revocation status has no readable events (triage T26)
    RevocationStatus exposed events = [] as a public field when verification failed, so code reading .events directly saw
    'nothing revoked'. The events are now stored privately and read through a property that raises RevocationUnverified
    when ok is False, like revoked(), revoked_digests() and status_doc(). Current readers check ok first and are
    unchanged.
2026-10-21 docs(evidence): records for plugin triage batches A-C (T01-T36) and inventory refresh
    Ledger fixes CLI-MISSING-INPUT-EXIT2, ADAPTER-MISSING-DEPENDENCY, PYHF-REJECTED-STATUS, TRAINING-MEMORY-VERDICT (S2),
    STATUS-UNKNOWN-EXIT, RUN-ALL-CHECKS-GIT (S4) and documentation fix STATUS-REFUSED-MEANING; VALIDATION TRIAGE-A, -B,
    -C; CHANGELOG Unreleased bullets; reference inventory regenerated after the merged branches.
2026-10-21 sci-fix: correct five more references after the review tuning run (S3, 27 issues)
    correction-chain (chained factors need no independence; acceptance holds the simulated selection), front-end (fake
    hits use nu, AC-coupling recovery), time-series (periodicity_scan.py and its null; model-built covariance not
    equivalent), particle-identification (TOF convention, TR onsets, RICH threshold, scope), nuisance-modeling (Combine
    impacts and autoMCStats pointers, test scope, penalty wording). Ledger documentation_fixes REVIEW-REFS-2, VALIDATION
    REVIEW-REFS-2, CHANGELOG Unreleased, reference inventory regenerated.
2026-10-21 feat(review): per-lens model choice (lens_models, start --lens-model)
    - review_config gains the optional lens_models (lens -> model): the model of that lens's lens slot in
    every round, re-review rounds included. Its shadow keeps the rotation and moves to the next model
    when the rotation would give it the lens slot's fixed model (spec A2 independence). A model outside
    models, or a key that is not a lens name, is config_out_of_range; start refuses an unknown lens.
    - start --lens-model LENS=MODEL (repeatable) writes it to reviews/review-config.json; start refuses
    to change a configuration that another unfinished review uses (it would see config_changed).
    - Without lens_models the slot a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
2026-10-21 chore: contracts 3.4.0 (review filter record, lens_models and filter config fields)
    - CONTRACTS_VERSION 3.4.0 with its comment block (additive sidecar format and optional config
    fields; no capability), contracts/vocab/core.json, the two pinned tests.
    - Fixtures rewritten by tests/contracts/make_fixtures.py (E2 venv): version strings only; the review
    filter fixtures are unchanged.
    - Templates and assets (measurement_spec, reading-notes, response example), the theory-profile
    scripts and their regenerated artifacts.
    - Examples regenerated with the E2 venv (bc-propagation-fit with the CI lock venv): version strings
    and the hashes that cover them only; unfolding-coverage drifted at 1e-14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
2026-10-22 fix: warn when the same efficiency is counted twice under a namespace
    A measurement spec listing a bare `efficiency` next to `<ns>:efficiency` (or two
    namespaced `efficiency` terms) passed with no finding: the bare-efficiency error
    needs a `_efficiency` suffix and the repeated-category error keeps the namespace.
    It now gets the warning measurement.efficiency_counted_twice_namespaced; the
    existing errors are unchanged, so no artifact changes outcome (no contracts
    major). All 360 shipped artifacts keep identical findings, plain and strict.
    correction-chain.md describes what is and is not caught; reference inventory,
    fixtures and verdict snapshot regenerated.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
2026-10-22 sci-fix: correct five references after the first live review with the 0.23.0 options (S3, 42 issues)
    space-based-direct-detection (cutoff over the acceptance cone, Garwood 68.27%, penumbra, charge sign, profile claims),
    calibration-and-alignment (x_m notation, warning threshold, citation scopes), triggers-luminosity-pileup (Lendermann and
    ATLAS locators, script scopes, n1 n2, prescale divisors), statistical-inference-for-physics (correlation sign: substantive),
    analysis-design (era checks, residual.py scope, Z_A regime, pointers). geomagnetic_cutoff.py docstring penumbra wording;
    independent-review.md recommends --filter-model with the live-run numbers. Ledger REVIEW-REFS-3, VALIDATION, CHAN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
2026-10-22 fix(identity): an installed copy keeps its release identity despite the root .in_use/ folder
    Sci-fix improvement plan v3, PR-1 (A2; F-03, F-25). The plugin system writes .in_use/<pid>
    into the root of an installed copy; the identity counted it as an added file, so
    plugin_release() was "unreleased" on every installed copy and the protected guard refused
    every qualification. RUNTIME_ROOT_DIRS = {".in_use"} is excluded at the plugin root only
    (git and walk paths); any other added file still changes the identity. verify() warns
    (identity.bytecode_unverified) when .pyc files are present; the guard docstring states the
    bytecode limit.
2026-10-22 feat(scifix): advisory check rejects non-discriminating keys and broken ranges; structured ledger changelog
    Sci-fix improvement plan v3, PR-2 (A0, A3, C5, F-23).
    - check: extension keys must discriminate (at least one key, none required by a listed
    type's extension schema); the eleven older offenders are frozen in
    NONDISCRIMINATING_ALLOWED until the /2 migration, none added. Advisories whose code
    writes no artifact carry database_specific.no_artifact and outputs (SFA-2026-014 to
    -019, -036, -037).
    - check: X.Y.Z versions (a malformed one is a problem, not a ValueError), no two events
    at one version, fixed/last_affected above its introduced, artifact types from the
    envelope vocab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
2026-10-22 feat(contracts): 3.5.0 envelope execution trace (provenance.code_paths, code_tags)
    Sci-fix improvement plan v3, A1 change 2 (maintainer decision 2026-10-22: revises "no
    provenance.producer field"). core/trace.py (steward hep-computing; contracts/trace.py
    re-exports it, so shared core functions can call tag()) snapshots the plugin .py files in
    sys.modules when an envelope is written (tests/ left out) and the tags advisory-named
    shared functions set with tag(); tags are cleared per envelope. Twelve producers add
    **trace.provenance() to provenance (dragon2_run.py, dragon2_to_prediction.py and
    geant4_build.py import no contracts and are unchanged; examples and profile scripts too).
    - Envelope s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
2026-10-22 docs(scifix): execution trace policy, ledger entry SCAN-MISSING-MARKER, CHANGELOG and VALIDATION
    docs/maintenance.md records the maintainer decision of 2026-10-22 that revises the
    "no provenance.producer field" rule, and states what the trace cannot show (code run
    in another process). VALIDATION SCIFIX-PLAN-A1-TRACE: parent record of the A4 fix and
    the trace and contracts checks.
2026-10-22 sci-fix: advisories format /2 match what an artifact can show; possibly affected (no trace) when it cannot (S2)
    Sci-fix improvement plan v3, PR-5 (A1 change 1). Format /1 matched an artifact on its
    type and the presence of extension keys; eleven advisories keyed on fields every artifact
    of the type carries, so their "affected" verdicts decided nothing.
    Format /2: applies_to.match is OR over groups, AND within a group, of conditions
    {path ('.'-joined, [*] expands lists), op exists|eq|in|regex, value(s), unknown_before}.
    A condition is undecided when the artifact cannot show it (no trace field: written before
    contracts 3.5.0; a contract_version below unknown_before); match [] (with match_basi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
2026-10-22 feat(scifix): located sources in the evidence ledger format and ledger-driven evidence runs (plan B1, B4)
    Sci-fix improvement plan v3, PR-6 (F-10, F-12).
    - B1: the "Sources read for locators" table becomes docs/evidence/scifix-sources.json
    (scifix:S01-S11) and scifix-claims.json (scifix:C01-C27, one per locator), validated by
    core/evidence/ledger.py and rendered into scifix-index.md. Each of the 15 locator records
    in sci-fixes.json names source_id and locator_id; the source must be read at page or
    full-text. arXiv:2109.07851v2 (ML-NEGWEIGHTS) read 2026-10-22 at page level: eq. (2.2)
    is in Sec. 2, p. 3, not Sec. 2.2; ledger detail and hep_metrics.cell_resample docstring
    corrected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
2026-10-22 docs(dev): second deep check of the Geant4 proposal against main 9f08796
    Delta review against 0.22.0, 0.23.0 and unreleased changes, and a phase-1
    prototype in an isolated worktree (its code and test diff kept as
    prototype/phase1-core.patch). Both language versions updated: contract
    versions written as C1/C2; isolation rule moved to phase 1 with declared
    target_slabs and a dependencies.py re-derivation; longitudinal-profile
    kind shower-maximum and target-hash match; sci-fix split (S1 for the MPV
    estimator) with discriminating advisory keys; seeds against the partition
    engine and cmd_chunk; incomplete (exit 3) for unresolved gates; geometry
    accessor in core; execution trace; new defect D10 (t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
2026-10-22 docs(dev): J15 TOF stations with two layers each
    TOF1 and TOF2 become two 10 mm layers of the same material
    (G4_PLASTIC_SC_VINYLTOLUENE), 10 mm apart, station centres unchanged
    (D = 1.300 m). Recomputed with j15_design_estimates.py: sigma_beta/beta
    2.3 % at 100 ps per layer, TOF1 energy loss and beta drift, material in
    front of the calorimeter 11.32 % X0, TOF2 acceptance, field-check grid.
    New verification tof-layer-consistency. Both language versions.
    Claude-Session: https://claude.ai/code/session_01TeU52XB1ocE9H1EEzGTbug
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2026-10-22 feat(scifix): structured D axis under the D-scope rule, and ML-SMALL split (plan B3, B6)
    Sci-fix improvement plan v3, PR-7 parts B3 and B6 (F-11, F-14, F-23); maintainer
    decisions of 2026-10-22.
    - B3: every ledger entry records commits (parent, fix, follow_up; 40-hex, resolved
    with git rev-parse), parent_records (133: 87 transcribed from VALIDATION, 46 from
    reruns in detached worktrees of the parent and fix commits) with requires, and
    mutants (46, transcribed); evidence_tests lists the test nodes used.
    - D-scope rule in docs/maintenance.md: D2 needs a parent failure of every oracle
    node named by the independence records (at most D1 otherwise); D3 also a killed
    revert mutant. test_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
2026-10-22 feat(scifix): ledger report with the transcription rule, structured S3 sources and per-entry sign-off
    Sci-fix improvement plan v3, rest of PR-7 (B2 report only, B5, B7; F-08, F-15, F-16).
    tools/scifix_ledger.py report lists entries below their minimum, C3 entries whose
    oracles all compute from a transcribed formula (expected_from on every independence
    record; DR-WP1-01, DR-WP1-02, DR-WP2-06-CALO, DR-WP2-06-MS, each with a gaps line),
    S1 entries without review {by, date, scope}, and S3 entries below their minimum
    (documentation_fixes now list sources). Rules in docs/maintenance.md (maintainer
    decisions 2026-10-22).
2026-10-22 chore: contracts 3.6.0 (review expert slot: config field expert, record role expert)
    - CONTRACTS_VERSION 3.6.0 with its comment block (the optional review_config field expert, the
    review_record role expert with the reason code finding_without_verdict, the optional round_started
    key expert; no capability: review files live under <project>/reviews/, never in an artifacts_dir),
    contracts/vocab/core.json, the two pinned tests.
    - Fixtures rewritten by tests/contracts/make_fixtures.py (E2 venv): version strings only.
    - Examples regenerated with the E2 venv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
2026-10-22 feat(scifix): OSV timestamps, advisory waivers and regression links; numbering gaps explained
    Sci-fix improvement plan v3, PR-8 parts C1 and C2 (F-13, F-17, F-18).
    - Advisories carry OSV published (first commit, UTC) and modified; check requires both,
    modified not before published.
    - check warns (never fails) when an advisory's introduced_commit is another advisory's
    fixed_commit, until a ledger entry it names records that entry in regression_of:
    CANONICAL-KEY-ZERO-FRACTION regression_of ML-SPLITS, SAMPLE-NAME-DOT-SEGMENTS
    regression_of ML-CALIBRATION.
    - Every S1/S2 entry is named by an advisory or carries advisory_waiver {reason, decided}:
    CLS-LOGINTERP, the three triage S2 entri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
2026-10-22 feat(scifix): JSON schemas of the ledger and the advisories; CHANGELOG and VALIDATION for C1, C2, C6
    Sci-fix improvement plan v3, C6 (F-22): docs/evidence/schemas/ with the keywords
    contracts/schema.py implements and no $ref; test_scifix_schemas.py validates the
    ledger and every advisory and refuses broken copies.
2026-10-22 feat(review): expert slot in round 1, per-review configuration, identity scrub of the filter packet
    - start --expert-model M (config expert, contracts 3.6.0): one round-1 slot, labelled from the same
    shuffle as the others and dispatched with them, reads the whole document for substantive physics,
    statistics and method errors only. Packet: document without canaries, units without lens scope,
    scope {slot_id, lens null, role expert, max_units_per_claim}; generated instructions with a
    validated example. Record review_record.json with role expert (claims, verdicts, findings; no skim,
    carry_forward or resolves). Receipt (spec 7.6): the reviewer rules minus coverage, canaries and
    re-rev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
2026-10-22 docs(refs): fix 54 adjudicated issues from review batch 1 and the expert-slot tests (REVIEW-REFS-4)
    Fifteen references: track-fit chi^2 covariance, biased-residual correlation sign,
    QGSP_BIC/FTFP_BERT overlap ranges, Geant4 gate and scope-check claims, era-mixing
    exactness, one-sided p-values, Chernoff/Davies condition, Braun et al. background,
    and 13 earlier expert-slot findings. Rule concern strings G4R-BIC-RANGE and
    G4R-HP-NEUTRON, reference inventory. independent-review.md now recommends
    --expert-model with the strongest model alongside the lens slots, and an Opus filter.
2026-10-22 chore: release 0.24.0 (contracts 3.6.0; versions, changelog, ledger releases, advisory SFA-2026-038 fixed event, regenerated examples and profile artifacts)
2026-10-22 ci(statistics-validation): weekly ledger-evidence job; TH9-MASSES PDG oracle run on its parent and fix
    The new job runs every oracle node of the sci-fix ledger with pyhf, ArviZ and pdg and
    no skip allowed (run_required_backends.py --from-ledger --no-skips): 56 of 56 pass
    locally. TH9-MASSES's PDG cross-check passes on parent 84c0a68c and fix 23910085 (it
    checks core/constants, unchanged by the fix): the record goes from skip to pass, the
    entry stays D1.
2026-10-22 feat(trace): core/stats CLIs print their execution trace; result_artifact.py joins it
    The statistical-result writer wraps the JSON a core/stats CLI printed in another
    process, so its own trace never showed which core/stats code produced the numbers
    (the limit found in the sci-fix improvement plan PR-4). The seven core/stats CLIs now
    add trace {code_paths, code_tags} (core/trace.py) to their result output, and
    result_artifact.py joins it to provenance, dropping entries that are not plugin-
    relative .py paths or tags. docs/maintenance.md states it.
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2026-10-22 docs(geant4-architecture): generality assessment of the revised architecture
    Tests the run-summary architecture against five kinds of use case and
    finds ten places that would lock generality in (geometry source, scope
    dimensions, field in the isolation rule, weights, 1D observables, SE
    method for rare counts, sources, engine-specific config, one-level
    derived marker, fixed K). Tier 1 fixes eight cheaply now; tier 2
    defines interfaces for profiles, sources and a reducer; tier 3 defers
    with triggers; lists generalizations deliberately not made.
    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
2026-10-22 docs(geant4-architecture): consolidated architecture proposal
    Merges the soundness re-evaluation (P1-P7) and generality assessment
    (G1-G10) into one self-contained architecture: a C++ data plane and a
    Python control plane with three boundary artifacts (weighted int128
    run summary, column map, engine-independent effective config with the
    actual geometry tree); batch means with exact small-count intervals;
    contracts with per-benchmark scope dimensions and a target-based
    isolation rule; stages A1, A2a, A2b, B0, B1; a decision record of what
    the user decided, what needs confirmation and what the maintainer
    decides. Resolves two gaps of the drafts: spec-derived configuration
    stays valid for layer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
2026-10-22 refactor(analysis-check): rename code-name identifiers (WP-R, DR-15) and Phase 0 records
    Applied with tools/rename_analysis_check_ids.py (--apply --date 2026-10-22, then
    --verify: no leftovers, 169 registry test IDs resolve, derived files current;
    a second --apply changes nothing):
    - docs/dev/v6.3/ -> docs/dev/cross-artifact-check/ (git mv, content unchanged;
    forwarding README at the old path)
    - tests/contracts/test_v63_* -> test_analysis_check_*, v63_cases/v63_runs ->
    analysis_check_cases/analysis_check_runs, tests/core/test_v63_evidence_query
    -> test_evidence_query; registry test IDs and module timings rewritten
    - reference inventory regenerated (R-7)
    Also: README and preservation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
2026-10-22 feat(analysis-check): check-context 1.1.0 input checks (G12, G15, G16, G22; G2 by format)
    Input checks enabled only for 1.1.0 contexts (P3; 403 Phase 0 obligations unchanged): calibration.shape
    (factor tables, tolerance), coverage.duplicate_contract, context.shared_within_model,
    context.unit_placeholder; freeze refuses (bundle.item_schema / bundle.context_input), check reports
    input-invalid. Probes G2, G12, G15, G16, G22 flipped to 1.1.0 contexts and passing; V78, V80, V81, V89
    and the G16 part of V79 passing (V79 split: G4/DR-6 part not-run). context_1_1 helper moved to the
    case builders. Dated section in m2a-design.md; CHANGELOG.
2026-10-22 docs(geant4): rewrite task specs from the redesigned architecture
    Task A: A1 (contracts C1, block batch means, Python summary producer,
    offline J14 recomputation) and A2 (g4common, per-event seeding, three
    boundary artifacts). Task B: B1 (element_sim, field, plane crossings,
    ROOT event files, simroot) and B2 (simreco, J15 study, C2 classes and
    transitive processing chains). README updated for the new stages.
    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
2026-10-22 docs(geant4): fix task specs after independent review
    Gate operating characteristics recomputed (the two-stage model
    double-counted the trial chi2); pass needs both points on target;
    tolerance_mode; grade is class; top-level observables with selection;
    seed hash byte definition and job seeds; caught definition; reseed in
    GeneratePrimaries; probe draws no random numbers; SimHash.hh and
    MiniJson.hh in the shared g4sim directory. Task B: B1.6 limited to
    shared observables, calorimeter leakage columns, new benchmark rows,
    surrogate and regression rules, total-momentum rigidity, CLI and
    SIM_SOURCES changes, portable digitization RNG, explicit stepper.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
2026-10-22 feat(analysis-check): R2 rule fixes G4 (tolerance from declared significant digits) and G5 (observation identity)
    - r-comp.factor_values 1.1.0 (G4, DR-6, V79 part 2): the table's own tolerance is not used; 1e-9 by default, or
    sum|power| * 0.5 * 10**(1-d) for declared significant_digits d that every value honours (parent counts 1); a
    declaration the values contradict falls back to the default; outcomes report the tolerance and its basis;
    calibration.shape (1.1.0) checks significant_digits is an integer 1..17
    - r-aux.use 1.1.0 (G5, DR-3, V85): an observation is its source identity (an envelope's artifact_id, else the
    item's frozen canonical digest) plus pointer, so a copied file under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
2026-10-22 docs(geant4): re-plan tasks A, B, C (WIP: English specs pending)
    Add plan.md and plan.en.md (evaluation, principles, eight stages,
    interface ownership, CV1-CV3 naming, gates, merged open decisions).
    Rewrite the Chinese task specs: A1 back to a minimal sci-fix, B split
    into B1-B3, C into C1-C3 with C2 adding its own core/ interfaces.
    Architecture section 10 now points to the plan; README rewritten.
    English task specs follow in the next commit.
    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
2026-10-23 feat(analysis-check): R3 slice B - stable 1.1.0 suites, full mutation testing, report-check reason consistency
    - suites counting-chain, ratio-subset, model-card, run-lineage 1.1.0 (content of 1.1.0-dev.5), the default from R3;
    check-report accepts them and refuses pre-releases; the context conversion lands on 1.1.0
    - report and permit tests use the real 1.1.0 checker instead of the R1 rules double
    - full mutation testing (V76): relabel, copy, copy+perturb, toggle-optional and edit-report join reorder, rename,
    drop and loosen; all draft operators keep their invariants on the chain (1.0.0 and 1.1.0), reduced, ratio and
    model cases
    - edit-report found permit.report_check accepting hand-ed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
2026-10-23 docs(geant4): apply detailed-check fixes across all five parts
    Plan: worktree-geant4-<stage> branches with an ancestor check; spec
    corrections before approval go in the docs worktree; check-spec moves to
    C2.9; regression/confirmation roles, tree-v1, per-event seeding and the
    probe in the ownership table; G-B1b/G-C1 say do not merge; consolidated
    section notation.
    Task A: validate_spec/schema/Spec.cc gain the new run and output keys;
    named seed storage fields; selections match current code; per-observable
    tolerance; scope hash fields; DL definitions; Geant4 seeding and
    float.hex details; factual line and size corrections; ledger D7/D8/D10.
    Task B: same-platform bit identity only (<=1e-12 ac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
2026-10-23 eval(value-gate): re-measure on 0.26.0 (1.1.0 suites): I = 0 of 28, F = 1 mechanical (R04, as Phase 1)
    - measure.py: opt-in --suite-version (contexts converted as migrate.py does) and --rebase-from (the 0.26.0
    example change inserted into each case's run.py; all 39 cases keep exactly their planted change); with
    --rebase-from, contexts also map the four corrections the 0.26.0 spec added; Phase 1 defaults unchanged
    - results-0.26.0/: the run (paths made relative)
    - decision-value-gate.md: dated measurement section; only change against Phase 1 is E22 (the P4 narrowing), now
    also flagged by r-real.undescribed but already caught by layer 1; no decision recorded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
2026-10-23 feat(analysis-check): shrink after the value gate - deprecate model-card and run-lineage
    The 0.26.0 re-measurement found I = 0 of 28 again; the maintainer chose the architecture's Shrink (section 13.3)
    on the implementer's recommendation:
    - keep counting-chain (frozen: no new rules) and ratio-subset; custody.py stays (section 13.4 assurance-plane
    exemption; the 13.3/13.4 conflict is recorded)
    - model-card and run-lineage (with --mode model, --results and the result binding) deprecated now, removed in the
    next minor release (section 13.4)
    - registry: their 9 live rule versions marked deprecated; the check CLI prints a deprecation note on stderr when
    a context selects them (report and st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
2026-10-23 skills: register routing hubs and correct README counts (architecture step 1, B4a)
    Hubs in tools/wiring_known_gaps.json for pages that already route their topic (hep-theory cosmic-ray-propagation,
    hep-ml deep-learning-guide, hep-computing agile/task-authoring/batch-scheduling, hep-detector detector-simulation,
    hep-authoring papers and diagrams guides); README counts for hep-computing, hep-ml, hep-statistics. No SKILL.md or
    entry-reference bytes change; 58 known gaps removed, 17 hep-authoring pages left for B4b.
2026-10-23 tests: tag_and_probe_efficiency reads files, list it in MISSING_FILE_ARGS (wiring R2)
    The wiring lint found three NO_INPUT_FILE scripts that read a file named by an argument. tag_and_probe_efficiency
    already meets both CLI contracts and moves; the force-field and training-memory scripts give a text error on a missing
    file and stay known gaps until they print a JSON status.
2026-10-23 fix: force-field and training-memory scripts tested on a missing input file (wiring R2)
    solar_modulation_force_field.py prints invalid-input errors as a JSON status (failed, invalid-input) on stdout, exit 2,
    like tag_and_probe_efficiency.py; estimate_training_memory.py already does with --json. Both move from NO_INPUT_FILE
    to MISSING_FILE_ARGS; the two R2 known gaps and their baseline entries are removed (17 left, all hep-authoring B4b).
2026-10-23 chore: remove the hep-measurement data-pipelines pointer (moved in 0.7.0)
    Its removal release 0.29.0 was recorded in tools/wiring_known_gaps.json, so the 0.29.0 bump would have failed the
    wiring check. Three hep-computing links repointed (analysis-data-pipelines.md; for the physics rules hep-measurement's
    analysis-design.md and weights-normalization.md); hep-measurement README counts twelve references.
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2026-10-23 evals: codex resume turns skip the git-repo check like the first turn
    Later turns of a multi-turn case ran 'codex exec resume' without --skip-git-repo-check and failed in the throwaway
    non-git case folder (t19-turns-2 in the first live Codex run). Test added.
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2026-10-23 hep-theory: Th13 sources re-read in full text and corrected (TH13-SOURCES)
    The cosmic-ray phenomenology, solar modulation and new-physics pages had been written from a summarizing fetch. All
    cited sources were re-read in full text (49 arXiv PDFs at the cited versions, ICRC proceedings, Bartels sources; one
    paywalled JGR paper not opened and no longer relied on); about 165 statements checked, about 30 corrected (locators,
    overstated or misread findings, author initials and order), then the diff was rechecked by a separate reader. Pages
    now state full-text read level; VALIDATION TH13-SOURCES, ledger documentation_fixes entry, matrix row, CHANGELOG.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
2026-10-23 hep-theory: hadron structure phase 1, unpolarized inclusive DIS (Th14)
    Entry page hadron-structure-essentials.md (registered hub, modules B-H planned) and dis-structure-functions.md
    (NC photon, gamma-Z, Z; CC; LO quark-parton model; heavy quarks, TMC, higher twist as rules), sources read in full
    text (PDG 2026 Structure Functions, Schienbein et al. 2008). New scripts structure_functions_lo.py and sum_rules.py
    with tests on constructed inputs. 13 core convention keys, also listed as conditional_convention_keys so the
    every-derivation completeness rule skips them. Capability dis-structure-functions (Th14) and out-of-v1 notices
    hadron-models, quarkonium-production, jets-in-dis with routing case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
2026-10-23 hep-theory: hadron structure phase 2, Drell-Yan (Th15)
    drell-yan.md (LO cross section derived from PDG 2026 cross-section formulae; x_F definitions, rapidity frames, angular
    coefficients, Collins-Soper and helicity frames, frame invariants, Lam-Tung; NLO and resummation as rules; sources
    read in full text) and drell_yan_lo.py (xsec for photon exchange with Z refused, convert, frames, lam-tung,
    coefficients). Capability drell-yan (Th15), hub row C, routing set Th15. Independent review findings fixed test-first
    (allowed angular domain now exact, input guards, Peng et al. quotation).
2026-10-23 hep-theory: hadron structure phase 6, small x (Th19) and exclusive processes and GPDs (Th20)
    small-x-and-saturation.md (dipole factorization, GBW model, BK/JIMWLK and running coupling as rules, nuclei, status
    labels) and exclusive-and-gpd.md (DVCS kinematics, BMK and Trento azimuths, GPD properties and sum rules, diffractive
    DIS); sources read in full text. New scripts dipole_lo.py (SciPy) and exclusive_kinematics.py; sum_rules.py GPD rules.
    Capabilities small-x-saturation (Th19) and exclusive-and-gpd (Th20), hub rows F and H, routing cases. Independent
    review findings fixed test-first.
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2026-10-23 feat(design): detector system design M2, fidelity and sensitivity
    Implements milestone M2 of the detector system design spec:
    - parameter-level invalidation: envelope inputs[].binding "parameters" (ART-73),
    dependencies.py warns instead of stale (TRC-06), design.py parameter_digest (TRC-04..TRC-08)
    - run_workflow.py: argv, script_sha256, plugin_release, NumPy version, parameter_digest,
    --incremental (INC-01..INC-04)
    - evaluate_design.py: parameter-bound evaluations, --replace (stale only), --digest-only,
    --input-artifact; response (CHN-01), geometry (ART-33..ART-35), f4 (ART-31, ART-32)
    - design_estimates.py: infield-acceptance (F2), response-assembly (F3),
    precision-from-result (F3,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
2026-10-23 fix(design): review round 1 — shared budget items cancel in the comparison basis, all ranking reasons, dispositions only for surviving candidates, offset upstream for charge confusion
    ART-15: budget items two candidates carry unchanged cancel in the difference and its uncertainty;
    RPT-07: a refused ranking lists every reason; RPT-05/MAT-04 d: screened-out candidates get no
    proposed disposition and H4 asks none for them, derived rows say why they have none; ADQ-07:
    charge-confusion-rate compliance also needs rigidity-scale-offset; the rendering states the H4
    state and 'orphan runs: none'. Both examples' equal-mass bases now hold; ranking still refused (CHN-06).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
2026-10-23 fix(design): review round 2 — cancel only the same subsystem, H4 after H1-H3, relative record paths
    ART-15: a budget item cancels in the comparison basis only when both candidates carry the same
    subsystem (identical merged definition) with the same budget row; the basis line states the
    quantity, CL and criterion. Example B's 2.0 T solenoid and coarser ECAL carry their own catalog
    masses (basis does not hold; ranking refused for ART-15 and CHN-06). H4 sets the review axis only
    when no earlier gate flag is open (interpretation). Required upstreams are listed with their own
    compliance fidelity (rigidity-scale-offset at F5). Decision records are named relative to the
    decisions folder's parent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
2026-10-24 docs(geant4): re-plan the program against main's detector design loop
    Rewrites the consolidated document (zh original and en translation) after
    the review against main 0.38.0, with the user's decisions: full rewrite,
    the search as `evaluate_design.py search`, and a qualification path for
    detector-level Geant4 studies to count as F4 (decision D0, pending the
    maintainer).
    - Baseline main 5584927 (0.38.0, contracts 3.12.0); main's fidelity names
    F0-F5 throughout; contract changes named CV-A1, CV-B2, CV-C1, CV-C2.
    - A1: adds D11 (convergence gate on supplied, not declared, scan values)
    and the F4-consumer fixes (`f4` passes run records to `label`, exit 3 is
    incomplete); ledger and advisor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
2026-10-24 docs(geant4): fixes from the fresh independent read-through; D0 v2
    A reviewer who had not seen the editing history read the whole document
    against the code (35 of 37 citations correct). Fixes:
    - D0 v2: material definition replaces material-benchmark scope (J15
    could never meet it); per-class scope conjunction in CV-B2; the
    multiple-scattering reference (Lynch-Dahl) qualifies the resolution
    core only; charge confusion needs a tail benchmark (D0-b); the F4
    uncertainty policy (D0-c) is the real decision, since a statistical-only
    F4 estimate is always uncertainty.missing under the adequacy minima;
    screening-only complement offered (D0-d). The model envelope is not
    added to the F4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
2026-10-24 docs(geant4): reorganise the document; history and reviews in Part 6
    Puts the corrections into the document and reorganises it for an agent
    reader:
    - Front matter: how to use by role, a reading index per stage (sections,
    gates, blocking decisions, checks), conventions and a 33-row global
    glossary.
    - Parts 1-4 state only the current specification: revision wording,
    version-history appendices and old-to-new tables moved out. Section
    1.1 now describes the relation to main (what main provides, the gaps
    each stage fills); 7.1 holds D0 in full.
    - Part 5: "relation to main's design loop" moved to R.1, the other
    sections renumbered R.2-R.15 with every reference updated; decision log
    a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
2026-10-24 test: J14 replay cache is forgotten at module teardown (D10)
    test_simulated_dataset shares test_geant4_upgrade's replay cache; the teardown
    deleted the folder but kept the path, so 5 tests errored when both modules ran
    in one process. Geant4 program stage A1, A1.12.
2026-10-24 sci-fix: every scope dimension of a Geant4 benchmark must be declared (geant4-scope-missing-dimension, D1)
    GEANT4_BENCHMARKS gives each benchmark its scope dimensions (particle and
    material categorical, energy and thickness intervals; longitudinal-profile:
    particle, energy and the target hash). Under CV-A1 every dimension must be in
    the declared scope and inside the benchmark's: categorical by set inclusion,
    interval by interval inclusion (a scalar is [v, v]), the target hash by
    equality with the same hash_scheme. Before, a dimension missing from the
    declaration was unconstrained.
    Evidence: tests/contracts/test_geant4_a1.py::ScopeDimensions (each dimension
    missing, inside or outside, throug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
2026-10-24 sci-fix: a counted Geant4 benchmark needs an isolated target, re-derived from its run record (geant4-isolation)
    contracts.validate.geant4_spec_v1 derives configuration and target hash
    (hash_scheme spec-v1: the target's placements in order, thickness, transverse
    size, material and declared composition, numbers as float.hex()) from the
    spec/1 of a run record; isolated means a vacuum world (G4_Galactic or density
    < 1e-20 g/cm3) and every placement in the target (target_slabs, default the
    measured slab). geant4_benchmarks.py writes configuration, target hash,
    target_slabs and configuration_basis for every result and counts a
    reference/setup-matched result as evidence only when isolated (setup-ma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
2026-10-24 sci-fix: the Geant4 convergence gate needs every declared scan value (geant4-gate-scan-completeness, D11)
    check_geant4_study.py run: a declared value of a scan
    (convergence_plan.parameters[].values) without a scan or nominal summary makes
    that parameter, and the gate, incomplete (exit 3, reason missing-scan-value,
    missing values listed); the two finest are the two finest declared values.
    Before, the gate took the two finest among the supplied summaries, so a missing
    finest run let it pass on coarser ones (the protocol asked users to check this
    by hand; it now says the code checks it). Trace tag
    geant4-convergence-complete. J14's decisions unchanged (both studies supply
    all three cuts).
    Evid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
2026-10-24 feat(design-search): standard-library searcher, role rules and materials table (geant4 C1.2, C1.5)
    - skills/hep-detector/scripts/design_search_lib/: Sobol points from the Joe-Kuo
    direction numbers (equal to scipy.stats.qmc.Sobol unscrambled), NSGA-II over
    real, integer, categorical and bit genes (SBX, polynomial mutation, constrained
    domination, crowding; bit-for-bit reproducible), exact hypervolume (WFG with
    exact two- and three-objective sweeps).
    - assets/design-search/: roles.json (realization rules 1.0.0 for tracking,
    bending, tof, calorimetry-em, rich: parameters, ranges, tolerances, derived
    per-plane x/X0, calibration template, assumed budget model), materials.json
    (1.0.0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
2026-10-24 chore(contracts): 3.13.0 (CV-C1 placeholder) — fixtures, templates, pinned tests, profile artifacts, examples
    CONTRACTS_VERSION 3.13.0 for the search_summary of CV-C1 (minor, P.7 item 13; no
    capability). The number is the stage's placeholder: if stage A1 (CV-A1) merges
    first with 3.13.0, this commit is redone with the next minor and
    validate.SEARCH_SUMMARY_FROM follows. Fixtures (make_fixtures.py,
    design_fixtures.py), templates, the theory-profile artifacts and 13 examples
    regenerated with E2: only the version strings and the hashes that cover them
    change.
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2026-10-24 docs(sci-fix): Geant4 A1 ledger entries, advisories SFA-2026-039/040, protocol, VALIDATION GEANT4-CORRECTNESS
    - docs/evidence/sci-fixes.json: 13 entries (GEANT4-GRADE-TABLE ... DESIGN-F4-
    LABEL-PASSTHROUGH) with independence records, parent records run on each
    parent and fix commit, and the gaps of entries below their minimum (the D3-D5
    entries are D1; the S1 entries are C2 and need the maintainer's review); two
    documentation entries (D6 stopping rule, D7 evidence overlap; internal
    sources only, stated as gaps).
    - Advisories SFA-2026-039 (S1) and SFA-2026-040 (S2), introduced 0.20.0, no
    fixed event before the release; acceptance-matrix rows.
    - geant4-study-protocol.md section 4 r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
2026-10-24 fix(design-search): base-slot extents fall back to base parameter values
    SearchSpace.violation read the calorimeter/RICH extent only from the decoded
    free parameters of a base slot. Freeing z_front_m alone raised a KeyError on
    depth_X0, absorber_material or radiator_length_cm; freeing those without
    z_front_m silently skipped the envelope and overlap checks. A parameter that
    is not free now takes the base candidate's value; the slot is skipped only
    when the base has no value either. Regression tests cover both cases.
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2026-10-24 fix(geant4): §A.8 checks for A1, C1, A2 — agent runs, reviews and their fixes
    - New problems run by agents that did not write the code (stopping power
    study, F1 search): all pass conditions met; the problems they found are
    fixed or listed in the follow-up issue.
    - geant4_run.py completes layered_sim's summary with the run fields the
    study check reads; scan gives every point S = H(study_id, role, point id)
    (also for a per-event base spec) and passes S, role and point id to run.
    - check_geant4_study.py: exact hadronic list names; EM constructor from the
    suffix or the list itself (Geant4 11.4.3 sources); any declared observable
    for the gate; optional stopping_rule in the study sp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
2026-10-24 feat(geant4): stage B1 — element_sim, simroot, check-spec, from-geometry (adapter 0.3.0)
    - element_sim: box elements with one level of nesting, uniform field regions
    (explicit DormandPrince745 + InterpolationDriver, thread-local managers,
    step limits on field elements and daughters), plane crossings of every
    charged track, calorimeter leakage by face (net outflow), primary path
    lengths, per-event seeding only, the three boundary artifacts and a
    per-event ROOT file (element_sim.events/1) through Geant4's g4tools.
    - simroot: info, dump and hash of event files with G4RootAnalysisReader;
    content_sha256 independent of threads and job splits.
    - geant4_run.py: program dispatch by sche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
2026-10-25 feat(geant4): stage C3 — J16 automated candidate generation on Examples A and B
    - examples/design-search-j16: F1 searches on Example A (space spectrometer) and Example B (collider tracker + ECAL),
    finalists expanded and evaluated, Example B's capability.unavailable requirements carried, reports (basis does not
    hold, ranking refused) and search --diagnose; one Example A finalist confirmed live at F4 (live.py, recorded/
    200 kB): the upgrade was refused on the multiple-scattering reference's -13 % control (beyond 1.1 DL), shown as
    recorded; space.realization.json; tests/examples/test_design_search_j16.py
    - J15 live.py: study prefix, profile name, reference slab thickness and materials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
2026-10-25 release: hep-research 0.39.0
    Ships the Geant4 program stages A1, C1, A2, B1, B2, B3, C2 and C3 with their A.8 checks and G5 confirmations
    (#274-#287); contracts 3.13.0, CORE_VERSION 1.1.0, geant4 adapter 0.5.0, adequacy table 1.2.0 (provisional).
    Version bumps, regenerated examples and profile artifacts, CHANGELOG, VALIDATION release check, reference
    inventory; the 13 stage A1 sci-fix entries name 0.39.0 and SFA-2026-039/040 are fixed in 0.39.0. J16 replays from a
    snapshot of Examples A and B's 0.38.0 artifacts (recorded/sources/): its recorded searches name the design-spec by
    sha256, which the regenerated sibling outputs changed; gate verdict snapshot extended.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
2026-10-25 feat(detector): front-end electronics for reconstruction and simulation
    - frontend_response.py: optimal-filter (correlated + Campbell pileup noise, phase/baseline
    constraints, phase and baseline bias, joint amplitude-time errors), hit-efficiency
    (Landau via Nolan's stable-law integral or Gaussian signal, charge fraction, threshold
    spread, per-sample and per-window noise occupancy, operating window), waveform-toy
    (seeded synthetic sampled readout, four estimators, closure z-scores)
    - front-end reference: sampled vs continuous occupancy, operating window, constrained
    filters, baseline gain, time from samples, ToT inversion, bandwidth and rise time,
    digital pulse processing, pulse-s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
2026-10-25 feat(detector): electronics calibration chain, S-curve fit and threshold trim
    - frontend_response.py: s-curve (binomial ML fit of a threshold scan with inverse-Fisher
    errors and deviance; scan design mode) and threshold-trim (residual dispersion after a
    trim DAC, exact at the range edge, DAC nonlinearity)
    - front-end reference: calibration of the electronics rewritten as an ordered chain
    (robust pedestals and noise covariance, S-curve fit and design, trim,
    templates and weights, calibration closure in simulation, monitoring)
    - readout-digitization-and-overlay.md: calibration closure check
    - tool contract 15 operations; 5 more tests (31 in test_frontend_waveforms.py);
    CHANGELOG, VAL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
