hchouTW/hep-research/(notices)

Notices in the files:
plugins/hep-research/CHANGELOG.md:
The plugin is published under the Apache License 2.0 (`LICENSE` at the repository root and inside the plugin folder,
subject was the earlier development repository are gone; the remaining references, examples and tests cite this
